MynhLoveBunCha/project_1_undergraduate/exploded_base_assembly.jpg

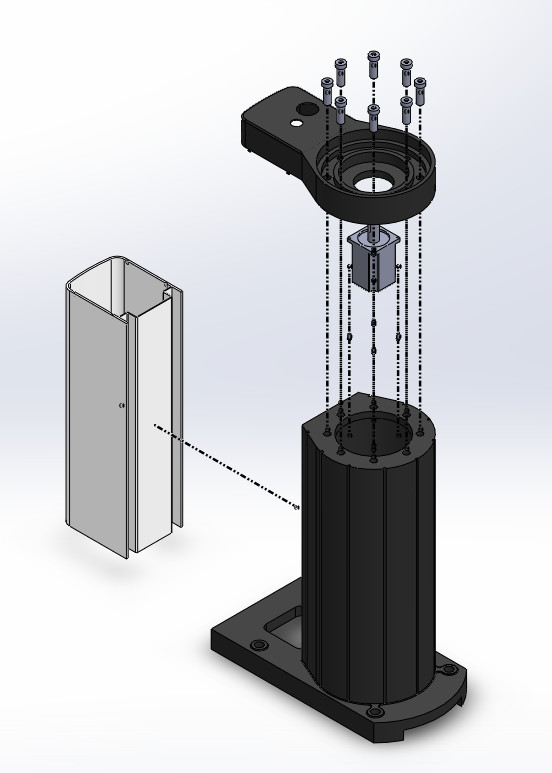
exploded_base_assembly.jpg
