MynhLoveBunCha/project_1_undergraduate/exploded_whole.jpg

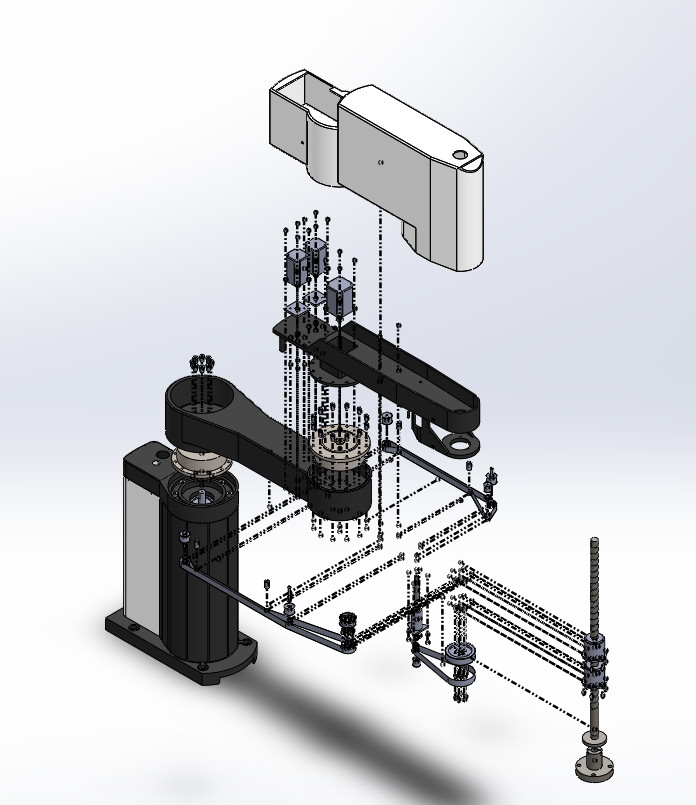
exploded_whole.jpg
