MynhLoveBunCha/project_1_undergraduate/README.md

# project_1_undergraduate
 Course project about mechanical design of a SCARA robot
