MynhLoveBunCha/project_1_undergraduate/tran_duy_minh_main_report.pdf

i

ii

LỜI CẢM ƠN

Nhóm chuyên môn: Thiết kế hệ thống cơ khí, Khoa Cơ điện tử, Trường Cơ khí, Đại học Bách khoa Hà Nội.
Dưới sự hướng dẫn nhiệt tình của TS.Nguyễn Hồng Thái em đã vận dụng những kiến thức đã được học trong chương trình đào tạo đại học, ĐH Bách Khoa Hà Nội để hoàn thành đề tài, nhờ đó em có thể hoàn thiện, tổng hợp kiến thức trước khi tốt nghiệp Đại Học.
Tuy nhiên với kiến thức chuyên môn còn hạn chế nên đề tài không thể tránh khỏi những thiếu sót và chưa thể hoàn thiện một cách hoàn hảo như ý muốn mong đợi. Mong được sự giúp đỡ và góp ý của các thầy để em có thể hoàn thiện hơn.
Để hoàn thành đồ án tốt nghiệp này em xin trân trọng cảm ơn tất cả các thầy cô giáo trong Đại Học Bách Khoa Hà Nội, nhất là các quý thầy cô trong Viện Cơ Khí, Bộ môn Cơ sở thiết kế máy và rôbốt, Trung tâm công nghệ cao BK-CNC đã hướng dẫn em trong suốt năm năm vừa qua. Em xin bày tỏ lòng biết ơn sâu sắc tới thầy giáo hướng dẫn TS. Nguyễn Hồng Thái, người đã tận tình hướng dẫn và tạo mọi điều kiện thuận lợi để em hoàn thành đồ án này.

Em xin trân trọng cảm ơn !

Hà Nội, ngày 2 tháng 8 năm 2023

Sinh viên

Trần Duy Minh

iii

### MỤC LỤC

DANH MỤC CÁC KÝ HIỆU VÀ CÁC TỪ VIẾT TẮT | 1
DANH MỤC CÁC HÌNH VẼ VÀ ĐỒ THỊ | 4
DANH MỤC CÁC BẢNG | 6
MỞ ĐẦU | 7
CHƯƠNG 1 BÀI TOÁN ĐỘNG HỌC | 8
1.1 CÁC THÔNG SỐ KĨ THUẬT CỦA ROBOT TURBO SCARA SR4/6/8 | 8
a) Giới thiệu về robot | 8
b) Cấu hình robot Turbo Scara SR8 plus | 9
c) Các thông số kĩ thuật robot Turbo Scara SR8 plus | 10
1.2 THIẾT LẬP PHƯƠNG TRÌNH ĐỘNG HỌC CỦA ROBOT | 12
a) Thiết lập hệ quy chiều và bảng thông số động học D-H | 12
b) Các ma trận biến đổi thuần nhất | 12
c)Phương trình động học | 14
d) Ví dụ áp dụng | 16
1.3 BÀI TOÁN MIỀN LÀM VIỆC | 18
a) Cơ sở lí thuyết | 18
b) Phương pháp hình học | 18
1.4 THIẾT LẬP BIỂU THỨC TÍNH VẬN TỐC TRỌNG TÂM CÁC KHÂU | 21
a) Vận tốc dài các khâu | 21
b) Vận tốc góc các khâu | 22
1.5 THIẾT LẬP BIỂU THỨC TÍNH GIA TỐC TRỌNG TÂM CÁC KHÂU | 24
a) Gia tốc dài | 24
b) Gia tốc góc | 24
1.6 KẾT LUẬN | 25
CHƯƠNG 2 PHÂN TÍCH TĨNH HỌC | 26
2.1 PHÂN TÍCH LỰC ROBOT | 26

2.2 THIẾT LẬP PHƯƠNG TRÌNH TRUY HỒI THEO PHƯƠNG PHÁP NEWTON-EULER 27

2.3 TÍNH LỰC VÀ MOMEN TẠI CÁC KHỚP | 28
2.3 KẾT QUẢ TÍNH TOÁN | 32
2.5 LỰA CHỌN KẾT CẤU SƠ BỘ | 35
2.5.1 Giới thiệu các loại hộp giảm tốc dùng trong robot | 35
a) Chọn bộ truyền động cho khớp 1 và khớp 2 | 35
b) Chọn bộ chuyền động cho khớp 3 và khớp 4 | 36
2.5.2 Bản vẽ sơ bộ các khâu của robot | 37
2.5.3 Xác định khối lượng, trọng tâm các khâu trên solidworks | 382
2.5.3 Xác định khối lượng, trọng tâm các khâu trên solidworks | 39

iv

3.1 THIẾT LẬP PHƯƠNG TRÌNH ĐỘNG LỰC HỌC BẰNG PHƯƠNG PHÁP NEWTON-

PHỤ LỤC |
A PHẦN LẬP TRÌNH MÔ PHỎNG |
B BẢN VẼ THIẾT KẾ |

DANH MỤC CÁC KÝ HIỆU VÀ CÁC TỪ VIẾT TẮT

Ký hiệu | Nội dung, ý nghĩa
s1 | : sin θ1
s2 | : sin θ 2
c1 | : cos θ1
c2 | : cos θ 2
s12 | : Sin ( θ1
+

θ 2
)

c12 : cos( θ1
+

θ 2
)

s12-4 : sin( θ1
+

θ 2 -

θ 4
)

c12-4 : cos( θ1
+

θ 2 -

θ 4
)
θ12 | : θ1 + θ 2
θ12-4 | :

θ1
+

θ 2 -

θ 4

i

i C
−1

: Ma trận biến đổi tọa độ từ hệ quy chiếu i về i-1

Ci

0

: Ma trận biến đổi tọa độ từ hệ quy chiếu i về hệ quy chiếu cố định 0

Ri

0

: Ma trận cosin chỉ hướng của khâu i đối với hệ quy chiếu cố định

i

i
r

−1

: Vecto thuần nhất vị trí trọng tâm khâu i đối với hệ quy chiếu cố định

Ci v

: Vận tốc dài tại trọng tâm của khâu thứ i

aCi

: Gia tốc tịnh tiến tại trọng tâm của khâu thứ i so với khâu gốc cố định

1

0
ε

: Gia tốc quay tại trọng tâm của khâu thứ i so với khâu gốc cố định

i

i
ω

−1

: Vận tốc góc của khâu thứ i so với khâu thứ i-1

ω i

0

: Vận tốc góc của khâu thứ i so với khâu gốc cố định

i

i
ω

−1 ~

: Ma trận đối xứng lệch của ma trận vận tốc của khâu thứ i so với khâu thứ i-1

K : Điểm cuối của khâu thao tác

DANH MỤC CÁC HÌNH VẼ VÀ ĐỒ THỊ

| Nội dung | Trang
Hình 1.1 | Một số loại Robot Scara hiện nay | 7
Hình 1.2 | Mô hình solidworks robot tubo scara SR8 | 8
Hình 1.3 | Cấu hình robot Tubo Scara SR8 | 9
Hình 1.4 | Hệ trục tọa độ Denavit-Hatenbeg | 11
Hình 1.5 | Tọa độ điểm cuối khâu thao tác | 13
Hình 1.12 Hình chiếu bằng của miền làm việc | 19
Hình 1.13 Miền làm việc 3D | 19
Hình 2.1 | Mô hình động học robot | 29
Hình 2.2 | Sơ đồ lựa chọn hộp giảm tốc bánh răng sóng | 38
Hình 2.3 | cấu tạo hộp giảm tốc bánh răng sóng loại 2UH | 39
Hình 2.4 | cấu tạo bộ truyền động tại khớp 3 và khớp 4 | 39
Hình 2.5 | Kết cấu sơ bộ khâu đế | 40
Hình 2.6 | Kết cấu sơ bộ khâu 1 | 40
Hình 2.7 | Kết cấu sơ bộ khâu 2 | 41
Hình 2.8 | Kết cấu sơ bộ khâu 3-4 | 41
Hình 2.9 | Kết cấu sơ bộ của Robot | 42
Hình 2.10 Khối lượng, trọng tâm khâu đế | 42
Hình 2.11 Khối lượng, trọng tâm khâu 1 | 43
Hình 2.12 Khối lượng, trọng tâm khâu 2 | 43
Hình 2.13 Khối lượng, trọng tâm khâu 3-4 | 44
Hình 2.14 Khối lượng tổng robot | 44
Hình 3.1 | Mô hình động lực học robot | 45

Hình 3.2 | Sơ đồ tính động lực hoc Newton-Euler
Hình 3.3 | Quỹ đạo đặt cho robot

Hình 3.10 Thông số kích thước hộp giảm tốc con lăn

Hình 4.1 Bản vẽ lắp tổng lắp

46

53

59

61

### DANH MỤC CÁC BẢNG

STT | Nội dung | Trang
Bảng 1.1 | Bảng các thông số kích thước Tubo Scara SR8 | 9
| | 11
Bảng 1.2 | Bảng D-H robot scara
Bảng 3.1 | Bảng thông số động lực rôbốt Scara 4 bậc tự do | 47
Bảng 3.2 | Các thông số kích thước hộp giảm tốc khớp 3 | 60
Bảng 3.3 | Các thông số kĩ thuật hộp giảm tốc khớp 3 | 60
Bảng 3.4 | Các thông số kích thước hộp giảm tốc khớp 4 | 60
Bảng 3.5 | Các thông số kĩ thuật giảm tốc khớp 4 | 60

### MỞ ĐẦU

I. Đặt vấn đề

Robot Scara ra đời vào năm 1979, đây là một kiểu tay máy có cấu tạo đặc biệt được sử dụng nhiều trong các công việc lắp ráp. Nó thực hiện những công việc đòi hỏi độ chính xác cao. Robot Scara đã và đang được ứng dụng và phát triển rộng rãi trên toàn thế giới, chúng được chế tạo và phát triển với quy mô lớn. Tuy nhiên, ở Việt Nam việc nghiên cứu và phát triển vẫn còn hạn chế cả ở các viện nghiên cứu và các trường đại học. Do nhu cầu thực tế và niềm say mê nghiên cứu dưới sự hướng tận tình của T.S Nguyễn Hồng Thái, Khoa Cơ điện tử - Trường Cơ khí - Đại học Bách khoa Hà Nội, chúng em lựa chọn đề tài “ Tính toán thiết kế robot Scara 4 bậc tự do”.

II. Mục đích nghiên cứu của đề tài

Mục đích của đề tài trước hết là tìm hiểu làm quen với việc nghiên cứu khoa học và áp dụng các kiến thức đã học vào thực tế. Trong quá trình nghiên cứu thực tế đề tài đã giúp chúng em nâng cao kiến, tiếp cận những vấn đề mới của thực tế cũng như làm nền tảng vững chắc cho kỹ sư cơ điện tử sau khi tốt nghiệp.

III. Phạm vi nghiên cứu của đề tài

- Tính toán động học, tĩnh học và động lực học, đưa mô hình robot vào phần mềm lập trình mô phỏng để kiểm chứng kết quả tính toán
- Thiết kế kết cấu robot dựa trên kết cấu của Robot Scara SR8

IV. Nội dung của đồ án

Nội dung của đồ án được chia làm 4 chương như sau:

Chương 1 : Bài toán động học.
Chương này trình bày bài toán động học thuận động học ngược, trình bày bài toán miền làm việc, tính toán vận tốc và gia tốc các khâu, mô phỏng động học của robot bằng matlab với dao diện Guide.

Chương 2 : Bài toán tĩnh học.
Chương này tình bày về bài toán tĩnh học, tính toán tĩnh học robot băng phương pháp Newton-Euler, chọn được hộp giảm tốc tại các khớp, đưa ra bản vẽ sơ bộ các khâu của robot, và xác định trong tâm các khâu bằng Solidworks.

Chương 3 : Bài toán động lực học.
Chương này trình bày bài toán động lực học, thiết lập phương trình truy hồi Newton-Euler cho robot, tính lực và momen tại các khớp, tính chọn hộp giảm tốc tại các khớp, tính toán kết cấu các trục.
Chương 4 : Tính toán thiết kế cơ khí.

Chương này trình bày các bản vẽ thiết kế của robot.

## Chương 1

## BÀI TOÁN ĐỘNG HỌC

### 1.1 CÁC THÔNG SỐ KĨ THUẬT CỦA ROBOT TURBO SCARA SR4/6/8

a) Giới thiệu về robot

Robot Scara là một trong những robot công nghiệp được sử dụng phổ biến nhất hiện nay. Chuyển động của robot này rất đơn giản nhưng lại phù hợp với các dây chuyền và ứng dụng hữu hiệu trong nhiệm vụ nhặt và đặt sản phẩm. Robot Scara (Selectively Compliant Articulated Robot Arm) có nghĩa là tay máy lắp ráp chọn lọc.
Cấu trúc động học loại tay máy này thuộc hệ phỏng sinh, có các trục quay, các khớp đều là thẳng đứng. Nó có cấu tạo hai khớp ở cánh tay, một khớp ở cổ tay và một khớp tịnh tiến. Các khớp quay hoạt động nhờ động cơ điện có phản hồi vị trí. Khớp tịnh tiến hoạt động nhờ xi-lanh khí nén, trục vít hoặc thanh răng.

Một số loại robot scara của các hãng sản xuất

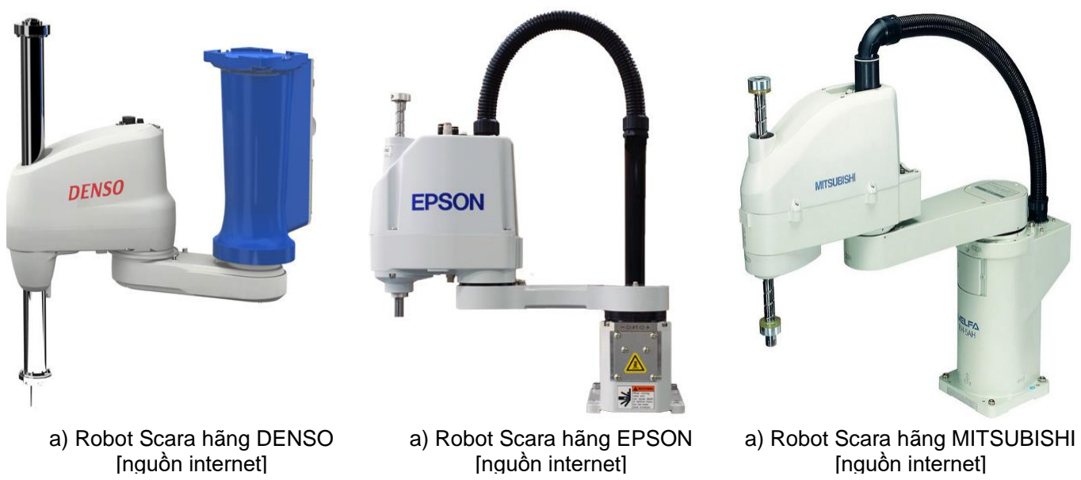
[picture p3: figure]
a) Robot Scara hãng DENSO [nguồn internet]; a) Robot Scara hãng EPSON [nguồn internet]; a) Robot Scara hãng MITSUBISHI [nguồn internet]

Trong phạm vi đồ án này tác giả đã sử dụng đối tượng Robot Turbo Scara SR8 Plus để nghiên cứu tính toán và thiết kế mô hình robot scara 4 bậc tự do với 3 bậc tự do quay với 1 bậc tự do tịnh tiến.

Robot Turbo Scara SR8 Plus là một loại Robot công nghiệp của hãng Rexroth thuộc tập đoàn Bosch Group, được trang bị những tính năng ưu việt trong đó phải kể đến như tính linh hoạt cao khi vận hành, phạm vi hoạt động rộng, khả năng ứng dụng rộng rãi vào quá trình dạy học và dây chuyền sản xuất, không gian làm việc lớn, độ chính xác cao, kết nối được các thiết bị ngoại vi như máy tính, PLC …, các cơ cấu được thiết kế khoa học tuân theo các tiêu chuẩn quốc tế và có tính thẩm mĩ cao.

Hình 1.1 Một số loại Robot Scara hiện nay b) Cấu hình robot Turbo Scara SR8 plus

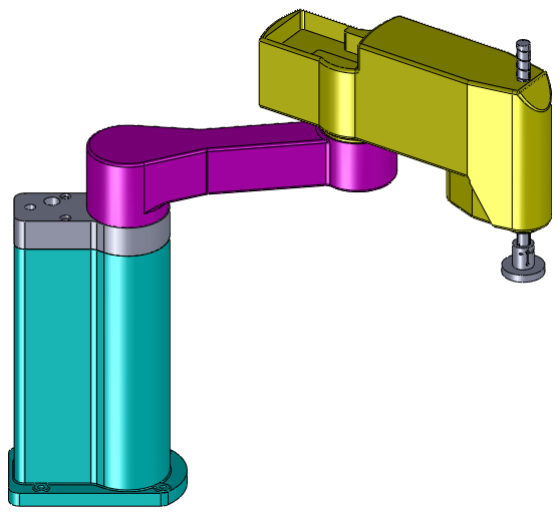
[picture p4: figure]

Robot Turbo Scara SR8 gồm 3 chuyển động quay và 1 khớp chuyển động tịnh tiến gắn cho mỗi khâu 1 hệ trục tọa độ như hình vẽ ta có.

- Khớp 1 quay xung quanh trục Z
0

một góc

θ 1

- Khớp 2 quay xung quanh trục Z
1

một góc

θ 2

- Khớp 3 chuyển động tịnh tiến dọc theo trục Z
2

một đoạn d
3
- Khớp 4 quay xung quanh trục Z
3

một góc

θ 4

Hình 1.2 Mô hình solidworks robot tubo scara SR8 c) Các thông số kĩ thuật robot Turbo Scara SR8 plus

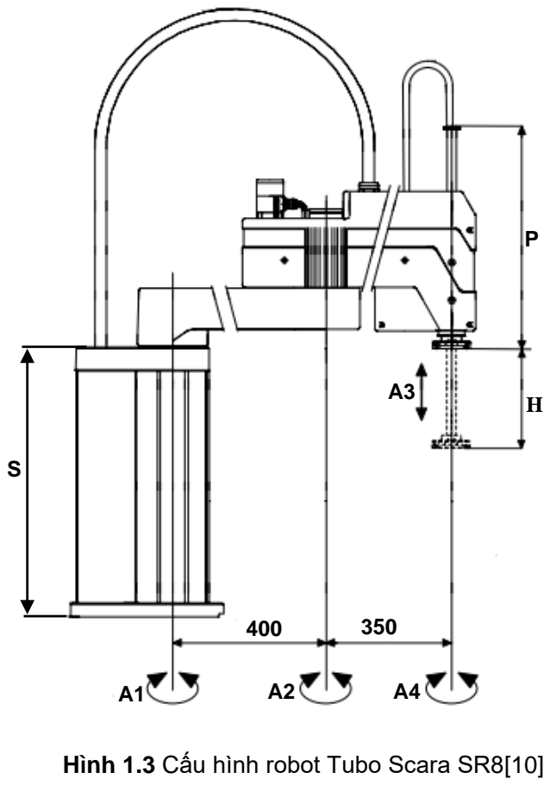
[picture p5: figure]

Tùy chọn | Thông số | Kí hiệu | Kích thước
Tiêu chuẩn | Chiều cao khâu đế | S | Tiêu chuẩn 500 tùy chọn 250-700
Hành trình trục 3 | H | 280 | 280 | 280
Chiều dài trục vít | P | 450 | 450 | 450
Chiều dày bích | F | 60 | 60 | 60
Chiều dài khâu 2 | a 1 | 400 | 400 | 400
Chiều dài khâu 3 | a 2 | 350 | 350 | 350

Bảng 1.1 Các thông số kích thước Tubo Scara SR8

Hình 1.3 Cấu hình robot Tubo Scara SR8[10]

Số bậc tự do | 4
Số khớp quay độc lập | 4
Tải trọng chuẩn | 2 | kg
Tải trọng tối đa | 6 | kg
Momen quán tính lớn nhất trục 4. | 1000 | Kg.cm 2
Momen xoắn (cho phép/lớn nhất) trục 4. | 8/10 | M.m
Lực dọc trục (liên tục/ tối đa) trục 4. | 300/350 | N
Lực ngang (liên tục/ tối đa) trục 4. | 60/120 | N
Góc quay giới hạn khâu 1 | +/- 150 |
Góc quay giới hạn khâu 2 | +/- 160 |
Giới hạn hành trình khâu 3 | 280 | mm
Góc quay giới hạn khâu 4 | +/- 180 |

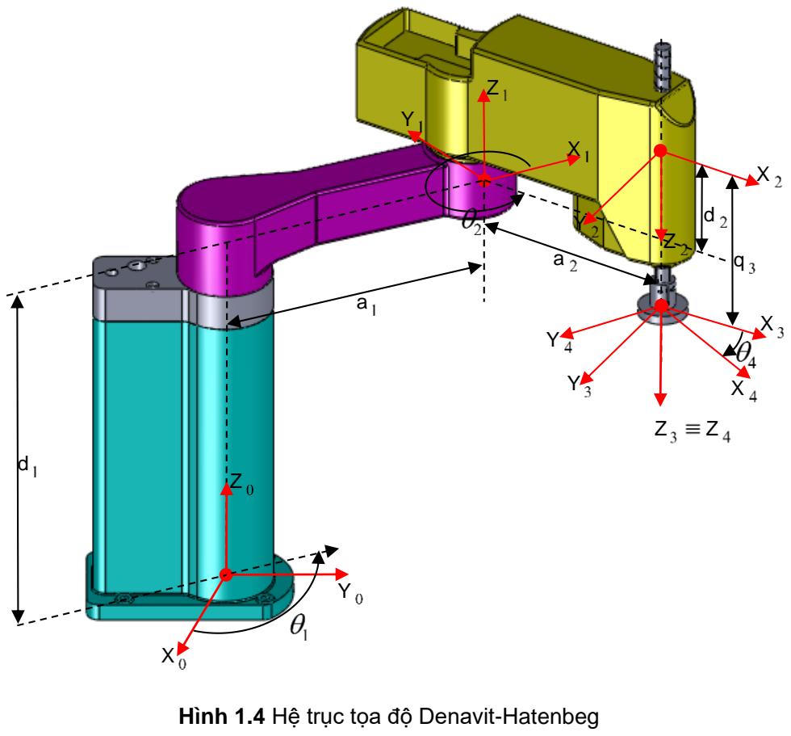
[picture p6: figure]

Bảng 1.2 Bảng D-H robot scara

### 1.2 THIẾT LẬP PHƯƠNG TRÌNH ĐỘNG HỌC CỦA ROBOT

a) Thiết lập hệ quy chiều và bảng thông số động học D-H

Xây dựng hên trục tọa độ Denavit-Hartenberg.

`

Với cách đặt hệ trục như hình 1.2 và quy tắc xác định các thông số động học theo D-H ta lập được bảng D-H.

Trục | di | θ i | ai | αi
1 | d1 | θ1 | a1 | 0
2 | d 2 | θ2 | a 2 | π
3 | q 3 | 0 | 0 | 0
4 | 0 | θ4 | 0 | 0
Trong đó: q3, θ1, θ2, θ4 là các biến khớp
b) Các ma trận biến đổi thuần nhất

Ma trận dạng tổng quát D-H của phép chuyển hệ tọa độ
Ri−1
sang

Ri
, là

i 1 Ai
−
có dạng
như sau:

Hình 1.4 Hệ trục tọa độ Denavit-Hatenbeg

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
0 | 0 | 0 | 1
0 | sin | cos
sin | cos cos | cos sin | sin
cos | sin | cos | sin | sin | cos 1

1

i | i | i
i | i | i | i | i | i | i
i | i | i | i | i | i

i

i
d

a

a

C
α | α
θ | θ | α | θ | α | θ
θ | θ | α | θ | α | θ

Thay thông số của từng khâu trên bảng D-H ta tìm được các ma trận chuyển tọa độ như sau.

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
0 | 0 | 0 | 1
0 | 0 | 1
sin | cos | 0 | sin
cos | sin | 0 | cos

1

1 | 1 | 1 | 1
1 | 1 | 1 | 1

1

0
d

a

a

C

θ | θ | θ
θ | θ | θ

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
0 | 0 | 0 | 1
0 | 0 | 1
sin | cos | 0 | sin
cos | sin | 0 | cos

2

2 | 2 | 2 | 2
2 | 2 | 2 | 2

2

1
d

a

a

C

θ | θ | θ
θ | θ | θ

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
0 0 0 1

0 0 1

0 1 0 | 0
1 0 0 | 0

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
0 | 0 | 0 1
0 | 0 | 1 0
sin | cos | 0 0
cos | sin | 0 0
4 | 4
4 | 4

4

3 | θ | θ
| θ | θ

C

Các phép biến đổi thuần nhất

0 C 2 =

0 C 1
1 C 2

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
− | +
+ | − | + | + | +
+ | | + | + | +
0 | 0 | 0 | 1
0 | 0 | 1
sin( | ) | cos( | ) | 0 | sin( ) | sin( | )
cos( | ) | sin( | ) | 0 | cos( ) | cos( | )
1 | 2
1 | 2 | 1 | 2 | 1 | 1 | 2 | 1 | 2
1 | 2 | 1 | 2 | 1 | 1 | 2 | 1 | 2
d | d
a | a
a | a
θ θ | θ θ | θ | θ θ
θ θ | θ θ | θ | θ θ

0 C 3 =

0 C 2
2 C 3

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
− | + | −
+ | − | + | + | +
+ | | + | + | +
0 | 0 | 0 | 1
0 | 0 | 1
sin( | ) | cos( | ) | 0 | sin( ) | sin( | )
cos( | ) | sin( | ) | 0 | cos( ) | cos( | )
1 | 2 | 3
1 | 2 | 1 | 2 | 1 | 1 | 2 | 1 | 2
1 | 2 | 1 | 2 | 1 | 1 | 2 | 1 | 2
d | d | d
a | a
a | a
θ θ | θ θ | θ | θ θ
θ θ | θ θ | θ | θ θ

0 C 4 =

0 C 3

3 C 4

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
− | + | −
+ | − | − | + | − | + | +
+ | − | | + | − | + | +
0 | 0 | 0 | 1
0 | 0 | 1
sin( | ) | cos( | ) | 0 | sin( | ) | sin
cos( | ) | sin( | ) | 0 | cos( | ) | cos
1 | 2 | 3
1 | 2 | 4 | 1 | 2 | 4 | 2 | 1 | 2 | 1 | 1
1 | 2 | 4 | 1 | 2 | 4 | 2 | 1 | 2 | 1 | 1
d | d | d
a | a
a | a
θ θ θ | θ θ θ | θ θ | θ
θ θ θ | θ θ θ | θ θ | θ

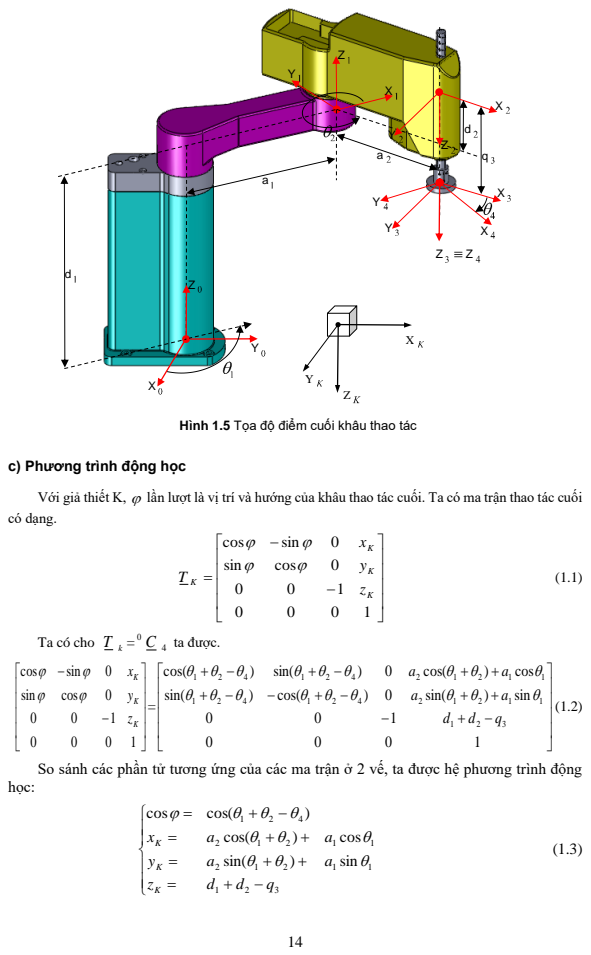
[picture p7: page 18]
sin; cos; ta được.; sin(; cos(

Hình 1.5 Tọa độ điểm cuối khâu thao tác

c) Phương trình động học

Với giả thiết K,
có dạng.

lần lượt là vị trí và hướng của khâu thao tác cuối. Ta có ma trận thao tác cuối

Ta có cho
So sánh các phần tử tương ứng của các ma trận ở 2 vế, ta được hệ phương trình động
học:

Nếu cho trước các giá trị biến khớp thay đổi theo thời gian, thì vị trí và hướng của khâu công tác (bàn kẹp) của robot SCARA trong mọi thời điểm sẽ hoàn toàn được xác định từ hệ phương trình (1.3).
- Đối với bài toán thuận ta cần tìm xK,yK,zK và
φ

Từ hệ phương trình động học ta có :

ï

ï
î

ï

ï
í

ì

= | + | −
= | + | −
= | + | +
= | + | +
1 | 2 | 4
K | 1 | 2 | 3
K | 2 | 1 | 2 | 1 | 1
K | 2 | 1 | 2 | 1 | 1
θ | θ | θ
z | d | q
y | a sin(θ | θ ) a sinθ
x | a cos(θ | θ ) a cosθ

φ

d

(1.4)

- Đối với bài toán ngược ta cần tìm
1 | 2 | 4 θ ,θ ,θ
, d3 với xK, yK, zK,
φ

đã biết

Từ (1.4) ta có :

î

í

ì

= | + | +
= | + | +
2 | 1 | 2 | 1 | 1
2 | 1 | 2 | 1 | 1
sin( | ) | sin
cos( | ) | cos
θ θ | | θ
θ θ | θ
y | a | a
x | a | a

K

K
(1.5)
Þ | [ | ] 1 2 | 1 | 2 | 1 | 1 | 2 | 1
2
2

2
1
2 | 2
xK | + yK

= a + a + 2a a (cos(θ +θ ) cosθ + sin(θ +θ )sinθ

1 2 | 2

2
2

2
1
2 | 2
xK | + yK

= a + a + 2a a cosθ

Þ

1 2

2
2

2
1
2 | 2

2
2

cos
a a
x | y | a | a K | + K | − | −
θ =

2

2
2

sinθ = ± 1− cos θ

Vậy

2 | tan2(sin ;cos ) θ | θ2 | θ2 = a

Khi biết
θ 2

ta viết lại (4) :

2 | 1 2 | 1 2 | 1 1
2 | 1 2 | 2 1 | 1 1
( | )
( | )

K

K

x | a c c | s s | a c
y | a s c | s c | a s
ì = | − | + í
î = | + | +

(1.6)

với
î

í

ì

= | =
= | =
1 | 1 | | 2
1 | 1 | 2 | 2
cos , 2 cos
sin , | sin
| θ | | θ
| θ | | θ
c | c
s | s
;
î

í

ì

+ | + | =
+ | − | =

K

K
a s c | a c | a s | y
a c | a c | a s s | x
2 2 1 | 2 2 | 1 | 1
2 2 | 1 | 1 | 2 2 1
( | )
( | )

Từ hệ phương trình (1.6) giải ra ta được :

2
2 2

2
2 2 | 1
2 2 | 2 2 | 1
2 2 | 1 | 2 2
(a c | a ) | (a s )
a s | a c | a
a c | a | a s
= | + | +
+

+ −
Δ =
2 2 | 1 | 2 2
2 2 | 1

2 2
1
x (a c | a ) y a s
y | a c | a
x | a s
K | K
K

K
= | + | +
+

−
Δ =
Þ | 2

2

2
2

2
2 2 | 1
2 2 | 1 | 2 2
1
( | )
( | )
a c | a | a s
x a c | a | y a s
c
K | | K
+ | +
+ | +
=
K | K
K

K
a c | a y | a s x
a s | y
a c | a | x
2 2 | 1 | 2 2
2 2
2 2 | 1
2 | = ( | + ) | −

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
2 2 | 1
2 2 | 1 | 2 2
1
( | )
( | )
a c | a | a s
a c | a y | a s x
s
K | K
+ | +
+ | −
=

Suy ra:

tan2( ; )

1 | 1 | 1 θ = a | s c

Từ đó có

θ 4 =θ1 +θ 2 −φ

K q = d + d − z 3 | 1 | 2

Vậy nghiệm của bài toán ngược là:

ï

ï
î

ï

ï
í

ì

= | + | −
= | + | −

=

=

K q | d | d | z

a

a

3 | 1 | 2
4 | 1 | 2
2 | 2 | 2
1 | 1 | 1
tan2(sin ;cos )

tan2(sin ;cos )

θ | θ θ φ
θ | θ | θ
θ | θ | θ

(1.7)

với

1 2

2
2

2
1
2 | 2

2
2

cos
a a
xK | + yK | − a − a
θ = | ,
2

2
2

sinθ = ± 1− cos θ

d) Ví dụ áp dụng.

Với các thông số kích thước của robot scara SR8

### a1 = 0.400; a2 = 0.350; d1 = 0.450; d2 = 0.100

- Bài toán thuận:
Giả sử ta cho giá trị của các biến khớp lần lượt như sau

3

2
; | 0.100;
2

;
3
1 | 2 | 3 | 3 | 4

π
θ

π
θ

π
θ = | = | q = d = | =

Từ phương trình động học thuận

ï

ï
î

ï

ï
í

ì

= | + | −
= | + | −
= | + | +
= | + | +
1 | 2 | 4
K | 1 | 2 | 3
K | 2 | 1 | 2 | 1 | 1
E | 2 | 1 | 2 | 1 | 1
θ | θ | θ
z | d | q
y | a sin(θ | θ ) a sinθ
x | a cos(θ | θ ) a cosθ

φ

d

(1.8)

Ta tính được vị trí và hướng của điểm tác động cuối của robot

{

xE = -0.175√3+0.200 = −0.103
yK = | 0.175+0.200√3 = 0.5214
zK = | 0.45
φ = | π
| 6

(1.9)

- Bài toán ngược:
Giả sử quỹ đạo chuyển động của điểm tác động cuối robot là một đường tròn có phương trình

ï
î

ï
í

ì

=

= | +
= | +
z | t
y | t
x | t

K

K

K

0,1.

0,2 0,1.sin(3 )

0,2 0,1.cos(3 )
(1.10)

Và góc của khâu thao tác cuối có giá trị cố định là

6

π
φ K

=

Từ hệ phương trình động học ngược của robot ta có giá trị của các biến khớp là hàm theo thời gian như sau.

ï

ï
î

ï

ï
í

ì

= | + | −
= | + | −

=

=

K q | d | d | z

a

a

3 | 1 | 2
4 | 1 | 2
2 | 2 | 2
1 | 1 | 1
tan2(sin ;cos )

tan2(sin ;cos )

θ | θ θ φ
θ | θ | θ
θ | θ | θ

(1.21)

Với

1 2

2
2

2
1
2 | 2

2
2

cos
a a
xK | + yK | − a − a
θ =
2

2
2

sinθ = ± 1− cos θ

2
2

2
2

2
2 2 | 1
2 2 | 1 | 2 2
1
( | )
( | )
a c | a | a s
x a c | a | y a s
c
K | | K
+ | +
+ | +
=
2
2

2
2

2
2 2 | 1
2 2 | 1 | 2 2
1
( | )
( | )
a c | a | a s
a c | a y | a s x
s
K | K
+ | +
+ | −
=

### 1.3 BÀI TOÁN MIỀN LÀM VIỆC

a) Cơ sở lí thuyết

Miền làm việc của robot là vùng không gian hoạt động của robot mà tại mỗi vị trí trong không gian đó robot vẫn hoạt động bình thường với đầy đủ tất cả các bậc tự do. Có rất nhiều phương pháp tính miền làm việc khác nhau như phương pháp hình học, phương pháp giải tích, phương pháp số. Tuy nhiên trong đồ án em chỉ sử dụng phương pháp hình học.

b) Phương pháp hình học

Từ phương trình tọa độ khâu thao tác cuối.
{
xK = a2 cos( θ1 + θ2) + a1 cos θ1 yK = a2 sin( θ1 + θ2) + a1 sin θ1
zK = | d1 + d2 − q3

(1.8)

Tùy vào giá trị của các biến khớp mà ta có được không gian làm việc của Robot. Do đó giải bài toán tìm không gian làm việc của Robot ta cần phải có giới hạn giá trị của các biến khớp. Theo phương trình (1.7) thì miền chỉ cần xét trong không gian mặt phẳng (Oxy) sau đó kéo lên theo phương trục z tùy theo giá trị ZK được quy định bởi giá trị biến khớp d3 sẽ được miền làm việc của Robot.

Xét trong mặt phẳng Oxy, ta tìm miền mà tọa độ
K K

x , y
nằm trong đó với điều kiện.

î

í

ì

= | + | +
= | + | +
2 | 1 | 2 | 1 | 1
2 | 1 | 2 | 1 | 1
sin( | ) | sin
cos( | ) | cos
θ θ | θ
θ θ | θ
y | a | a
x | a | a

K

K

Với các góc quay giới hạn của các khớp θ1 = ±150

∘
; θ2 = ±160

∘
. Ta xây dựng được miền tọa độ x, y sau đó kéo dài miền tọa độ x, y theo chiều trục z ta được miền làm việc của robot. Có nhiều phương pháp để mô phỏng miền làm việc, trong đồ án này tác giả mô phỏng miền làm việc sử dụng phần mềm Matlab.
Bước 1 : Khai báo nhưng thông số kích thước cố định, d1 = 450mm; d2 = 100mm; a1 = 400mm; a2 = 350mm
Bước 2 : Tạo các vector chứa phân bố của các điểm nằm trong miền làm việc dựa vào các giới hạn đã nêu ở phần các thông số kĩ thuật, θ1 = ±150o

; θ2 = ±160o

; θ1 = ±180o
; q3 = 280mm
Bước 3 : Dùng các phép toán trên ma trận để biểu diễn hệ phương trình tọa độ khâu thao tác cuối
(1.8) trong Matlab
Bước 4 : Dùng hàm plot3 để vẽ miền làm việc.
Hình dưới đây là đoạn chương trình trong Matlab và miền làm việc đã được mô phỏng.

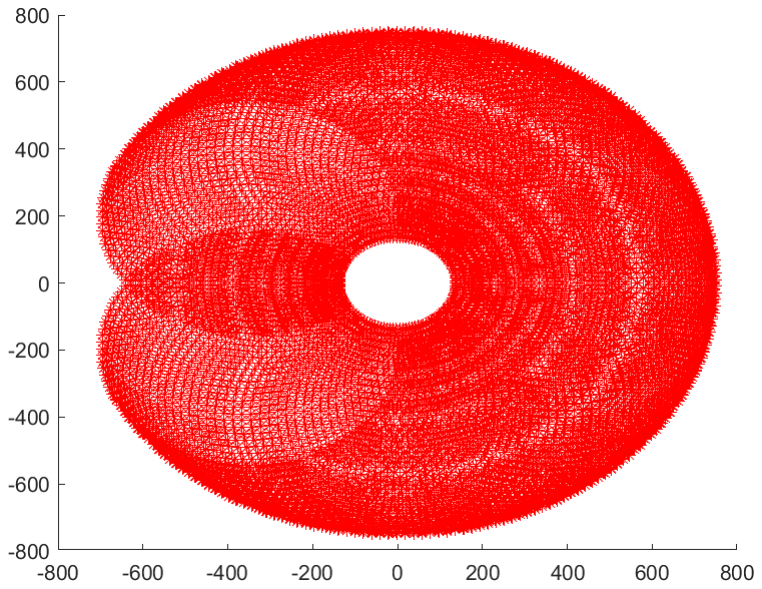
[picture p8: figure]

Hình 1.11 Hình chiếu bằng của miền làm việc

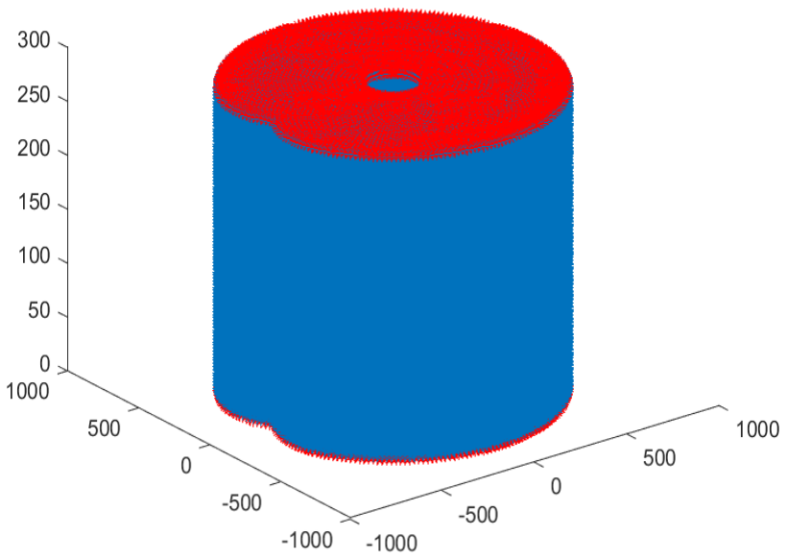
[picture p9: figure]

Hình 1.11 Hình chiếu trục đo của miền làm việc

### 1.4 THIẾT LẬP BIỂU THỨC TÍNH VẬN TỐC TRỌNG TÂM CÁC KHÂU

a) Vận tốc dài các khâu

Ta có tọa độ trọng tâm của các khâu dược tính theo công thức sau.

0
r Ci
=

0 C i

i
r Ci
(1.9)

0
r Ci

là vectơ thuần nhất tọa độ trọng tâm của các khâu.

i
r Ci

là vectơ thuần nhất tọa độ trọng tâm của khâu i trên hệ tọa độ gắn liền với khau i.

i
r Ci
=[ | 1] Ci
i
Ci

i
Ci
iX | Y | Z

T

- Vận tốc trọng tâm khâu 1.

Ta có

0
r C1 =

0 C 1

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
é | −
0 | 0 | 0 | 1
0 | 0 | 1
sin | cos | 0 | sin
cos | sin | 0 | cos

1

1 | 1 | 1 | 1
1 | 1 | 1 | 1

d

a

a
θ | θ | θ
θ | θ | θ

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
é− −

1

0

0

( | ) 1 | 1 a | l

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
1 | 1
1 | 1

d

l

l
θ

θ

Đạo hàm theo thời gian biểu thức trên trong hệ quy chiếu cố định ta được.

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
1 | 1
1 | 1
θ | θ
θ | θ

l

l

Lấy 3 hàng trong một cột trên ta được vận tốc trọng tâm khâu thứ nhất.

0
v C1 =
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
1 | 1
1 | 1
θ | θ
θ | θ

l

l

- Vận tốc trọng tâm khâu 2.

Ta có

0
r C 2 =

0 C 2

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
− | +
+ | | + | + | +
+ | − | + | + | +
0 | 0 | 0 | 1
0 | 0 | 1
sin( | ) | cos( | ) | 0 | sin( ) | sin( | )
cos( | ) | sin( | ) | 0 | cos( ) | cos( | )
1 | 2
1 | 2 | 1 | 2 | 1 | 1 | 2 | 1 | 2
1 | 2 | 1 | 2 | 1 | 1 | 2 | 1 | 2
d | d
a | a
a | a
θ θ | θ θ | θ | θ θ
θ θ | θ θ | θ | θ θ

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
é− −

1

0

0

( | ) 2 | 2 a | l

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
+ | +
+ | +

1

sin | sin( | )
cos | cos( | )
1 | 2
1 | 1 | 2 | 1 | 2
1 | 1 | 2 | 1 | 2
d | d
a | l
a | l
θ | θ θ
θ | θ θ

Đạo hàm theo thời gian biểu thức trên trong hệ quy chiếu cố định ta được.

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
+ | + | +
− | − | + | +

0

0

cos | ( | ) cos( | )
sin | ( | )sin( | )
1 1 | 1 | 2 | 1 | 2 | 1 | 2
1 1 | 1 | 2 | 1 | 2 | 1 | 2
θ | θ | θ θ | θ θ
θ | θ | θ θ | θ θ
a | l
a | | l

Lấy 3 hàng trong một cột trên ta được vận tốc trọng tâm khâu thứ hai.

0
v C 2 =
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
+ | + | +
− | − | + | +

0

cos | ( | )cos( | )
sin | ( | )sin( | )
1 1 | 1 | 2 | 1 | 2 | 1 | 2
1 1 | 1 | 2 | 1 | 2 | 1 | 2
θ | θ | θ θ | θ θ
θ | θ | θ θ | θ θ
a | l
a | | l
- Vận tốc trọng tâm khâu 3 và khâu 4.

Do trọng tâm khâu 3
≡

khâu 4 nên ta chỉ xét vận tốc trọng tâm khâu 3.

Ta có

0
r C3 =

0 C 3

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
− | + | −
+ | | + | + | +
+ | − | + | + | +
0 | 0 | 0 | 1
0 | 0 | 1
sin( | ) | cos( | ) | 0 | sin( ) | sin( | )
cos( | ) | sin( | ) | 0 | cos( ) | cos( | )
1 | 2 | 3
1 | 2 | 1 | 2 | 1 | 1 | 2 | 1 | 2
1 | 2 | 1 | 2 | 1 | 1 | 2 | 1 | 2
d | d | q
a | a
a | a
θ θ | θ θ | θ | θ θ
θ θ | θ θ | θ | θ θ

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
+ | + | −
+ | +
+ | +

1

sin | sin( | )
cos | cos( | )
1 | 2 | 4 | 3
1 | 1 | 2 | 1 | 2
1 | 1 | 2 | 1 | 2
d | d | l | q
a | a
a | a
θ | θ θ
θ | θ θ

Đạo hàm theo thời gian biểu thức trên trong hệ quy chiếu cố định ta được.

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
+ | + | +
− | − | + | +

0

cos | ( | )cos( | )
sin | ( | )sin( | )

3

1 1 | 1 | 2 | 1 | 2 | 1 | 2
1 1 | 1 | 2 | 1 | 2 | 1 | 2

q

a | a
a | a

θ | θ | θ θ | θ θ
θ | θ | θ θ | θ θ

Lấy 3 hàng trong một cột trên ta được vận tốc trọng tâm khâu thứ ba vả khâu thứ tư.

0
v C3 =
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
+ | + | +
− | − | + | +

3

1 1 | 1 | 2 | 1 | 2 | 1 | 2
1 1 | 1 | 2 | 1 | 2 | 1 | 2
cos | | ( | | ) cos( | | )
sin | ( | )sin( | )

q

a | a
a | a

θ | θ | θ θ | θ θ
θ | θ | θ θ | θ θ
b) Vận tốc góc các khâu
- Cơ sở lý thuyết.
Từ ma trận Denavit-Hatenberg ta suy ra ma trận cosin chỉ hướng của các khâu bằng cách lấy ma trận vuông cấp 3 từ trên bên trái của ma trận
C i
ta được ma trận cosin chỉ hướng của các khâu .

Ta có công thức
i

T
ω i

= Ri R

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
b | a
c | a
c | b
ω i | Þ ω = [a b c]
T
- Xét khâu thứ nhất.

Ta có

R 1 =
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
é | −
0 | 0 | 1
sin | cos | 0
cos | sin | 0
1 | 1
1 | 1
θ | θ
θ | θ
Þ 1 | 1 | 1
~ | R R T
ω = | =
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
0 | 0 | 1
sin | cos | 0
cos | sin | 0
1 | 1
1 | 1
θ | θ
θ | θ

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
− | −
0 | 0 | 0
cos | sin | 0
sin | cos | 0
1 | 1 | 1 | 1
1 | 1 | 1 | 1
θ | θ | θ | θ
θ | θ | θ | θ

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
é | −
0 | 0 | 0
| 0 | 0
0 | 0

1

1
θ

θ

Vậy ta có vận tốc góc của khâu thứ nhất là.

ω1
= [0 0

θ1

]

T

- Xét khâu thứ hai và khâu thứ ba
Do khâu ba là khâu tịnh tiến nên vận tốc góc của khâu 3= vận tốc góc khâu 2.

R 2 = R 3 =
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
+ | | +
+ | − | +
0 | 0 | 1
sin( | ) | cos( | ) | 0
cos( | ) | sin( | ) | 0
1 | 2 | 1 | 2
1 | 2 | 1 | 2
θ θ | θ θ
θ θ | θ θ
2 | 2 | 2
~ | R R T
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
− | + | +
+ | +
0 | 0 | 1
sin( | ) cos( | ) | 0
cos( | ) | sin( | ) | 0
1 | 2 | 1 | 2
1 | 2 | 1 | 2
θ θ | θ θ
θ θ | θ θ

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
+ | + | − | + | +
− | + | + | − | + | +
0 | 0 | 0
( | )cos( | ) | ( | )sin( | ) 0
( | )sin( | ) | ( | )cos( | ) 0
1 | 2 | 1 | 2 | 1 | 2 | 1 | 2
1 | 2 | 1 | 2 | 1 | 2 | 1 | 2
θ θ | θ θ | θ θ | θ θ
θ θ | θ θ | θ θ | θ θ

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
− | +
0 | 0 | 0
| 0 | 0
0 | ( | ) 0
1 | 2
1 | 2
θ θ

θ θ

Vậy ta có vận tốc góc của khâu thứ hai và khâu thứ ba là.

ω 2 =ω 3 = [0 0
θ1
+

θ 2

]

T

- Xét khâu thứ tư

R 4 =
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
+ | − | − | + | −
+ | − | | + | −
0 | 0 | 1
sin( | ) | cos( | ) | 0
cos( | ) | sin( | ) | 0
1 | 2 | 4 | 1 | 2 | 4
1 | 2 | 4 | 1 | 2 | 4
θ θ θ | θ θ θ
θ θ θ | θ θ θ
4 | 4 | 4
~ | R R T
ω = | =
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
− | − | − | −
− | −
0 | 0 | 1
sin( | ) | cos( | ) | 0
cos( | ) | sin( | ) | 0
12 4 | 12 4
12 4 | 12 4
θ | θ
θ | θ

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
− | −
− | − | − | −
− | − | − | −
0 | 0 | 1
cos( | ) | sin( | ) | 0
sin( | ) | cos( | ) | 0
12 4 | 12 4 | 12 4 | 12 4
12 4 | 12 4 | 12 4 | 12 4
θ | θ | θ | θ
θ | θ | θ | θ

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
+ | −
− | + | −
0 | 0 | 0
| 0 | 0
0 | ( | ) 0
1 | 2 | 4
1 | 2 | 4
θ θ θ

θ θ θ

Vậy ta có vận tốc góc của khâu thứ tư là.

ω 4 = [0 0

θ1

+

θ 2

θ4
- − ]
T

### 1.5 THIẾT LẬP BIỂU THỨC TÍNH GIA TỐC TRỌNG TÂM CÁC KHÂU

a) Gia tốc tịnh tiến.

Đạo hàm vận tốc dài trọng tâm các khâu theo thời gian ta được gia tốc trọng tâm các khâu lần lượt là.
- Khâu 1

0
v C1 =
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
1 | 1
1 | 1
θ | θ
θ | θ

l

l
Þ C1 a =
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
− | −
| 0
| 2
1 1 1 | 1 1 1

2
1 1 1 | 1 1 1
θ | θ
θ | θ
l c | l s
l s | l c
- Khâu 2

0
v C 2 =
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
+ | + | +
− | − | + | +

0

cos | ( | ) cos( | )
sin | ( | )sin( | )
1 1 | 1 | 2 | 1 | 2 | 1 | 2
1 1 | 1 | 2 | 1 | 2 | 1 | 2
θ | θ | θ θ | θ θ
θ | θ | θ θ | θ θ
a | l
a | | l
Þ | 2

0
| C a =
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
+ | − | −
− | − | − | −
| | 0

2
1 1 1

2
2 12 12 | 1 1 1 | 2 12 12

2
1 1 1

2
2 12 12 | 1 1 1 | 2 12 12
θ | θ | θ | θ
θ | θ | θ | θ
l c | a c | l s | a s
l s | a s | l c | a c
- Khâu 3 và khâu 4

0
v C3 =
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
+ | + | +
− | − | + | +

3

1 1 | 1 | 2 | 1 | 2 | 1 | 2
1 1 | 1 | 2 | 1 | 2 | 1 | 2
cos | | ( | | )cos( | | )
sin | ( | )sin( | )

q

a | a
a | a

θ | θ | θ θ | θ θ
θ | θ | θ θ | θ θ

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
+ | − | −
− | − | − | −
=

3

2
1 1 1

2
2 12 12 | 1 1 1 | 2 12 12

2
1 1 1

2
2 12 12 | 1 1 1 | 2 12 12

3

0

q

a c | a c | a s | a s
a s | a s | a c | a c
aC
θ | θ | θ | θ
θ | θ | θ | θ
b) Gia tốc góc

Đạo hàm vận tốc góc các khâu theo thời gian ta được gia tốc góc các khâu lần lượt là.

- Khâu 1

ω1

=[0 0

θ1

]

T →ε 1 = ω1
=[0 0

θ1

]

T

- Khâu 2 và khâu 3

ω 2

=ω 3
=[0 0

θ1

+

θ 2

]

## T → ε 2 = ε 3 = ω 2

- =ω
3

=
[0 0

θ1

θ 2

+
]

T

- Khâu 4

ω 4

=[0 0

θ1

+

θ 2

4

θ

- − ]
T → ε 4 = ω 4
=[0 0

θ1

θ2

θ4

+ − ]
T

### 1.6 KẾT LUẬN

Như vậy trong chương 1 em đã trình bày được cách tìm tọa độ điểm cuối và góc quay của điểm cuối bẳng bài toán động học thuận, động học ngược.

Trình bày và minh họa được miền làm việc của robot.

Tính toán vận tốc và gia tốc các khâu của robot.

## Chương 2

## PHÂN TÍCH TĨNH HỌC

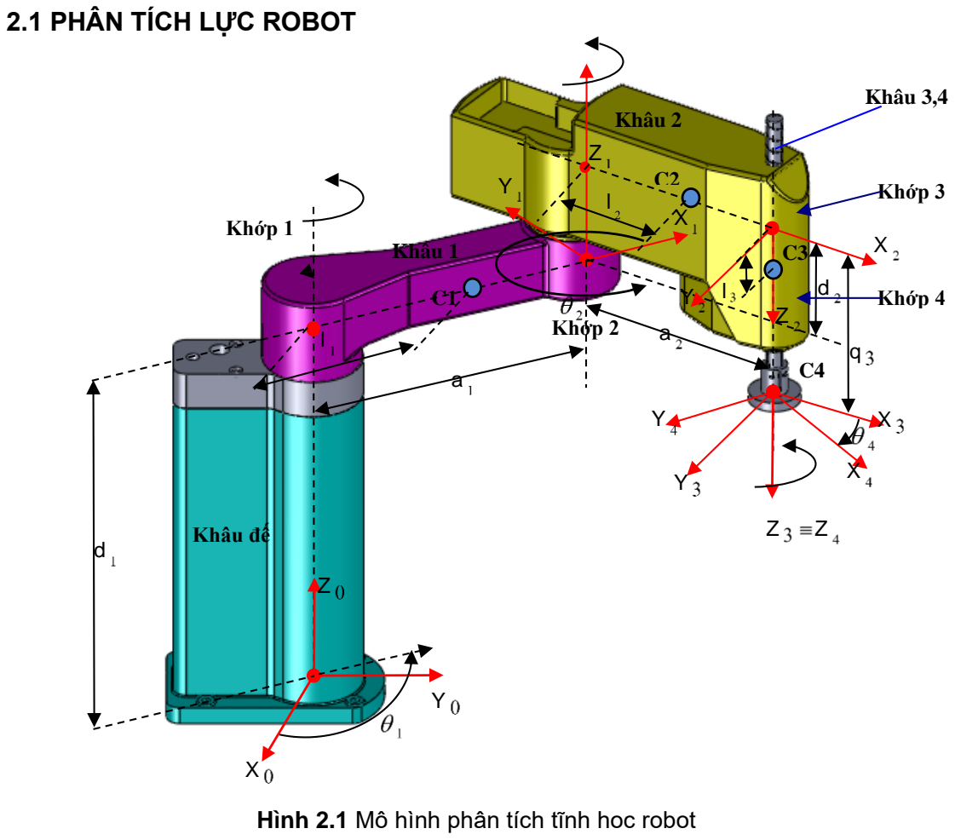
[picture p10: figure]
2.1 PHÂN TÍCH LỰC ROBOT; Khớp 1; Khớp 2; Khâu đế; Khâu 1; Khâu 2; Khâu 3,4; Khớp 3; Khớp 4

Khi robot cấu trúc hở thực hiện một nhiệm vụ khâu thao tác cuối cần pải có lực và mômen để thực hiện nhiệm vụ. Lực và mômen này được hình thành từ các lực liên kết tại các khớp. Trong robot chuỗi động học hở lực được truyền các khâu đến cơ cấu chấp hành. Như vậy bài toán tĩnh học là rất quan trọng cho biết khả năng tải của robot.
Bài toán này cho phép xác định phản lực tại các khớp nhằm xác định kích thước của khớp và khâu đồng thời chọn bộ truyền động thích hợp khi thiết kế.
Trong robot chuỗi động học hở mỗi khâu được nối với hai khâu khác bởi khớp quay hoặc khớp tịnh tiến trừ khâu thao tác cuối hoặc khâu cố định. Lực và momen tác dụng từ khâu i nên khâu i-1 và khâu i+1 thông qua khớp i và khớp i+1 đồng thời các khâu này cũng tác động nên khâu i một phản lực tương ứng.

Nếu gọi
Fi,i+1
là hợp lực tác động của khâu i nên khâu i+1 xét tại
i

o
khi đó ta có

F i,i+1 = −F i+1,i
(lực tác động của khâu i+1 nên khâu i)

M i,i+1
là momen tổng tác động từ khâu i nên khâu i+1 xét tại
i

o
khi đó ta có

M i,i+1 = −M i+1,i
(momen tác động của khâu i+1 nên khâu i)

Với cách đặt như trên ta có

Hình 2.1 Mô hình phân tích tĩnh hoc robot

27 F1,0
và

F1,0
lần lượt là lực và momen từ khâu đầu tiên tác dụng nên khâu đế cố định

Và

Fn,n−1
và

Fn,n−1
lần lượt là lực và momen từ khâu tác động cuối khâu kế tiếp phía trước

Như vậy ta có phương trình cân bằng lực của khâu i có dạng

F −1, − F +1,

+ m g = 0 i | i | i | i | i
(2.1)

Và phương trình cân bằng momen xét tại
i

o
có dạng

0

~ | ~ M i−1,i − M i+1,i − r i F i−1,i + r Pimi
g = | (2.2)

Với
g
là gia tốc trọng trường

mi
là khối lượng khâu i

i

r

~
là ma trận sóng của véc tơ định vị vị trí gốc
i

o
trong hệ quy chiếu (
i−1

## oxyz

)

Pi r

~
là ma trận sóng của véc tơ định vị vị trí trọng tâm khâu i trong hệ quy chiếu (
i

## oxyz

)

Với robot chuỗi động học hở từ (1) và (2) ta sẽ viết được 2n phương trình nhưng lai có 2(n+1) phản lực và momen.
Mặt khác khi khâu thao tác thực hiện một nhiệm vụ nó sẽ phải sinh ra một lực hoặc momen để

tác động đến đối tượng do đó hoàn toàn xác định được

Fn+1,n
và

M n+1,n
từ đó viết phương trình
(1) và (2) cho khâu cuối từ đó giải ngược về khâu cố định đây được gọi là phương pháp đệ quy.

Ta gọi
F i,i−1

là tổ hợp lực và momen tại gốc
i−1

o

F i,i−1= | ú
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
(2.3)

### 2.2 THIẾT LẬP PHƯƠNG TRÌNH TRUY HỒI THEO PHƯƠNG PHÁP NEWTON-EULER

Như đã nói ở trên phương pháp này xác định phản lực và momen tại các khớp một cách tuần tự từ khâu tác động cuối về đến khâu cố định do đó phương trình (1) và (2) được viết lai dưới dạng đệ quy.

ïî

ï
í

ì

= | + | −
= | −
− | + | −
− | +

,

0 | 0
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
i i | i | i | i | i i | Pi
i i | i | i | i
M | M | r | F | r | mg
F | F | m g
(2.4)

Hệ phương trình (2.4),(2.5) được viết trong hệ quy chiếu cố định còn phương trình (2.1) và (2)

được viết trong hệ quy chiếu động gắn trực tiếp với khâu i. Với
| | | | | i

r
là vecto có gốc
i−1

o
nối với
i

o

được xác định theo phương pháp D-H.

i

r =[ | ]
T
i | i | i | i | i
a | d sinα d cosα | (2.5)

Và với
Pi r

là véctơ tọa độ trọng tâm của khâu i trên hệ quy chiếu gốc
i

o

Với
i

r

0
và

Pi r

0
là véc tơ định vị của khớp i và véc tơ định vị trọng tâm khâu i tính theo hệ

quy chiếu cố định. Và
i

r

0
, Pi r

0
được tính theo công thức

i

r

0
= | i | i R .r

0
(2.6)

Pi r

0
= | i | Pi R .r

0
(2.7)

Với
R

là ma trận quay biến đổi từ hệ tọa độ 0 đến hệ tọa độ thứ i được lấy từ ma trân C

của
bài toán động học.
Như vậy hệ (2.4) được viết lần lượt cho từng khâu, từng khớp bắt đầu từ khâu thao tác tới khâu cố định ta sẽ xác định được các phản lực là các lực và momen tại các khớp của robot.
Ngoài ra cũng có thể tình phản lực liên kết ngay trong hệ quy chiếu gắn với khâu. Khi đó
(2.4) được viết lại dưới dạng.

ïî

ï
í

ì

= | + | −
= | −
− | + | −
− | +

,

, 1 | 1, | , 1
, 1 | 1,

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
i i | i | i
i | i | i

i
i i

i

M | M | r | F | r | mg
F | F | m g

### 2.3 TÍNH LỰC VÀ MOMEN TẠI CÁC KHỚP

- Tính lực và momen tại khớp 4
Ta có:

F

K,4 =[ | ]
T
Fx | Fy | F
z

;
F
K,4 = [ | ]
T M x | M y | M
z

3

r

4 =[ ]
T
0 0 0 | ; | 4

r

c4 =[ | ]
T
l
4

0 0 −

0 C 4
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
− | + | −
+ | − | − | + | − | + | +
+ | − | | + | − | + | +
0 | 0 | 0 | 1
0 | 0 | 1
sin( | ) | cos( | ) | 0 | sin( | ) | sin
cos( | ) | sin( | ) | 0 | cos( | ) | cos
1 | 2 | 3
1 | 2 | 4 | 1 | 2 | 4 | 2 | 1 | 2 | 1 | 1
1 | 2 | 4 | 1 | 2 | 4 | 2 | 1 | 2 | 1 | 1
d | d | q
a | a
a | a
θ θ θ | θ θ θ | θ θ | θ
θ θ θ | θ θ θ | θ θ | θ
Þ | 4

0
| R =
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
+ | − | − | + | −
+ | − | | + | −
0 | 0 | 1
sin( | ) | cos( | ) | 0
cos( | ) | sin( | ) | 0
1 | 2 | 4 | 1 | 2 | 4
1 | 2 | 4 | 1 | 2 | 4
θ θ θ | θ θ θ
θ θ θ | θ θ θ

4

0
r = 4

3
4

0
R . r =
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
+ | − | − | + | −
+ | − | | + | −
0 | 0 | 1
sin( | ) | cos( | ) | 0
cos( | ) | sin( | ) | 0
1 | 2 | 4 | 1 | 2 | 4
1 | 2 | 4 | 1 | 2 | 4
θ θ θ | θ θ θ
θ θ θ | θ θ θ

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
0 0 0

0 0 0

0 0 0
~
4

0
r

4

0
P
r = | 4

3
4

0
. P | P R | r =
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
+ | − | − | + | −
+ | − | | + | −
0 | 0 | 1
sin( | ) | cos( | ) | 0
cos( | ) | sin( | ) | 0
1 | 2 | 4 | 1 | 2 | 4
1 | 2 | 4 | 1 | 2 | 4
θ θ θ | θ θ θ
θ θ θ | θ θ θ

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
29 Þ
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
0 | 0 | 0
| 0 | 0
0 | 0
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
Hệ phương trình cận bằng tại khớp 4:

ïî

ï
í

ì

= | + | −
= | −

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
,4 | 4

0
4,3

0

~ .

~ M | M | r | F | r | m g
F | F | m g
K | P

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
F m g

F

F

F m g

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
4 | 4

4,3

0
0

0

0

M
4,3 =
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
0 0 0

0 0 0

0 0 0

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
F + m g

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
0 | 0 | 0
| 0 | 0
0 | 0

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
- Tính lực và momen tại khớp 3 Ta có :

0

F
4,3 =
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
F − m g

F

F

z

y

x

4

; | 0

M
4,3 =
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
3 = [ ] T
d3
0 0
;
3

2
P

r =[ ] T
l
4

0 0 −

0 C 3 =
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
− | + | −
+ | − | + | + | +
+ | | + | + | +
0 | 0 | 0 | 1
0 | 0 | 1
sin( | ) | cos( | ) | 0 | sin( ) | sin( | )
cos( | ) | sin( | ) | 0 | cos( ) | cos( | )
1 | 2 | 3
1 | 2 | 1 | 2 | 1 | 1 | 2 | 1 | 2
1 | 2 | 1 | 2 | 1 | 1 | 2 | 1 | 2
d | d | d
a | a
a | a
θ θ | θ θ | θ | θ θ
θ θ | θ θ | θ | θ θ
Þ | 3

0
| R =
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
+ | − | +
+ | +
0 | 0 | 1
sin( | ) | cos( | ) | 0
cos( | ) | sin( | ) | 0
1 | 2 | 1 | 2
1 | 2 | 1 | 2
θ θ | θ θ
θ θ | θ θ

3

0
r = 3

2
3

0
R . r =
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
+ | − | +
+ | +
0 | 0 | 1
sin( | ) | cos( | ) | 0
cos( | ) | sin( | ) | 0
1 | 2 | 1 | 2
1 | 2 | 1 | 2
θ θ | θ θ
θ θ | θ θ

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
0 | 0 | 0
| 0 | 0
0 | 0
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
r = | 3

2
3

0
. P | P C | r =
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
+ | − | +
+ | +
0 | 0 | 1
sin( | ) | cos( | ) | 0
cos( | ) | sin( | ) | 0
1 | 2 | 1 | 2
1 | 2 | 1 | 2
θ θ | θ θ
θ θ | θ θ

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
30 Þ
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
0 | 0 | 0
| 0 | 0
0 | 0
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
Hệ phương trình cân bằng lực tại khớp 3 :

ïî

ï
í

ì

= | + | −
= | −

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
4,3 | 3

0
3,2

0

~ .

~ M | M | r | F | r | m g
F | F | m g

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
F | m | m g

F

F

F | m g | m g

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
( | )

0

0

4 | 3 | 4 | 3

3,2

0

0

M
3,2 = 0

M
4,3 =
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
0 | 0 | 0
| 0 | 0
0 | 0

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
F − m + m g

F

F

z

y

x

( | )
4 | 3

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
0 | 0 | 0
| 0 | 0
0 | 0

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
3,2 =
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
y | x
x | y

M

M | d F
M | d F

3

3

- Tính lực và momen tại khớp 2 Ta có :

0

F
3,2 =
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
F − m + m g

F

F

z

y

x

( | ) 4 | 3

0

M
3,2 =
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
y | x
x | y

M

M | d F
M | d F

3

3

1

r

2 =[ | ]
T
a | d | d 2 | 2 | 2 | 2 | 2
sinα | cosα | ;
2

r

c2 = [−l200]
T

0 C 2
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
− | +
+ | − | + | + | +
+ | | + | + | +
0 | 0 | 0 | 1
0 | 0 | 1
sin( | ) | cos( | ) | 0 | sin( ) | sin( | )
cos( | ) | sin( | ) | 0 | cos( ) | cos( | )
1 | 2
1 | 2 | 1 | 2 | 1 | 1 | 2 | 1 | 2
1 | 2 | 1 | 2 | 1 | 1 | 2 | 1 | 2
d | d
a | a
a | a
θ θ | θ θ | θ | θ θ
θ θ | θ θ | θ | θ θ
Þ | 2

0
| R =
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
+ | − | +
+ | +
0 | 0 | 1
sin( | ) | cos( | ) | 0
cos( | ) | sin( | ) | 0
1 | 2 | 1 | 2
1 | 2 | 1 | 2
θ θ | θ θ
θ θ | θ θ

2

0
r = 2

1
2

0
R . r =
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
+ | − | +
+ | +
0 | 0 | 1
sin( | ) | cos( | ) | 0
cos( | ) | sin( | ) | 0
1 | 2 | 1 | 2
1 | 2 | 1 | 2
θ θ | θ θ
θ θ | θ θ

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
cos(180)

sin(180)

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
2 12

2 12

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
2 12 | 2 12
2 | 2 12
2 | 2 12

2

0

a s | a c
d | a c
d | a s
r

2

0 ~

P

r | = | 2

2
2
0 | ~
. P | P R | r =
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
+ | − | +
+ | +
0 | 0 | 1
sin( | ) | cos( | ) | 0
cos( | ) | sin( | ) | 0
1 | 2 | 1 | 2
1 | 2 | 1 | 2
θ θ | θ θ
θ θ | θ θ

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
2 12

2 12
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
0 | 0
0 | 0
~
2 12 | 2 12

2 12

2 12

2

0

l s l c

l c

l s
r P

Hệ phương trình cân bằng lực tại khớp 2 :

ïî

ï
í

ì

= | + | −
= | −
M | M | r | F | r | m g
F | F | m g
P | 2

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
3,2 | 2

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
− | + | +

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
F | m | m | m g

F

F

F | m | m g | m g

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
( | )

0

0

( | )
4 | 3 | 2 | 4 | 3 | 2

2,1

0

0

M
2,1=
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
y | x
x | y

M

M | d F
M | d F

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
2 12 | 2 12
2 | 2 12
2 | 2 12
a s | a c
d | a c
d | a s

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
F − m + m + m g

F

F

z

y

x

( | ) 4 | 3 | 2

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
0 | 0
0 | 0
2 12 | 2 12

2 12

2 12

l s l c

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
− | +
+ | − | + | + | − | + | + | −
+ − | + | − | − | − | + | + | +
z | x | y
y | x | z
x | y | z
M | a s F | a c F
M | d | d | d F | a c m g F | m g m g | m l gc
M | d | d | d F | a s m g F | m g m g | s l m g
2 12 | 2 12
4 | 3 | 2 | 2 12 | 4 | 3 | 2 | 2 2 | 12
4 | 3 | 2 | 2 12 | 4 | 3 | 2 | 12 2 | 2
( | ) | ( | )
( | ) | ( | )
- Tính lực và momen tại khớp 1
Ta có :

0

F
2,1 =
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
F − m + m + m g

F

F

z

y

x

( | )
4 | 3 | 2

0

M
2,1 =
( | )
( | )
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
− | + | + | −
+ | − | + − | + | − | + | + | +
− | + | + | + | − | + | + | −
z | x | y
y | x | x | z
x | y | y | z
M | a s | d s c F | a c | d s s | F
M | d F | d c F | a c | d s s | F | m | m | m g | m l gs
M | d F | d c F | a s | d s c | F | m | m | m g | m l gs
( | . ) | ( | . )
. | ( | | . ) | ( | )
. | ( | . | ) | ( | )
2 12 | 2 2 | 12 | 2 12 | 2 2 | 12
3 | 2 2 | 2 12 | 2 2 | 12 | 4 | 3 | 2 | 2 2 | 12
3 | 2 2 | 2 12 | 2 2 | 12 | 4 | 3 | 2 | 2 2 | 12 0 r

1

=[ | ]
T
a | d | d 1 | 1 | 1 | 1 | 1
sinα | cosα | ;

0 r

p1 =[ | ]
T
l 0 0 − 1

0 C 1 =
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
é | −
0 | 0 | 0 | 1
0 | 0 | 1
sin | cos | 0 | sin
cos | sin | 0 | cos

1

1 | 1 | 1 | 1
1 | 1 | 1 | 1

d

a

a
θ | θ | θ
θ | θ | θ
Þ | 2

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
é | −
0 | 0 | 1
sin | cos | 0
cos | sin | 0
1 | 1
1 | 1
θ | θ
θ | θ

1

0
r = 1

0
1

0
R . r =
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
é | −
0 | 0 | 1
sin | cos | 0
cos | sin | 0
1 | 1
1 | 1
θ | θ
θ | θ

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
cos0

sin 0

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
1 1 | 1 1
1 | 1 1
1 | 1 1

1

0

a s | a c
d | a c
d | a s
r

1

0 ~

P

r = | 1

1
1

0
. P | P R | r =
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
é | −
0 | 0 | 1
sin | cos | 0
cos | sin | 0
1 | 1
1 | 1
θ | θ
θ | θ

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
0 | 0
0 | 0
~
1 1 | 1 1

1 1

1 1

1

0

l s l c

l c

l s
r P

Hệ phương trình cân bằng tại khớp 1 là

ïî

ï
í

ì

= | + | −
= | −
M | M | r | F | r | m g
F | F | m g
P | 1

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
2,1 | 1

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
− | + | + | +

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
− | + | +

=
F | m | m | m | m g

F

F

F | m | m | m g | m g

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
( | )

0

0

( | )
4 | 3 | 2 | 1 | 4 | 3 | 2 | 1

1,0

0

0

M
1,0=
( | )
( | )
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
− | + | + | −
+ | − | + − | + | − | + | + | +
− | + | + | + | − | + | + | −
z | x | y
y | x | x | z
x | y | y | z
M | a s | d s c F | a c | d s s | F
M | d F | d c F | a c | d s s | F | m | m | m g | m l gs
M | d F | d c F | a s | d s c | F | m | m | m g | m l gs
( | . ) | ( | . )
. | ( | | . ) | ( | )
. | ( | . | ) | ( | )
2 12 | 2 2 | 12 | 2 12 | 2 2 | 12
3 | 2 2 | 2 12 | 2 2 | 12 | 4 | 3 | 2 | 2 2 | 12
3 | 2 2 | 2 12 | 2 2 | 12 | 4 | 3 | 2 | 2 2 | 12

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
1 1 | 1 1
1 | 1 1
1 | 1 1
a s | a c
d | a c
d | a s

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
F − m + m + m + m g

F

F

z

y

x

( | )
4 | 3 | 2 | 1

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
0 | 0
0 | 0
1 1 | 1 1

1 1

1 1

l s l c

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
( | )

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
− | + | − | +
+ | + | + | + | − | −
− | + | − | + | + | + | − | + | +
− | − | + | + | + | +
+ | + | − | − | − | + | + | + | −

=

z | x | y | x | y

z

y | x | z | x

z

x | y | z | y
M | a s F | | a c F | a s F | | a c F
a c | m | m | m | m g | F | m l gc
M | d | d | d C F | a c | m | m | m g | F | m l gc | d F
a s m g | F | m | m | m g | m l gs
M | d | d | d F | a s | m g | F | m g | m g | m l gs | d F
2 12 | 2 12 | 1 1 | 1 1
1 1 | 4 | 3 | 2 | 1 | 1 1 | 1
4 | 3 | 2 | 2 | 2 12 | 4 | 3 | 2 | 2 2 | 12 | 1
1 1 | 4 | 3 | 2 | 1 | 1 1 | 1
4 | 3 | 2 | 2 12 | 4 | 3 | 2 | 2 2 | 12 | 1
(( | ) | ) | ;
( | ) | ( | )
( | ( | ) ) | ;
( | ) | ( | )

### 2.3 KẾT QUẢ TÍNH TOÁN

Theo các thông số đầu vào của yêu cầu thiết kế cùng tải trọng yêu cầu của Robot kết hợp với việc tham khảo tài liệu của hãng ta xác định sơ bộ toàn khối lượng của toàn cánh tay robot như sau: M=45kg
Để phục vụ cho việc tính toán động lực học và chọn động cơ, hộp giảm tốc cho robot theo kinh nghiệm thiết kế ta định sơ bộ khối lượng của mỗi khâu gần đúng như sau:

Khâu đế

## m kg đ = 25

m1 = 9.5kg;m2 = 9kg;m3 + m4 = 1.5kg
Tải trọng của sản phẩm yêu cầu mKmax = 6kg
Coi các khâu như thanh thẳng tọa độ trọng tâm các khâu là trung điểm các thanh ta có.

r

1

c1 = [

−0.200
0
0

]; r
2

c2 = [

−0.175
0
0

]; r
3

c3 = [

0
0
−0.225

]; r
4

c4 = [

0
0
−0.225

]

Với các thông số đầu bài và các thông số kĩ thuật của robot Scara SR8 ta xác định được các giá trị hằng số được liệt kê dưới đây.
m1 = 9.5; m2 = 9; m3 = 1.5; m4 = 0; mKmax = 6; d1 = 0.45; d2 = 0.1; a1 = 0.4; a2 = 0.35; l1 = 0.200;l2 = 0.175;l3 = 0.225;l4 = 0.225;Fx = 0; Fy = 0; Fz = 0; Mx = 0; My = 0; Mz = 0; Thay các giá trị hằng số vào phương trình lực và momen của từng khớp đã được tính toán ở trên, sử dụng phần mềm tính toán maple ta tính được giá trị lực và momen tại các khớp làn lượt như sau.
- Khớp 4
F4 = [
Fy
Fx

## −(mk + m4)g

] = [
0
0
−58.86

]

|F4

| = √F4x
2 + F4y

2 + F4z

2 = 58.86 | (N)

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
2 M4 | = M4x | + M y | + M z
= | (N.m)
- Khớp 3
F3 = [
Fy
Fx

### −(mk + m3 + m4)g

] = [
0
0
−73.575

]

|F3

| = √F3x
2 + F3y

2 + F3z

2 = 73.58 | (N)

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
y | x
x | y

M

M | d F
M | d F
M

0

2
1

2
1
2 M3 | = M1x | + M y | + M z
= | (N.m)
- Khớp 2

F2 = [
Fy
Fx

### −(mk + m2 + m3 + m4)g

] = [
0
0
−161.87

]

|F2

| = √F2x
2 + F2y

2 + F2z

2 = 161.87 | (N)

M2 =
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
− | +
+ | − | + | + | − | + | + | −
+ − | + | − | − | − | + | + | +
z | x | y
y | x | z
x | y | z
M | a s F | a c F
M | d | d | d F | a c m g F | m g m g | m l gc
M | d | d | d F | a s m g F | m g m g | s l m g
2 12 | 2 12
4 | 3 | 2 | 2 12 | 4 | 3 | 2 | 2 2 | 12
4 | 3 | 2 | 2 12 | 4 | 3 | 2 | 12 2 | 2
( | ) | ( | )
( | ) | ( | )

= [

### -41.202×sin(θ1 + θ2) 41.202×cos(θ1 + θ2)

0

]

|M2

| = √M1x
2 + M1y

2 + M1z

2 = 41.202 | (N.m)
- Khớp 1
F1 = [
Fy
Fx

### −(mk + m1 + m2 + m3 + m4)g

] = [
0
0
−255.06

]

|F1

| = √F1x
2 + F1y

2 + F1z

2 = 255.06 | (N)

M1 =

[

### Mx + (d4 + d3 − d2)Fy − a2S12(−Fz + (mk + m4 + m3 + m2 + m1)g) + m2l2gS12 − d1Fy

−a1S1(−Fz + (mk + m4 + m3 + m2 + m1)g) + m1l1gS1;

### My − (d4 + d3 − d2C2)Fx + a2C12(−Fz + (mk + m4 + m3 + m2 + m1)g) + m2l2gC12 + d1Fx

+a1C1(−Fz + (mk + m4 + m3 + m2 + m1)g) − m1l1gC1;
Mz − a2S12Fx + a2C12Fy − a1S1Fx + a1C1Fy; | ]

= [

-41.202×sin(θ1 + θ2)-83.385×sin(θ1)
41.202×cos(θ1 + θ2) + 83.385×cos(θ1) 0

]

|M1

| = √M1x
2 + M1y

2 + M1z

2 = √41.202² + 83.385² + 2 × 41.202 × 83.385 cos( θ2)

Nhận thấy giá trị của momen tại khớp 1 là một hàm số theo biến khớp θ2. Dễ dàng thấy được giá trị lớn nhất của hàm số trên đạt được khi θ2 = 0. Hay nói cách khác, cấu hình của robot lúc đó góc giữa khâu 1 và khâu 2 đang bằng 180o

, cánh tay đang vươn ra xa nhất. Giá trị momen lúc đó sẽ là:
|M1
|max = 124.587 | (N.m)

### 2.5 LỰA CHỌN KẾT CẤU SƠ BỘ

### 2.5.1 Giới thiệu các loại hộp giảm tốc dùng trong robot

Các loại hộp giảm tốc sử dụng trong robot công nghiệp ngày nay ngoài các yêu cầu chung về đảm bảo tỷ số truyền, độ ổn định khi làm việc còn phải đảm bảo các tiêu chí về kích thước, khối lượng nhỏ gọn để dễ dàng gắn lên các khâu, các khớp trong robot.
Các loại hộp giảm tốc cycloid và hộp giảm tốc bánh răng sóng hiện nay là những loại hộp giảm tốc được sử dụng tương đối nhiều trong lĩnh vực robot do chúng đáp ứng được các yêu cầu đặt ra trong tính toán, thiết kế và chế tạo robot. Do đó trong các sản phẩm Robot trên thế giới thường xuyên sử dụng hai loại hộp giảm tốc này.
Trong phạm vi đồ án này tác giả lựa chon hộp giảm tốc bánh răng sóng cho khớp một và khớp hai của robot, và bộ chuyền đai kết hợp với bộ chuyền con lăn cho hai khớp của hai khau cuối của robot.
a) Bộ truyền động cho khớp 1 và khớp 2

Việc lựa chọn hộp giảm tốc cho các khớp chủ yếu dựa vào momen xoắn và tốc độ đầu ra ngoài ra các yếu tố bất thường của momen cũng được xem xét đến. Trong chương này tác giả chỉ lựa chọn kết cấu sơ bộ của hộp giảm tốc sao cho phù hợp với kích thước và kết cấu của các khâu. Việc lựa chon chính xác và đảm bảo các yêu cầu kĩ thuật sẽ được tác giả trình bày ở chương 3.
Qua kham khảo các tài liệu và catalog bánh răng sóng lựa chọn hộp giảm tốc cho các khớp như

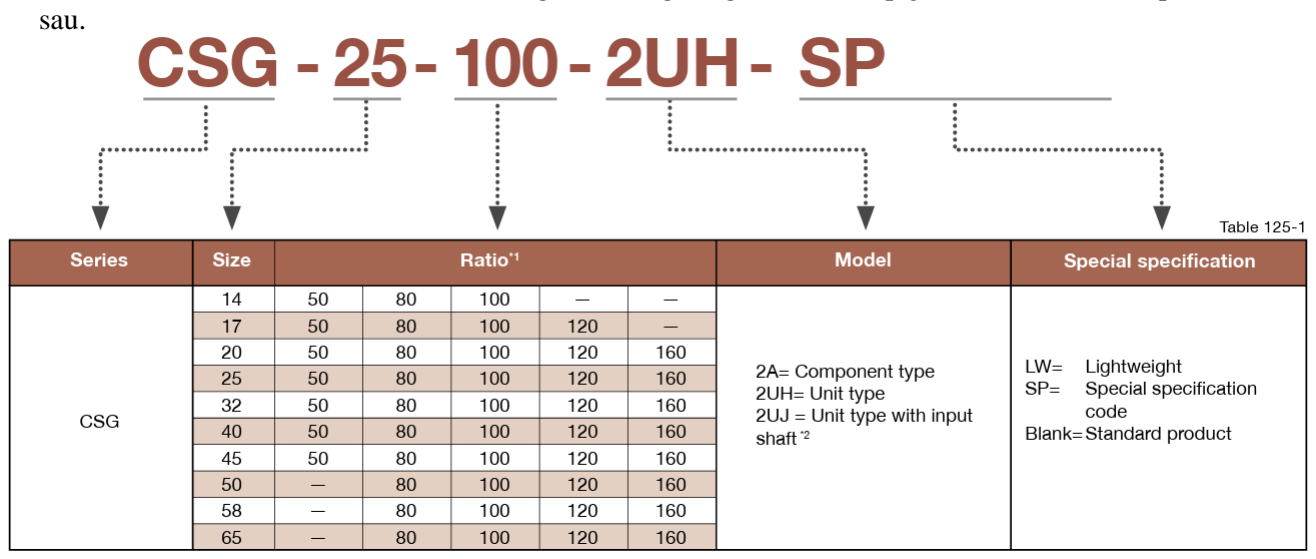
[picture p11: figure]
sau.

- Khớp 1
Do momen xoắn theo trục Z ở trạng thái tĩnh của khớp 1
M1z
= 0

và các momen thành phần
0 M1x ≠ | 0 M1y ≠
ta chọn sơ bộ loại hộp giảm tốc là loại CSG, size 25 loại 2UH cho bộ chuyền

động bánh răng sóng tại khớp 1

- Khớp 2
Do momen xoắn theo trục Z ở trạng thái tĩnh của khớp 2
M2z
= 0

và các momen thành phần
0 2 ≠ M x
0 M 2 y ≠
ta chọn sơ bộ loại hộp giảm tốc là loại CSF, size 25 loại 2UH cho bộ chuyền

động bánh răng sóng tại khớp 2

Hình 2.2 Sơ đồ lựa chọn hộp giảm tốc bánh răng sóng [8]

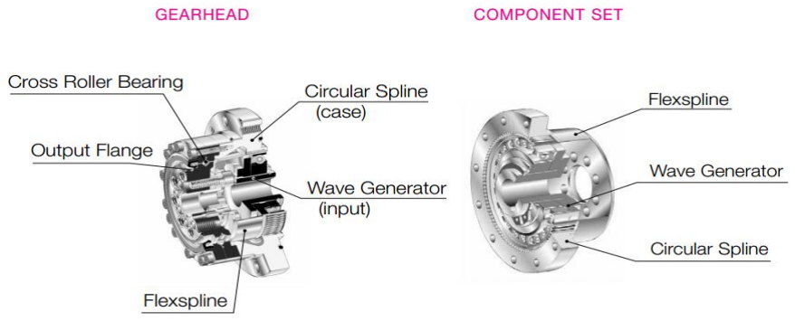
[picture p12: figure]

b) Chọn bộ chuyền động cho khớp 3 và khớp 4
Do khớp 3 là khớp tịnh tiến và khớp 4 là khớp quay, để đảm bảo các chuyển động đảm bảo kết cấu đơn giản và kích thước gọn nhẹ tác giả chọn bộ truyền động cho khớp 3 và khớp 4 như sau. Khớp 3 chọn ổ vitbi dạng xoắn ốc kết hợp với ổ trục 4 có dạng các dãy bi song song giúp định hướng cho chuyển động tịnh tiến đồng thời truyền động quay cho trục vitbi.

`

Hình 2.3 Cấu tạo hộp giảm tốc bánh răng sóng loại 2UH [8]

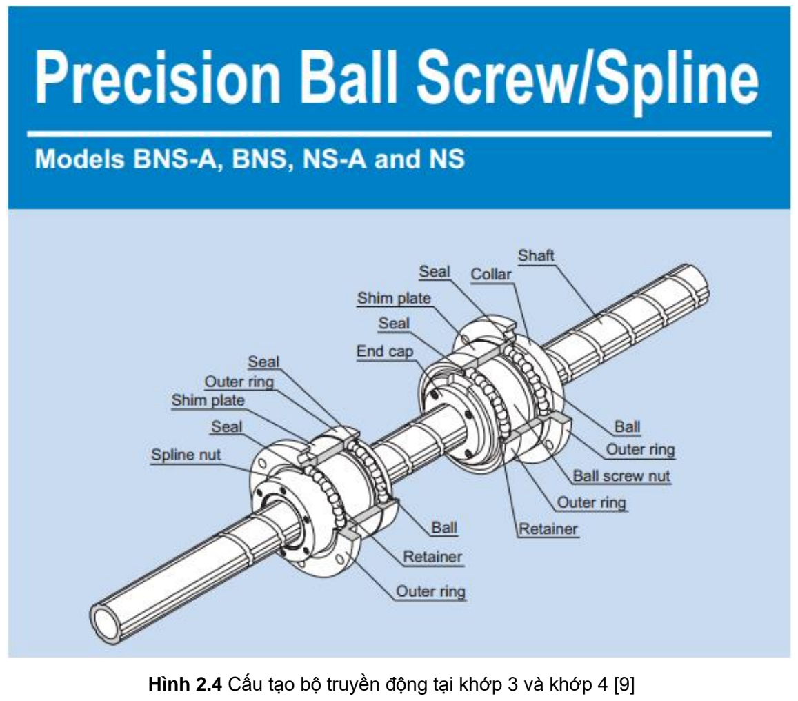
[picture p13: figure]

Hình 2.4 Cấu tạo bộ truyền động tại khớp 3 và khớp 4 [9]

### 2.5.2 Bản vẽ sơ bộ các khâu của robot

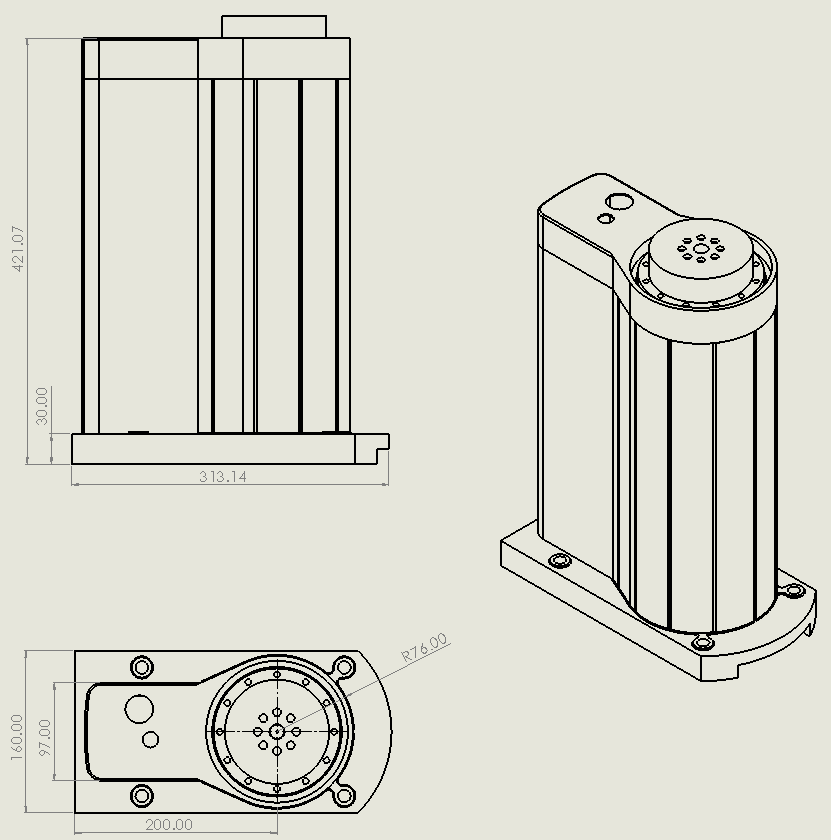
[picture p14: figure]

Hình 2.5 Kết cấu sơ bộ khâu đế

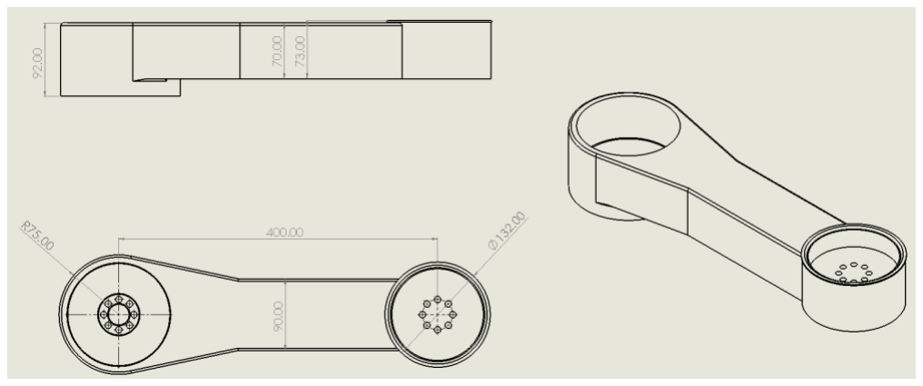
[picture p15: figure]

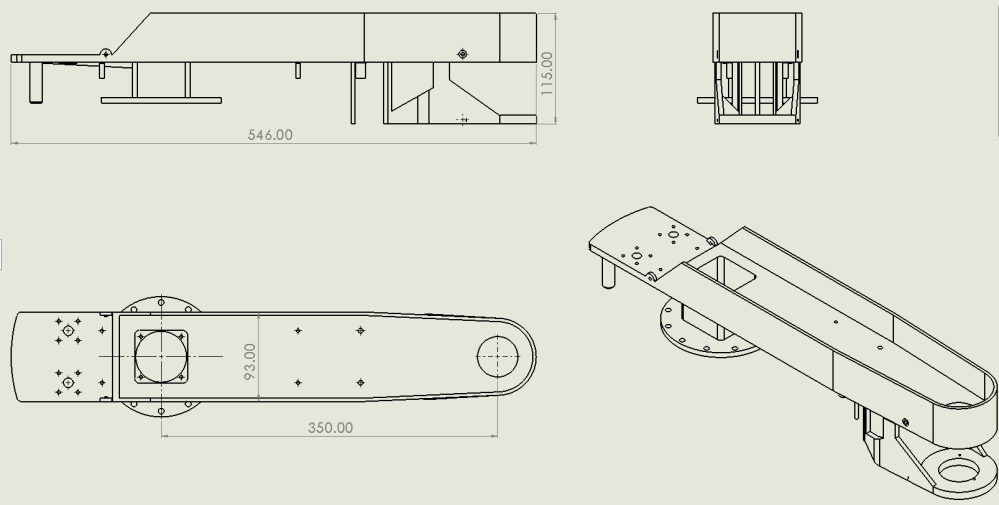
[picture p16: figure]

Hình 2.7 Kết cấu sơ bộ khâu 2

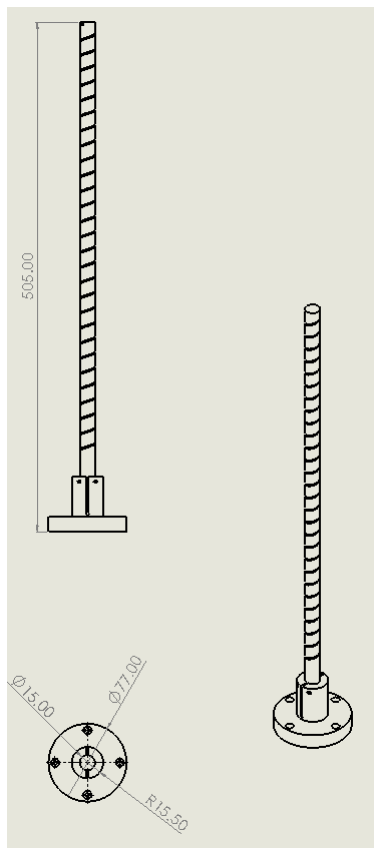
[picture p17: figure]

Hình 2.8 Kết cấu sơ bộ khâu 3-4

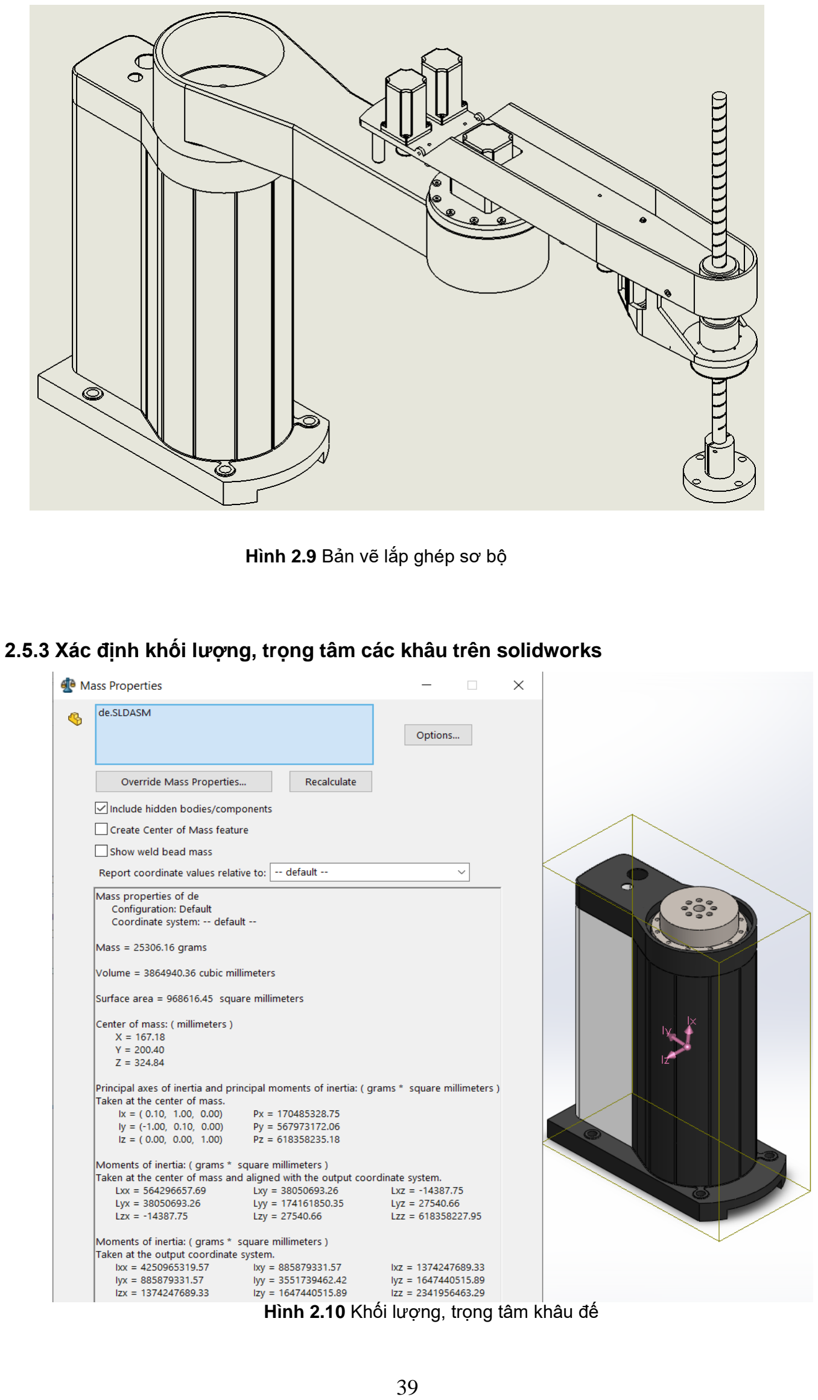
[picture p18: page 43]

### 2.5.3 Xác định khối lượng, trọng tâm các khâu trên solidworks

Hình 2.10 Khối lượng, trọng tâm khâu đế

Hình 2.9 Bản vẽ lắp ghép sơ bộ

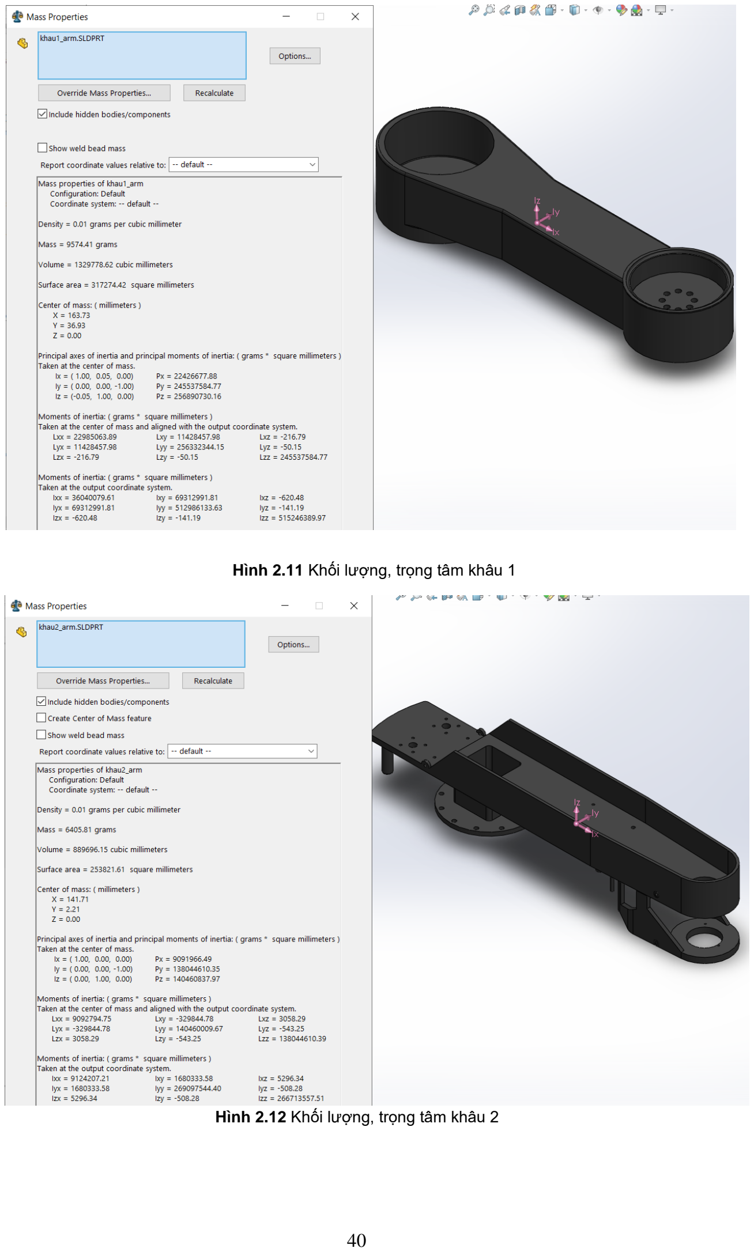
[picture p19: page 44]

Hình 2.11 Khối lượng, trọng tâm khâu 1

Hình 2.12 Khối lượng, trọng tâm khâu 2

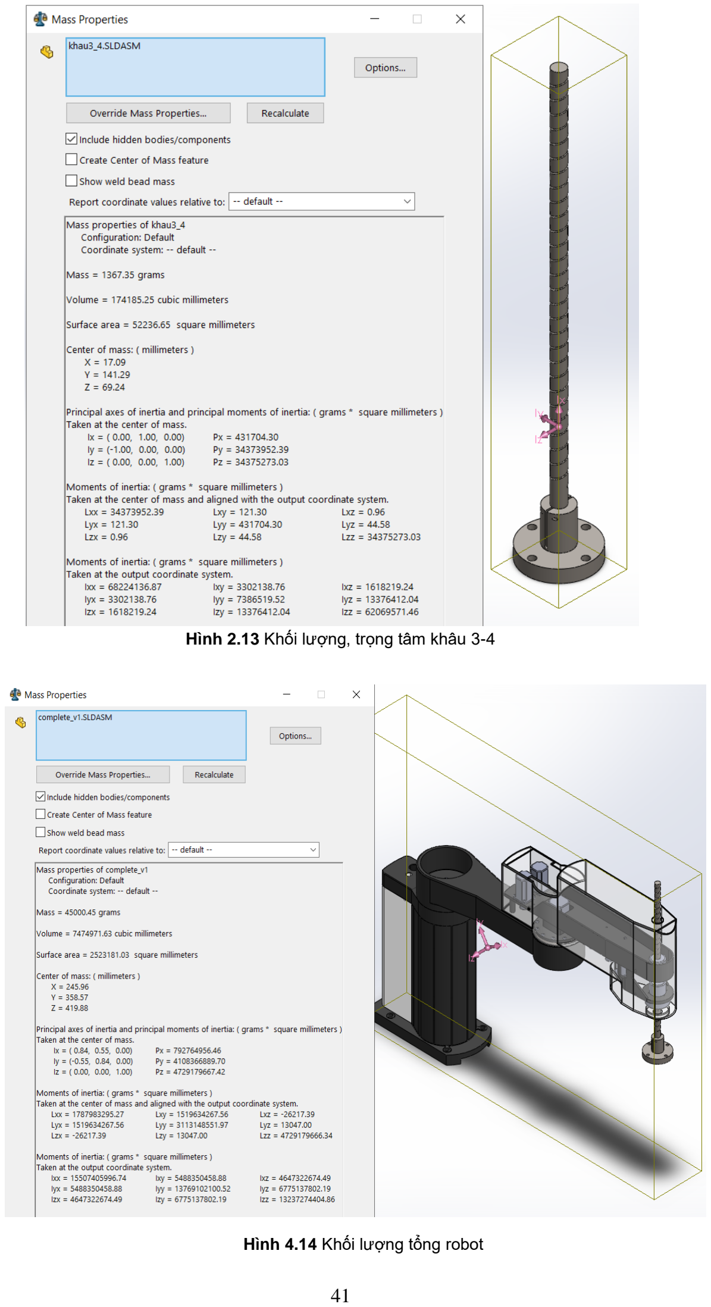
[picture p20: page 45]

Hình 2.13 Khối lượng, trọng tâm khâu 3-4

Hình 4.14 Khối lượng tổng robot

## Chương 3

## BÀI TOÁN ĐỘNG LỰC HỌC

### 3.1 THIẾT LẬP PHƯƠNG TRÌNH ĐỘNG LỰC HỌC BẰNG PHƯƠNG PHÁP NEWTON-

EULER

### 3.1.1 Cơ sở lý thuyết

Để giải bài toán động lực học cho robot đầu tiên ta phải thiết lập phương trình vi phân chuyển động và tiến hành giải phương trình vi phân đó để tìm ra các thông số cần thiết.Có nhiều phương pháp thiết lập phương trình vi phân chuyển động của robot như phương pháp Newton-Euler, phương pháp của Lagrange. . .
Dưới đây em xin trình bày theo phương pháp Newton-Euler.

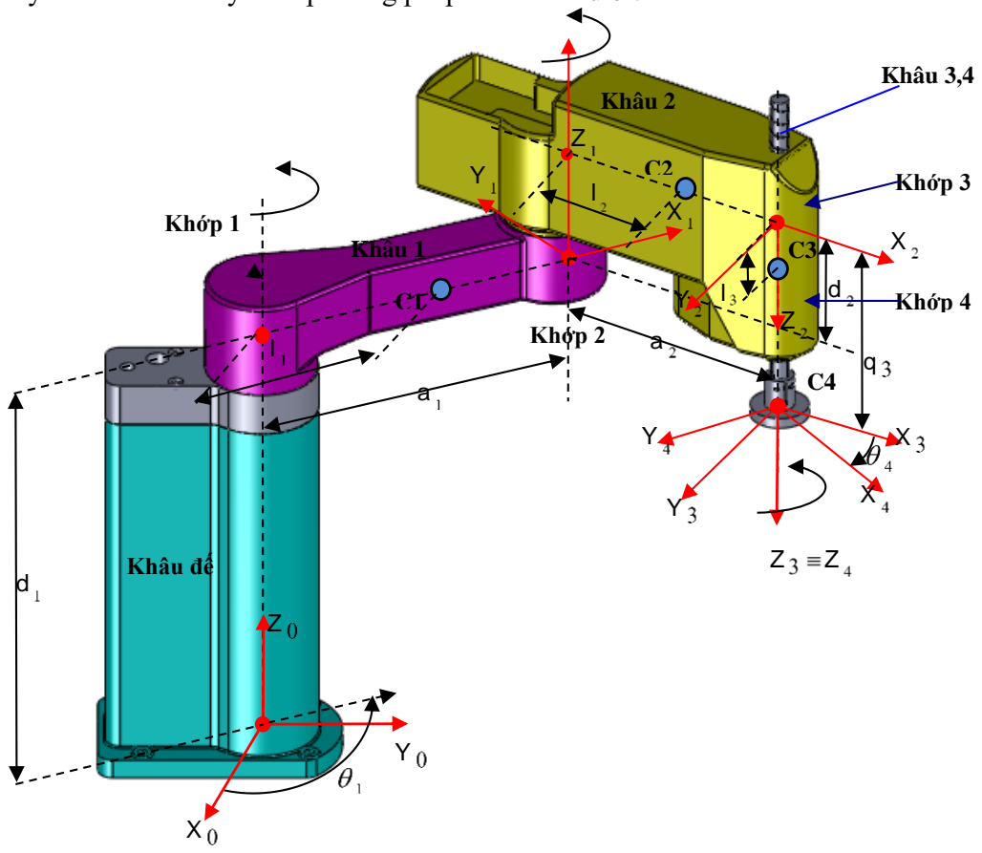
[picture p21: figure]
Khớp 1; Khớp 2; Khâu đế; Khâu 1; Khâu 2; Khâu 3,4; Khớp 3; Khớp 4

Xét mô hình robot scara bốn bậc tự do như hình 1.8

### 3.1.2 Xây dựng phương trình động lực học Newton-Euler cho robot

Với phương pháp Lagrange mô hình động lực học của robot xuất phát từ tổng năng lượng của hệ thống. Phương pháp Newton-Euler xây dựng mô hình động lực học dựa vào sự cân bằng lực của hệ lực tác động nên hệ thống. Từ đó hình thành nên các hệ phương trình động lực học, và sẽ giải bằng phương pháp đệ quy.

Hình 3.1 Mô hình động lực học robot

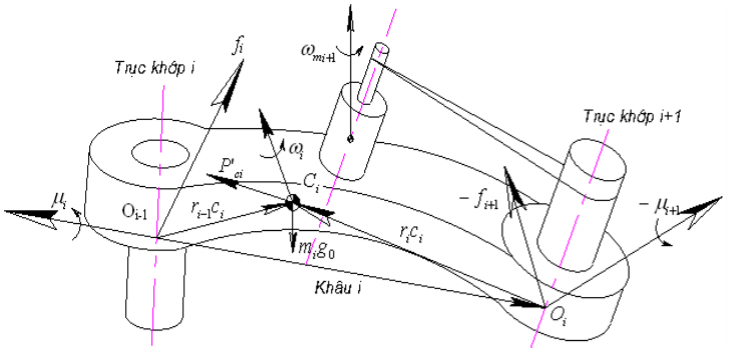
[picture p22: figure]

Giả sử khâu thứ i của robot chịu tác dụng bởi momen do động cơ tại khớp thứ i gây nên chuyển động cho khâu đó. Lực và momen tác đụng nên khâu được phân tích như hình 3.2

Gọi
1

,
i i+

f f

lần lượt là lực của khâu i tác dụng nên khâu i-1 và lực của khâu i+1 tác dụng nên

khâu i.

và
1

,
i i+

τ τ
: lần lượt là momen của khâu I tác dụng nên khâu i-1 và momen của khâu i+1 tác

dụng nên khâu i.
Khi đó ta có phương trình chuyển động của trọng tâm khâu i theo Newton như sau
i | i | Ci i | i
f − f | + m g = m a
+1
Phương trình chuyển động quay được mô tả bởi công thức Euler như sau
τ τ | iω i | ω i | iω
i

i ci i

i | i | i ci r | f | r | f | I | I
~ | ~ | ~

1

− | 1 +
, | − ,
= | +
+

+

Chuyển động của khâu thứ i được mô tả bằng hệ phương trình động lực học theo Newton-Euler như sau

ïî

ï
í

ì

− | + | − | = | +
− | + | =

+

+

+

i | i | i | i | i
i

i ci i

i | i | i ci
i | i | Ci i | i
r | f | r | f | I | I
f | f | m g m a
τ τ | ω ω ω
~ | ~ | ~

1

1 | , | ,

1
(3.1)

Trong đó

+

mi
: là khối lượng của khâu i.

+
i

I

: là tenxo quán tính của khâu I đối với trọng tâm của nó.

+

g
: là vecto gia tôc trọng trường.

+

aCi
: là vecto gia tốc trọng tâm của khâu i.

+
ω

: là vecto gia tốc góc của khâu i.

+

ω : là vecto vận tốc góc của khâu i.

Hinh 3.2 Sơ đồ tính động lực học Newton-Euler [10]

+

i ci r 1,

~
− là vecto định vị vị trí của khớp I đối với trọng tâm của nó viết trong hệ quy chiếu gắn với khâu i

+

i ci r
,

~
là vecto định vị vị trí của khớp i+1 đối với trọng tâm của nó viết trong hệ quy chiếu gắn với khâu i

Để tính lực và momen tại các khớp của robot ta viết phương trình động lực học Newton-Euler cho các khâu của robot và giải ngược từ khâu thao tác cuối đến khâu đầu tiên của robot. Để thuận tiện cho việc tính toán ta viết phương trình Newton-Euler dưới dạng phương trình truy hồi như sau.

ïî

ï
í

ì

= | − | + | + | +
= | + | −
+ | − | +

+

i ci | i | i | i | i | i | i
i
i | i | i | ci
i | Ci i | i
r | f | r | r | I | I
f | f | m | a | g
τ | τ | ω ω ω
~ | ~ | ~
( | )

1

0
,
0 | 0
1,

0
1
0 | 0
0 | 0

1

0 | 0

(3.2)

Trong 3.1 hệ phương trình Newton-Euler được viết trong hệ quy chiếu động Còn hệ phương

trình 3.2 được viết trong hệ quy chiếu cố định. Ta có
i | ci | i ci r | và r
,

0
1,
0 ~ | ~
− | được tính theo công thức sau.
i ci | i | i ci
i | ci | i | i | ci
r | R r
r | R r

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
− | = | −
(3.3)

### 3.2 TÍNH TOÁN LỰC VÀ MOMEN TẠI CÁC KHỚP

Khâu

Vị trí trọng tâm so với | | Momen quán tính từng khâu đối với
gốc tọa độ gắn trên | Khối | trọng tâm mỗi khâu trọng hệ tọa độ
mỗi khớp | | gắn liền với khớp
m ( ) | | 2 kg.m ( )

lượng
(
kg

)

XC

YC | C Z | XX I | YY I | ZZ I | XY I | YZ I | ZX I

1
1 −l
0 | 0
m1 | X

I
1 | Y

I
1 | Z
I1 | XY I
1 | YZ I
1 | ZX I1

2
2 −l
0 | 0
m2 | X

I
2 | Y

I
2 | Z

I

2 | XY I
2 | YZ I 2 | ZX I
| | | | | | | 2
3-4 | 0 | 0
4 −l | m34 | X
I
34 | Y

I
3 | Z
I3 | XY I3 | YZ I
3 | ZX I3
- Lực và momen trên khâu 3 và khâu 4

Ta có do khâu 3 và khâu 4 là một khâu nên coi chuyển động của khâu chung này là chuyển động 2 bậc tự do trên cùng một khâu
[ | ] T
K k

f 0 0 m g
,4

0

= | [ | ] T
k ,4
| 0 0 0

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
+ | + | −
− | − | − | −
=

3

2 12 12 | 1 1 1 | 2 12 12 | 1 1 1
2 12 12 | 1 1 1 | 2 12 12 | 1 1 1

4

0

q

a c | a c | a s | a s
a s | a s | a c | a c
aC
θ | θ | θ | θ
θ | θ | θ | θ

ω 4

=[0 0

θ1

+

θ 2

4

θ

- − ]
T

Bảng 3.1 Bảng thông số động lực rôbốt Scara 4 bậc tự do

45 ω 4

=[0 0

θ1

θ2

θ4

+ − ]
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
xz | yz | z
yx | y | yz
x | xy | xz
I | I | I
I | I | I
I | I | I
I
4 | 4 | 4
4 | 4 | 4
4 | 4 | 4

4

[ | ]
T
C
r | q | l
2, 34 | 3 | 4 = 0 0 | −
[ | ]
T
C
r | l
34, 34 | 4 = 0 0 −

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

4

0
θ θ θ | θ θ θ
θ θ θ | θ θ θ
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
+ | − | − | + | −
+ | − | | + | −
=
3 | 4 | 3
1 | 2 | 4 | 1 | 2 | 4
1 | 2 | 4 | 1 | 2 | 4

2, 34

0
0

0

4

0

0

0 | 0 | 1
sin( | ) | cos( | ) | 0
cos( | ) | sin( | ) | 0
q | l | l | q
r C | θ θ θ | θ θ θ
| θ θ θ | θ θ θ

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
0 | 0 | 0
| 0 | 0
0 | 0
~
3 | 4
3 | 4

2, 34

0
q | l
q | l
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
+ | − | − | + | −
+ | − | | + | −
=

4

1 | 2 | 4 | 1 | 2 | 4
1 | 2 | 4 | 1 | 2 | 4

34, 34

0
0

0

4

0

0

0 | 0 | 1
sin( | ) | cos( | ) | 0
cos( | ) | sin( | ) | 0
l | l
r C | θ θ θ | θ θ θ
| θ θ θ | θ θ θ

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
0 | 0 | 0
| 0 | 0
0 | 0
~

4

4

34, 34

0
l

l
r C

Phương trình động lực học cho khâu 3,4

ïî

ï
í

ì

= | − | + | + | +
= | + | −
34 | 4 | 4 | 34 | 4

0
4, 34

0

34

0
2, 34
0 | 0
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
| | ~ | | ~ | | | ~
( | )
τ | τ | r | f | r | f | I ω | ω I ω
f | f | m | a | g

K

K | C | C

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
m a | g | m g
| m a m a
f
z | K

y

x

( | )
34 | 3 34 3 34 3

34

0

46 Þ
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
+ | + | −
− | + | − | +
=
z | z
xz | z | xz | z | x | x
yz | z | yz | z | y | y

I

I | I | m a q | m a l
I | I | m a | q | m a l
4 | 4
4 | 4 | 34 34 | 3 | 34 34 | 4

2
4 | 4
4 | 4 | 34 34 | 3 | 34 34 | 4

2
4 4

34

0

ω

ω | ω
ω | ω
τ

- Lực và momen trên khâu 2

Ta có

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
m a | g | m g
| m a m a
f
z | K

y

x

( | )
34 | 3 34 3 34 3

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
+ | + | −
− | + | − | +
=
z | z
xz | z | xz | z | x | x
yz | z | yz | z | y | y

I

I | I | m a q | m a l
I | I | m a | q | m a l
4 | 4
4 | 4 | 34 34 | 3 | 34 34 | 4

2
4 | 4
4 | 4 | 34 34 | 3 | 34 34 | 4

2
4 4

34

0

ω

ω | ω
ω | ω
τ

ω 2

=[0 0

θ1

+

θ 2

]

T

ω 2

=[0 0

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
xz | yz | z
yx | y | yz
x | xy | xz
I | I | I
I | I | I
I | I | I
I
2 | 2 | 2
2 | 2 | 2
2 | 2 | 2

2

[ | ] 1, 2 | 2 | 2 | 2
r | a | l | 0 | d C
= | − | −
[ | 0 0] 2, 2 | 2
r | l C = −

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

2

0
θ θ | θ θ
θ θ | θ θ
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
− | +
− | +
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
+ | − | +
+ | | +
=

2

2 | 2 | 1 | 2
2 | 2 | 1 | 2

2

2 | 2
1 | 2 | 1 | 2
1 | 2 | 1 | 2

1, 2

0
( | )sin( | )
( | ) cos( | )
0
0 | 0 | 1
sin( | ) | cos( | ) | 0
cos( | ) | sin( | ) | 0

d

a | l
a | l

d

a | l
r C | θ θ

θ θ
θ θ | θ θ
θ θ | θ θ

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
− | − | + | − | +
− | − | +
− | − | +
=
( | )sin( | ) ( | ) cos( | ) | 0
0 | ( | ) cos( | )
0 | ( | )sin( | )
~
2 | 2 | 1 | 2 | 2 | 2 | 1 | 2
2 | 2 | 2 | 1 | 2
2 | 2 | 2 | 1 | 2

1, 2

0

θ θ | θ θ

θ θ

θ θ

a | l | a | l
d | a | l
d | a | l
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
− | +
− | +
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
+ | − | +
+ | | +
=
0
sin( | )
cos( | )

0

0
0 | 0 | 1
sin( | ) | cos( | ) | 0
cos( | ) | sin( | ) | 0
2 | 1 | 2
2 | 2 | 1 | 2
1 | 2 | 1 | 2
1 | 2 | 1 | 2

2, 2

0
θ θ

θ θ
θ θ | θ θ
θ θ | θ θ
l
l | l
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
+ | − | +

+

− | +
=
sin( | ) | cos( | ) | 0
0 | 0 | cos( | )
0 | 0 | sin( | )
~
2 | 1 | 2 | 2 | 1 | 2
2 | 1 | 2
2 | 1 | 2

2, 2

0

θ θ | θ θ

θ θ

θ θ

l | l

l

l
r C

Phương trình động lực học cho khâu 2

ïî

ï
í

ì

= | − | + | + | +
= | + | −
2 | 2 | 2 | 2 | 2 34

0
2, 2

0

2

0
1, 2

0
34

0
2

0

2

0
2 34

0

2

0
| | ~ | | ~
( | )
τ | τ | r | f | r | f | I ω | ω I ω
f | f | m | a | g
C | C

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
+ | − | + | +

+

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

m

m

34 34 | 2 2 | 2 | 34
34 34 | 2 2
34 34 | 2 2

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
Trong đó

( | )
( | ( | ) | ( | ) | ( | ) | )sin( | )
34 | 4 | 34 34 | 2 | 4 | 3

2
2 | 2 | 34 | 4

2
2 | 2
2 | 2 | 2 | 2 | 2 | 34 | 34 | 2 | 2 | 2 | 2 2 | 1 | 2 | 2 2 2

0

I | I | I | I | m a | d | l | q
l m a | g | a m g a | a m | m g a m a | m d a
yz | z | xz | z | yz | z | xz | z | y
x | z | z | K | z | y
− | + | − | + | + | + −
= | − | + | − | + | + | − | + | +
ω | ω | ω | ω
τ | θ θ
x | xz | z | yz | z | xz | z | yz | z
y | z | z | K | z | x
m a | q | l | d | I | I | I | I
m l g a | m a a | g | m | m a g a m a | m d a
2 | 2

2
34 | 4 | 2 | 2

2
34 34 | 3 | 4 | 2 | 34 | 4
2 | 2 2 | 2 | 34 2 | 34 | 2 | 2 | 2 | 2 2 | 1 | 2 | 2 2 2

0

( | )
( | ( | ) | ( | ) ( | ) | ) cos( | )
ω | ω | ω | ω
τ | θ θ
+ | − − | + | + | + | + |
= | − | + | − | − | + | + | + | −
z | z | z | z
z | x | x | y | y
I | I
m a | l a | m a a | m a | l a | m a a
34 | 34 | 2 | 2
2 | 2 | 2 | 2 | 2 | 34 2 34 | 1 | 2 | 2 | 2 | 2 | 2 | 34 2 34 | 1 | 2

0
( | ( | ) | )sin( | ) ( | ( | ) | ) cos( | )
ω | ω
τ | θ θ | θ θ
+ | | + |
= | − | + | + | − | − | + | +
- Lực và momen trên khâu 1
Ta có

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
+ | − | + | +

+

+
=
a | m a | m | m | m | g
| a | m a
| a | m a
z | z | K
y | y
x | x
m | ( | )

m

m

34 34 | 2 2 | 2 | 34
34 34 | 2 2
34 34 | 2 2

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
48 ω1

=[0 0

θ1

]

T

ω1

=[0 0

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
xz | yz | z
yx | y | yz
x | xy | xz
I | I | I
I | I | I
I | I | I
I
1 | 1 | 1
1 | 1 | 1
1 | 1 | 1

1

[ | ] 0, 1 | 1 | 1 | 1
r C = a − l | 0 d
[ | 0 0] 1, 1 | 1
r | l C = −

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
0 | 0 | 1
sin | cos | 0
cos | sin | 0
1 | 1
1 | 1

2

0
θ | θ
θ | θ
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
1 | 1 | 1
1 | 1 | 1

1

1 | 1
1 | 1
1 | 1

0, 1

0
( | )sin
( | ) cos
0
0 | 0 | 1
sin | cos | 0
cos | sin | 0

d

a | l
a | l

d

a | l
r C | θ

θ
θ | θ
θ | θ

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
− | − | −
− | −
− | −
=
( | )sin | ( | ) cos | 0
0 | ( | ) cos
0 | ( | )sin
~
1 | 1 | 1 | 1 | 1 | 1
1 | 1 | 1 | 1
1 | 1 | 1 | 1

0, 1

0

θ | θ

θ

θ

a | l | a | l
d | a | l
d | a | l
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
0 | 0 | 1
sin | cos | 0
cos | sin | 0
1 | 1
1 | 1 | 1
1 | 1
1 | 1

1, 1

0
θ

θ
θ | θ
θ | θ
l
l | l
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
sin | cos | 0
0 | 0 | cos
0 | 0 | sin
~
1 | 1 | 1 | 1
1 | 1
1 | 1

1, 1

0

θ | θ

θ

θ

l | l

l

l
r C

Phương trình động lực học cho khâu 1

ïî

ï
í

ì

= | − | + | + | +
= | + | −
1 | 1 | 1 1 | 1 2

0
1, 1

0

1

0
0, 1

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
~ | ~
( | )
τ | τ | τ | f | r | f | I ω ω I ω
f | f | m | a | g
C | C

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
+ | + | − | + | + | +
+ | +
+ | +
=
a | m a | m a | m | m | m | m g
a | m a | m a
a | m a | m a
f
z | z | z | K
y | y | y
x | x | x
m | ( | )

m

m

34 34 | 2 2 | 1 1 | 1 | 2 | 34
34 34 | 2 2 | 1 1
34 34 | 2 2 | 1 1

1

0

49 Þ
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
Trong đó

y | y | y
xz | z | yz | z | xz | z | yz | z | xz | z | yz | z
z | z | z | z | K
x | z | z | z | K
m a | l | q | d | d | m a d | d | m d a
I | I | I | I | I | I
m l a | g | m a g | a | m a g | a | m a g | a | m a g
m l a | g | m a g | a | m a g | a | m a g
34 34 | 4 | 3 | 2 | 1 | 2 | 1 | 2 | 1 1 1

2
1 | 1 | 1 | 1

2
2 | 2 | 2 | 2

2
34 | 4 | 34 | 4
1 1 | 1 | 34 1 | 34 | 2 1 | 2 | 1 1 | 1 | 1 | 1
1 | 2 2 | 2 | 34 | 2 | 34 | 2 | 2 | 2 | 2 | 1 | 2

0

( | ) | ( | )
( | ( | ) | ( | ) | ( | ) | ( | ) | )sin( )
( | ( | ) | ( | ) | ( | ) | )sin( | )
+ | − | + | + | + | + | +
+ | − | + | − | + | −
+ | − | + | − | + | − | + | − | +
= | − | + | − | + | − | + | +
ω | ω | ω | ω | ω | ω

θ

τ | θ θ
x | x | x
yz | z | xz | z | yz | z | xz | z | yz | z | xz | z
z | z | z | z | K
y | z | z | z | K
m a | q | l | d | d | m a d | d | m d a
I | I | I | I | I | I
m l g a | m a a | g | m a a | g | m a a | g | m a g
m l g a | m a a | g | m a a | g | m a g
34 34 | 3 | 4 | 2 | 1 | 2 | 1 | 2 | 1 1 1

2
1 | 1 | 1 | 1

2
2 | 2 | 2 | 2

2
34 | 4 | 34 | 4
1 1 | 1 | 34 1 | 34 | 2 1 | 2 | 1 1 | 1 | 1 | 1
1 | 2 2 | 2 | 34 2 | 34 | 2 2 | 2 | 2 | 1 | 2

0

( | ) | ( | )
( | ( | ) | ( | ) | ( | ) | ( | ) | ) cos( )
( | ( | ) | ( | ) | ( | ) | ) cos( | )
+ | − − | − | − | + | +
+ | + | + | + | + | +
+ | − | + | − | + | − | + | − | −
= | − | + | − | + | − | + | +
ω | ω | ω | ω | ω | ω

θ

τ | θ θ
34 1 34 | 2 1 2 | 1 1 1 | 1 1 1 | 1
34 2 34 | 2 2 2 | 2 2 2 | 1 | 2 | 34 1 34 | 2 1 2 | 1 | 1 | 1 | 1 | 1
1 | 34 | 4 | 2 | 2 | 1 | 1 | 34 2 34 | 2 2 2 | 2 2 2 | 1 | 2

0

( | ) cos
( | ) cos( | ) ( | ( | ) | )sin
( | )sin( | )
| | θ
θ θ | θ
τ | ω | ω | ω | θ θ
y | y | y | y
y | y | y | x | x | x
z | z | z | z | z | z | z | x | x | x
m a a | m a a | m a a | m l a
m a a | m l a | m a a | m a a | m a a | m a | l a
I | I | I | m a a | m l a | m a a
− | + | + | +
+ − | + | − | + | + | + | + | −
= | + | + | + | − | + | +

Nhận xét: Để xác định lực và momen động cơ dẫn động các khớp ta chiếu lực
i

f
(đối với khớp

trượt) hoặc momen
i

τ
(đối với khớp quay) lên trục khớp ta được lực động tổng quát của các khớp. Trong đồ án tác giả tính toán chuyển động của robot scara với (khới 1, khớp 2, khớp 4) là khớp quay, khớp 3 là khớp tịnh tiến. Ta có
- Momen động cơ 1
34 1 34 | 2 1 2 | 1 1 1 | 1 1 1 | 1
34 2 34 | 2 2 2 | 2 2 2 | 1 | 2 | 34 1 34 | 2 1 2 | 1 | 1 | 1 | 1 | 1
1 | 34 | 4 | 2 | 2 | 1 | 1 | 34 2 34 | 2 2 2 | 2 2 2 | 1 | 2

0
1
( | ) cos
( | ) cos( | ) ( | ( | ) | )sin
( | )sin( | )
| | θ
θ θ | θ
τ | ω | ω | ω | θ θ
y | y | y | y
y | y | y | x | x | x
dc | z | z | z | z | z | z | z | x | x | x
m a a | m a a | m a a | m l a
m a a | m l a | m a a | m a a | m a a | m a | l a
M | I | I | I | m a a | m l a | m a a
− | + | + | +
+ − | + | − | + | + | + | + | −
= | = | + | + | + | − | + | +
- Momen động cơ 2
z | z | z | z
dc | z | x | x | y | y
I | I
M | m a | l a | m a a | m a | l a | m a a
34 | 34 | 2 | 2
2 | 2 | 2 | 2 | 2 | 34 2 34 | 1 | 2 | 2 | 2 | 2 | 2 | 34 2 34 | 1 | 2

0
2
( | ( | ) | )sin( | ) ( | ( | ) | ) cos( | )
ω | ω
τ | θ θ | θ θ
+ | | + |
= | = | − | + | + | − | − | + | +
- Lực động cơ 3
F | f | m a | g | m g dc =
z

=
z − | − K
( | ) 34 | 34 | 3

0
3
- Momen động cơ 4
dc | z | z | z M | I 4 | 4 | 4

0
4= τ = ω

### 3.3 TÍNH TOÁN CHỌN HỘP GIẢM TỐC TẠI CÁC KHỚP

### 3.3.1 Đặt nhiệm vụ cho robot

Để tính chọn hộp giảm tốc được chính xác ta cần có một giá trị momen (đối với khớp quay) và lực (đối với khớp tịnh tiến) phát động tại các khớp. Với các thông số kĩ thuật cùng với tham khảo tài liệu các hãng chuyên sản xuất robot Scara. Giả sử phương trình chuyển động khâu thao tác của robot có phương trình dạng.

6

0.4 0.2cos ( ), | 0.2sin ( ), | 0.15cos ( ), | π
X K
= | + | ω t YK
= | ω t ZK
= | ω t φ =

Đặt bài toán cho robot thực hiện chuyển động chạy không tải theo quỹ đạo là đường tròn có phương trình (3.5) trong thời gian thực hiện là T ( thời gian thao tác) giây. Kham khảo tài liệu các hãng chuyên sản xuất robot scara với robot hiện nay thời gian thao tác nhanh nhất của robot có thể đạt bằng 0.5 giây. Trong thiết kế em đặt thời gian thao tác nhanh nhất cho robot scara SR8 là 0.6 giây để tính toán lực và momen cần thiết để tính toán và chọn hộp giảm tốc .

Với T=0.6 giây → | 10.4
0.5
2 | 2
= | = | =
π | π
ω
T

(rad/s) : chọn

ω =10
(rad/s)

Thế vào phương trình chuyển động (3.5) như trên ta có phương trình chuyển động theo thời gian của bàn kẹp là.

6

0.4 0.2cos(10 ), | 0.2sin(10 ), | 0.15cos(10 ), | π
X K
= | + | t YK
= | t ZK
= | t φ =

Các giá trị tham số động lực học của robot Scara SR8 được lấy ra từ việc xuất ra khối lượng và trọng tâm trong Solidworks ở chương 2
m1 = 9.5; m2 = 9; m34 = 1.5; mKmax = 6; d1 = 0.45; d2 = 0.1; a1 = 0.4; a2 = 0.35;l1 = 0.200 l2 = 0.175; l3 = 0.225; l4 = 0.225;Fx = 0; Fy = 0; Fz = 0; Mx = 0; My = 0; Mz = 0;
I1z = 0.515;I2z = 0.267;I3z = 0.062;

### 3.3.2 Tính chọn hộp giảm tốc

- Chọn hộp giảm tốc cho khớp 1

Với khớp 1 trong chương 2 em đã lựa chọn bộ truyền động là hộp giảm tốc bánh răng sóng

Theo tài liệu của hãng việc lựa chọn hộp giảm tốc dựa trên momen xoắn trung bình trên trục đầu ra của hộp giảm tốc

Bước 1 Lựa chọn sơ bộ

Áp dụng công thức

3

1 | 1 | 2 | 2
3 | 3
2 | 2 | 2

3
1 | 1 | 1
i | i
i | i | i
n | t | n | t | n | t
n | t | T | n | t | T | n | t | T
Tav
| | | × + | | × + ···· + | ×
× × | + | × × | + ····+ | × ×
=

Ta có

Tav1 = 93 < 113 | (N.m)

Tra bảng 126.1 - trang 126 catalog của hãng LLC ta chọn sơ bộ hộp giảm tốc loại

CSG − 25 − 80 − 2UH − SP

Bước 2 Tính kiểm nghiệm tốc độ đầu vào

Áp dụng công thức

i

i i
t | t | t
n t | n t | n t

### Nav

| + + ···
+ | + ···· +
=
1 | 2
1 1 | 1 2

Ta có

Noav = 1.7 (rad/s) =16.2 (vòng/phút)

→ Niav = Noav × R = 16.2 × 80 = 1296 (vòng/ phút) | (3.9)

NoMAX = 7(rad/s) = 66.8(vòng/pℎút)

→ NiMAX = NoMAX × R = 66.8 × 80 = 5344(vòng/pℎút) | (3.10)

Từ (3.9) và (3.10) ta có
{

Niav = 1296 < 3500(vòng/pℎút)
NiMAX = 5344 < 5600(vòng/pℎút)

→ CSG − 25 − 80 − 2UH − SP thỏa mãn điều kiện

Bước 3 Tính kiểm nghiệm momen

M1MAX = 125 < 178→ CSG − 25 − 80 − 2UH − SP thỏa mãn điều kiện

Bước 4 Tính kiểm nghiệm tuổi thọ làm việc

Áp dụng công thức :
( | ) ( | )
Niav

Nr
Tav

Tr Lh = Ln
× ×

ta có:

Lℎ1 = 7000 × (

82
93)

3
× (

2000
1296) = 7405 > 7000(LB10)

Vậy chọn hộp giảm tốc cho khớp 1 là loại CSG − 25 − 80 − 2UH − SP

- Chọn hộp giảm tôc cho khớp 2

Với khớp 2 trong chương 2 em đã lựa chọn bộ truyền động là hộp giảm tốc bánh răng sóng

Theo tài liệu của hang việc lựa chọn hộp giảm tốc dựa trên momen xoắn trung bình trên trục đầu ra của hộp giảm tốc

Bước 1 Tính chọn sơ bộ

Áp dụng công thức

3

1 | 1 | 2 | 2
3 | 3
2 | 2 | 2

3
1 | 1 | 1
i | i
i | i | i
n | t | n | t | n | t
n | t | T | n | t | T | n | t | T
Tav
| | | × + | | × + ···· + | ×
× × | + | × × | + ····+ | × ×
=

Ta có

Tav2 = 41 < 55 | (N.m)

Tra bảng 127.1 - trang 127 catalog của hãng LLC ta chọn sơ bộ hộp giảm tốc loại

CSF − 25 − 80 − 2UH − SP

Bước 2 Tính kiểm nghiệm tốc độ đầu vào

Áp dụng công thức:

i

i i
t | t | t
n t | n t | n t

### Nav

| + + ···
+ | + ···· +
=
1 | 2
1 1 | 1 2

Ta có

Noav = 3.8
(rad/s) =36.3 (vòng/phút)

→ Niav = Noav × R = 36 × 80 = 2904 (vòng/ phút) | (3.11)

NoMAX
= 6(red /s) = 57.3(vòng / phút)
→ NiMAX = NoMAX × R = 57.3 × 80 = 4584(vòng/pℎút) | (3.12)

Từ (3.11) và (3.12) ta có
{

Niav = 2904 < 3500(vòng/pℎút)
NiMAX = 4584 < 5600(vòng/pℎút)

→ CSF − 25 − 80 − 2UH − SP thỏa mãn điều kiện

Bước 3 Tính kiểm nghiệm momen

M2MAX = 41 < 137 → CSF − 25 − 80 − 2UH − SP thỏa mãn điều kiện

Bước 4 Tính kiểm nghiệm tuổi thọ làm việc

Áp dụng công thức:
( | ) ( | )
Niav

Nr
Tav

Tr Lh = Ln
× ×

ta có:

Lℎ1 = 7000 × (

63
41)

3
× (

2000
2904) = 17490 > 7000(LB10)

Vậy chọn hộp giảm tốc cho khớp 2 là loại CSF − 25 − 80 − 2UH − SP

- Chọn hộp giảm tốc cho khớp 3 và khớp 4
Như chương 2 em đã trình bày. Bộ chuyền động sử dụng cho khớp 3 và khớp 4 là bộ truyền động bánh răng con lăn.
Với việc sử dụng kết cấu khâu 3-4 là trục vít bi có đường kính trục là 15 mm ta chọn bộ truyền động cho khớp 3 và khớp 4 như sau.

Tra catalog của hãng LHK chọn model BNS với đường kính 15 mm chọn size BNS1616

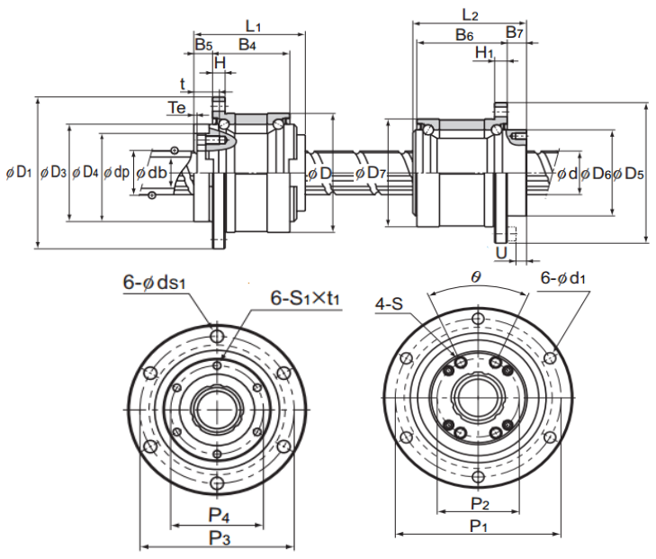
[picture p23: figure]

Hình 3.10 Thông số kích thước hộp giảm tốc con lăn [9] Bảng 3.2 Thông số kích thước ổ vit bi khớp 3

Model No | Screw shaft outer diameter d | Screw shaft inner diameter db | Lead Ph

Ball screw dimensions
Basic load rating | Ball center-to-center diameter dp | Thread minor diameter dc | Outer diameter D | Flange diamet er D1 | Overall length L1 | D3 h7
Ca kN | C0a kN
BNS 1616 | 15 | 11 | 16 | 3.9 | 7.2 | 16.65 | 13.7 | 52 0 -0.007 | 68 | 43.5 | 40

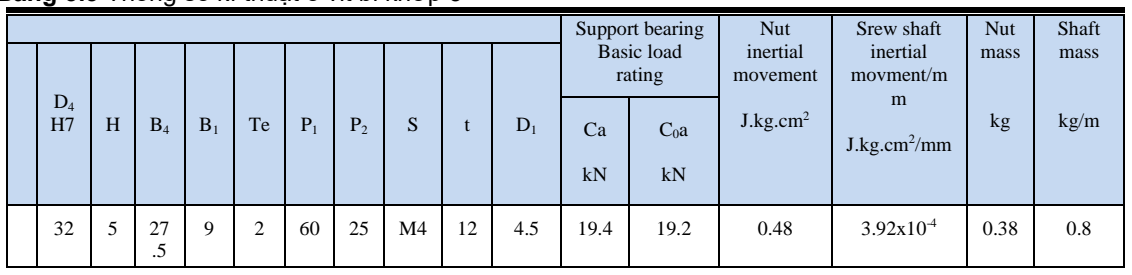
[picture p24: figure]
Support bearing Basic load rating; Nut inertial movement; J.kg.cm²; Srew shaft inertial movment/m m; J.kg.cm² /mm; Nut mass; Shaft mass

Bảng 3.3 Thông số kĩ thuật ổ vit bi khớp 3

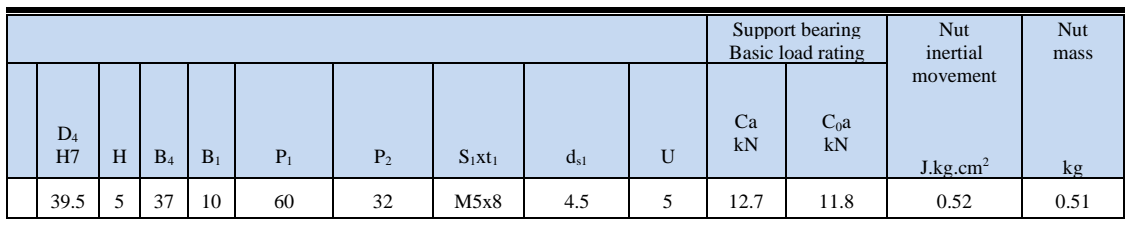
[picture p25: figure]
Support bearing Basic load rating; Nut inertial movement; J.kg.cm²; Nut mass

- Kiểm nghiệm ổ trục vit bi cho khớp 3 và khớp 4

Từ lực tĩnh tác động nên trục lấy từ kế quả bài toán tĩnh học ta có lực dọc trục tác động nên trục là F34=74 (N) ta xác định khả năng tải tĩnh của ổ:

fs =

C0a
Fa

=

7.2
0.074

= 97.3 > fs = 3 Vậy khả nảng tải tĩnh được thỏa mãn

Từ biểu đồ vận tốc trục vít bi ta thấy vận tốc lớn nhất của trục vít là 1,5 (m/s) tra catalog ta có fw=2 ta xác định tuổi thọ của ổ:

L = (

Ca
fW. Fa

)

3
× 10

6 = (

3.9
2 × 0.074)

3
× 10

6 = 1.83 × 10

10(ℎ)

Ball dimension
Basic load rating | Static permissible movement Ma N-m | Basic torque rating | Outer diameter D7 | Flange diameter D5 | Overall length L2
C kN | C0 kN | | CT N-m | Cor N-m
BNS 1616 | 7.1 | 12.6 | 67.6 | 31.4 | 34.3 | 52 0 -0.007 | 68 | 50

Bảng 3.5 Thông số kĩ thuật ổ vit bi khớp 4

## Chương 4

BẢN VẼ THIẾT KẾ

Dưới đây là bản vẽ tổng lắp robot, bản vẽ chi tiết sẽ được trình bày ở phần phụ luc B bản vẽ thiết kế

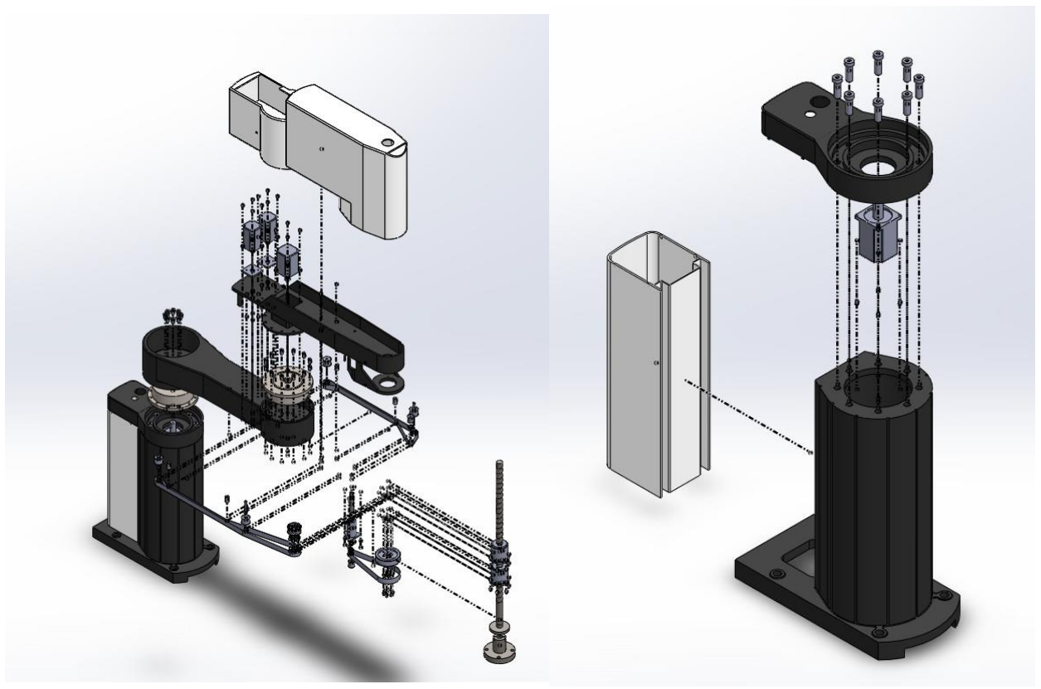
[picture p26: figure]

Hình 4.2 Bản vẽ tách các chi tiết

### KẾT LUẬN

Trong thời gian làm đồ án dưới sự hướng dẫn tận tình của TS. Nguyễn Hồng Thái em đã

hoàn thành đồ án và đạt được những kết quả sau đây:

Các kết quả đạt được

1. Tìm hiểu về cấu trúc robot Scara.
2. Tính toán động học, tĩnh học, động lực học, miền làm việc của robot Scara.
3. Hoàn thiện kỹ năng thiết kế và trình bày bản vẽ trên Solidworks.

### TÀI LIỆU THAM KHẢO

1. Nguyễn Văn Khang, “Động lực học hệ nhiều vật”, Nhà xuất bản Khoa học và Kỹ thuật, Hà nội 2007.
2. GS.TSKH. Nguyễn Văn Khang, TS. Chu Anh Mỳ, “Cơ sở robot công nghiệp”, Nhà xuất bản giáo dục Việt Nam, Hà Nội 2011.
3. Đào Văn Hiệp, “Kỹ thuật robot”, Nhà xuất bản khoa học và kỹ thuật, Hà nội, 2004.
4. Nguyễn Hồng Thái, “Ứng dụng Solidworks trong thiết kế cơ khí”, Nhà xuất bản Khoa học và kỹ thuật, Hà Nội, 2006
5. Karl Mathia, “Robotics for Electronics Manuafacturing”, Cambridge University, 2010.
6. Reza N. Jazar, “Theory of Applied Robotics”, Springer, 2010.
7. Prof. Alessandro De Luca, Lecture “ Dynamic model of robots: Newton-Euler approach”, Università Di Roma.
8. Catalog bánh răng sóng của hãng LLC “Harmonic Drive LLC 800-921-3332”
9. Catalog bánh răng con lăn của hãng THK “ Gerenal catalog THK”
10. Tài liệu của hãng Rexroth “Turboscara SR4/6/8plus Mechanical manual”
11. Matlab tutorial, website: http://www.mathworks.com/help/matlab/code-to-run-the-gui.html
