MynhLoveBunCha/project_1_undergraduate/doan_nhat_minh_bia.pdf

ĐẠI HỌC BÁCH KHOA HÀ NỘI

TRƯỜNG CƠ KHÍ

KHOA CƠ ĐIỆN TỬ

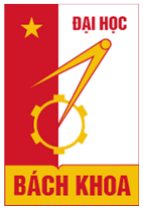
[picture p27: figure]

### ĐỒ ÁN THIẾT KẾ HỆ THỐNG CƠ ĐIỆN TỬ

### Đề tài: Tính toán thiết kế robot SCARA 4 bậc tự do

Mã học phần: ME3066

Ngành Kỹ thuật Cơ điện tử
Giảng viên hướng dẫn: TS. Nguyễn Hồng Thái

Sinh viên thực hiện:

Doãn Nhật Minh | 20195793

HÀ NỘI, 08/2023
