MynhLoveBunCha/project_1_undergraduate/arm.png

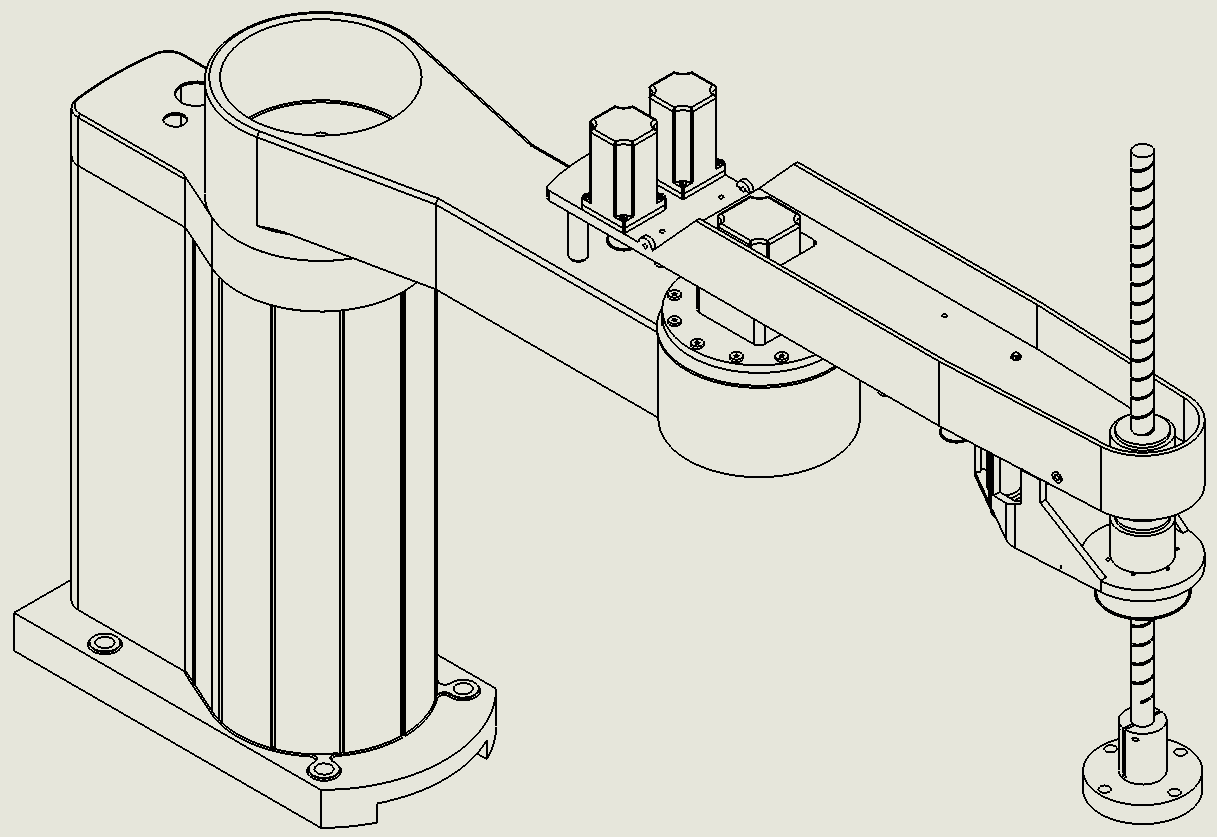
arm.png
