MynhLoveBunCha/project_1_undergraduate/arm_mass.png

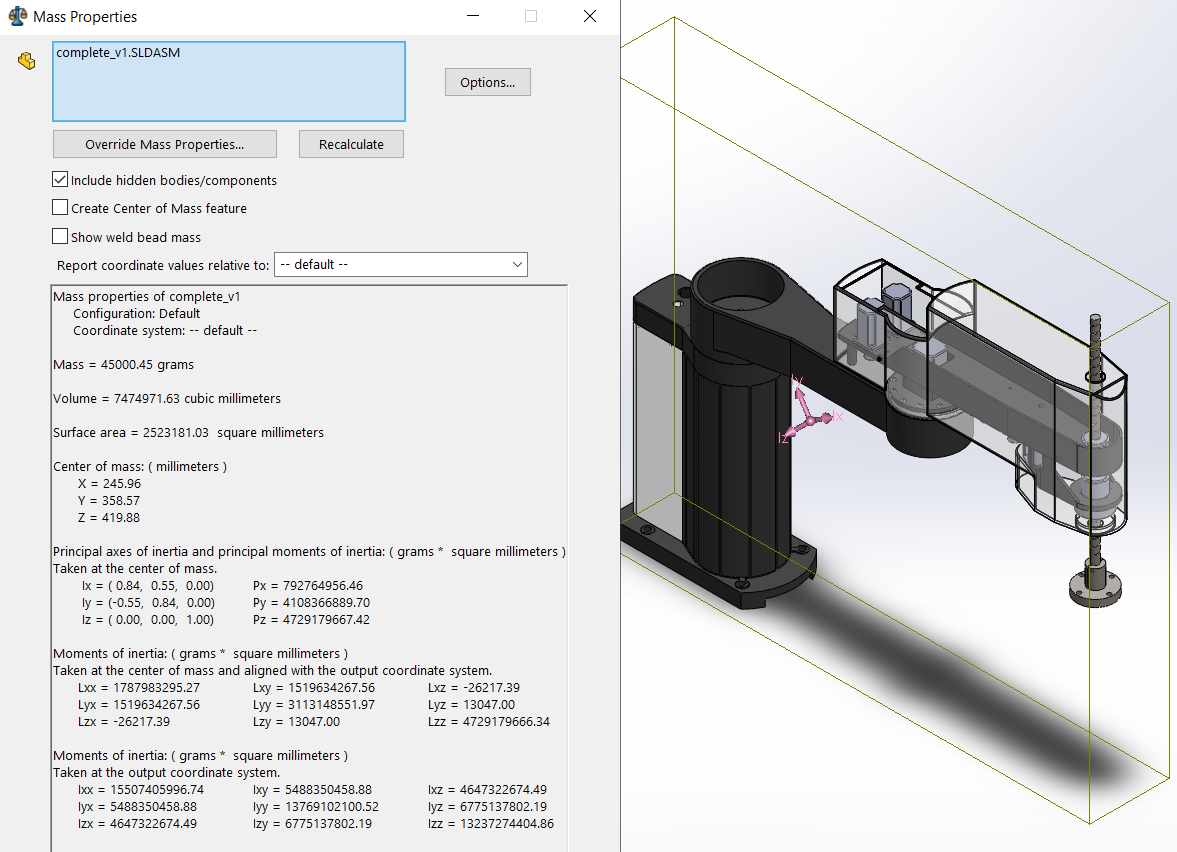
arm_mass.png
