MynhLoveBunCha/project_1_undergraduate/base_mass.png

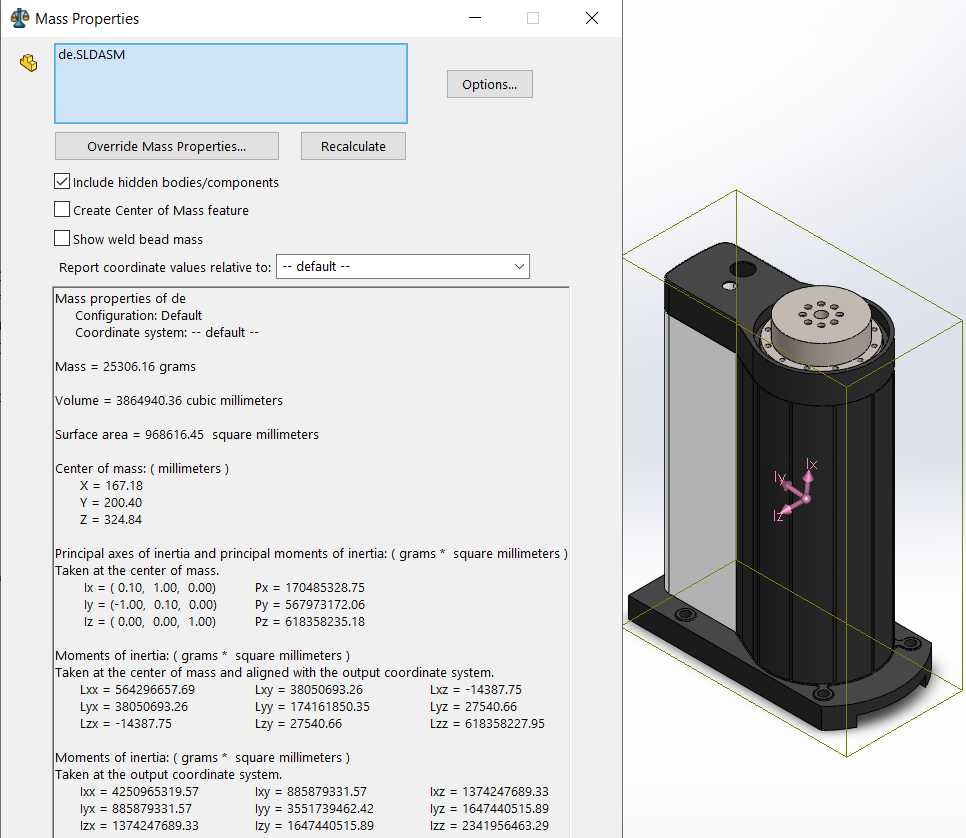
base_mass.png
