MynhLoveBunCha/project_1_undergraduate/khau1.png

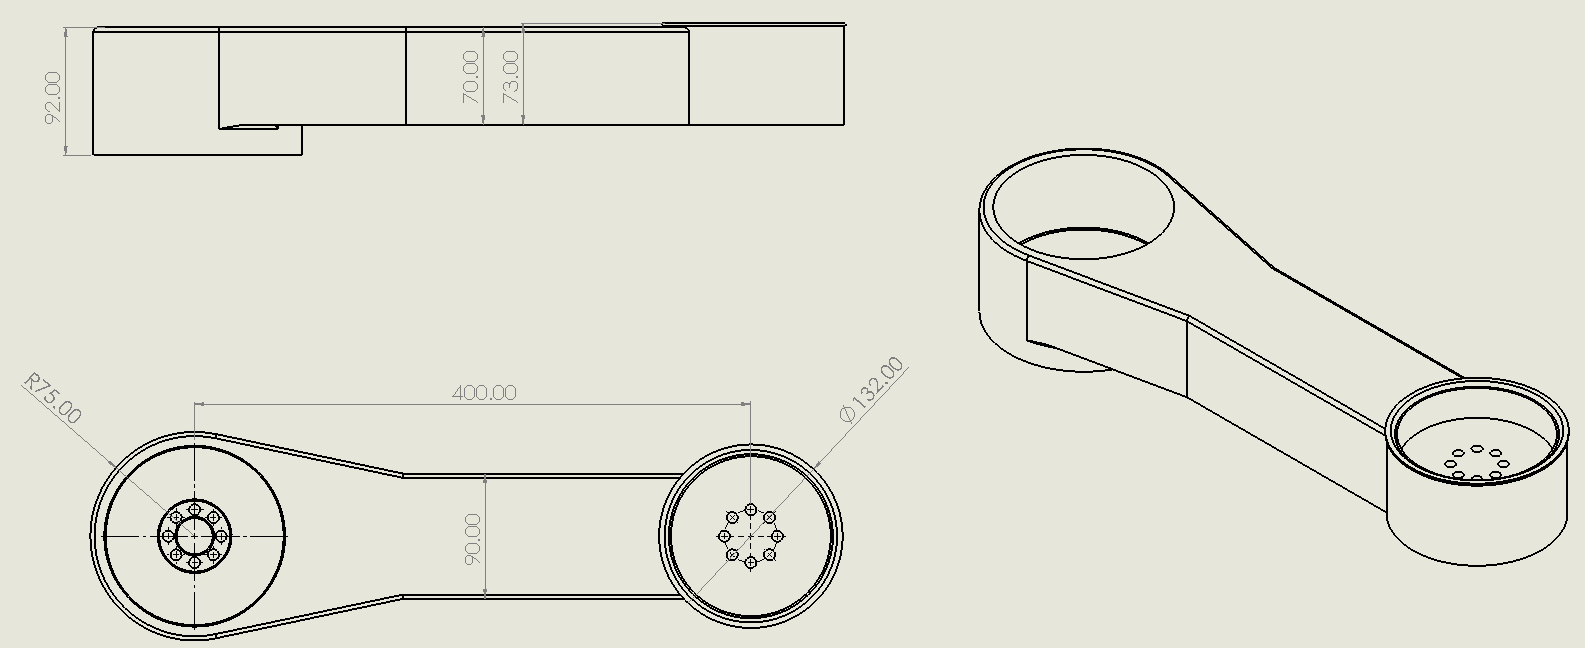
khau1.png
