MynhLoveBunCha/project_1_undergraduate/khau1_mass.png

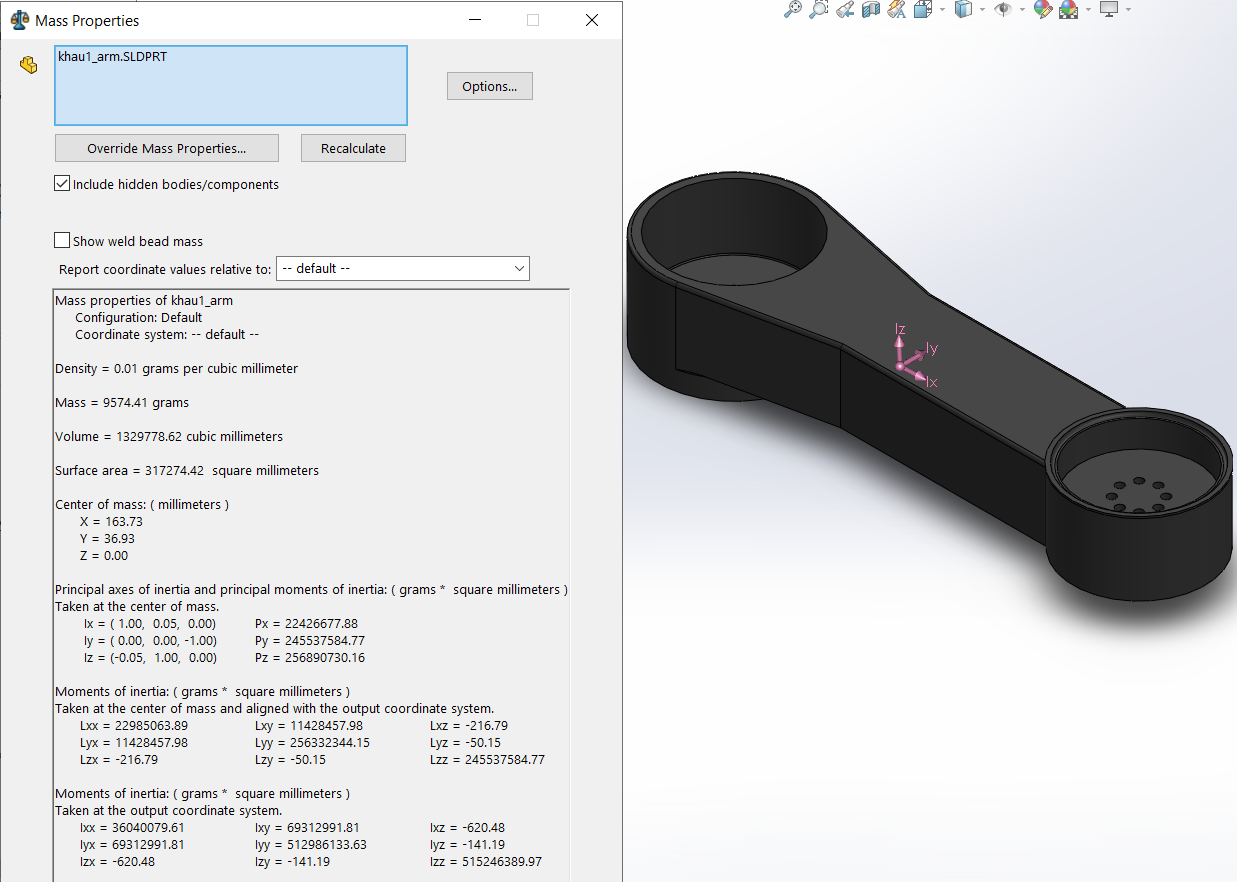
khau1_mass.png
