MynhLoveBunCha/project_1_undergraduate/khau34.png

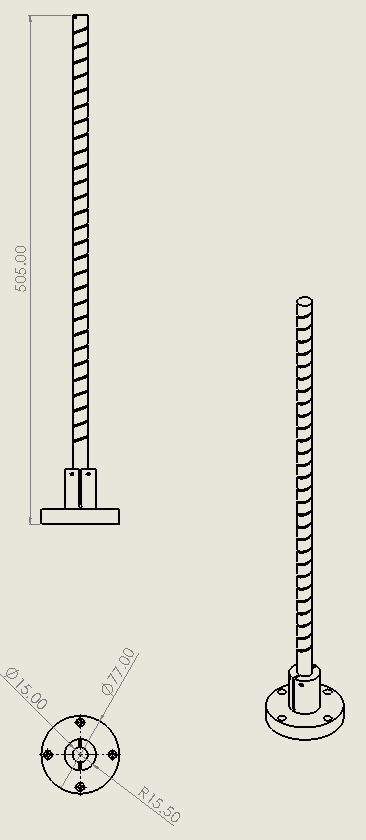
khau34.png
