MynhLoveBunCha/project_1_undergraduate/khau34_mass.png

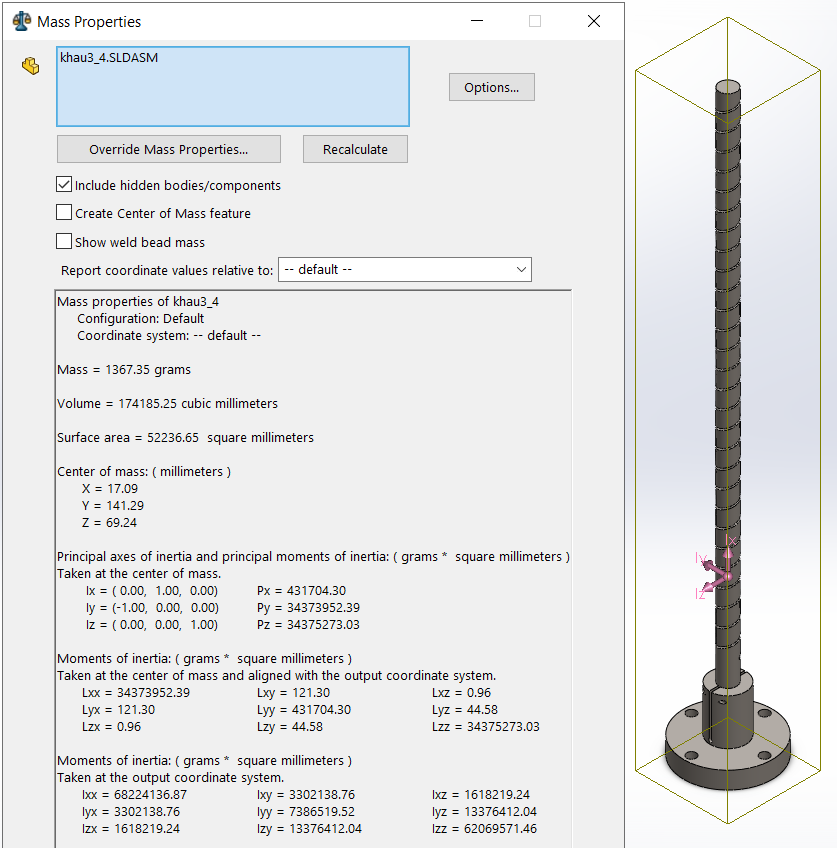
khau34_mass.png
