MynhLoveBunCha/project_1_undergraduate/lua_chon_hop_giam_toc.png

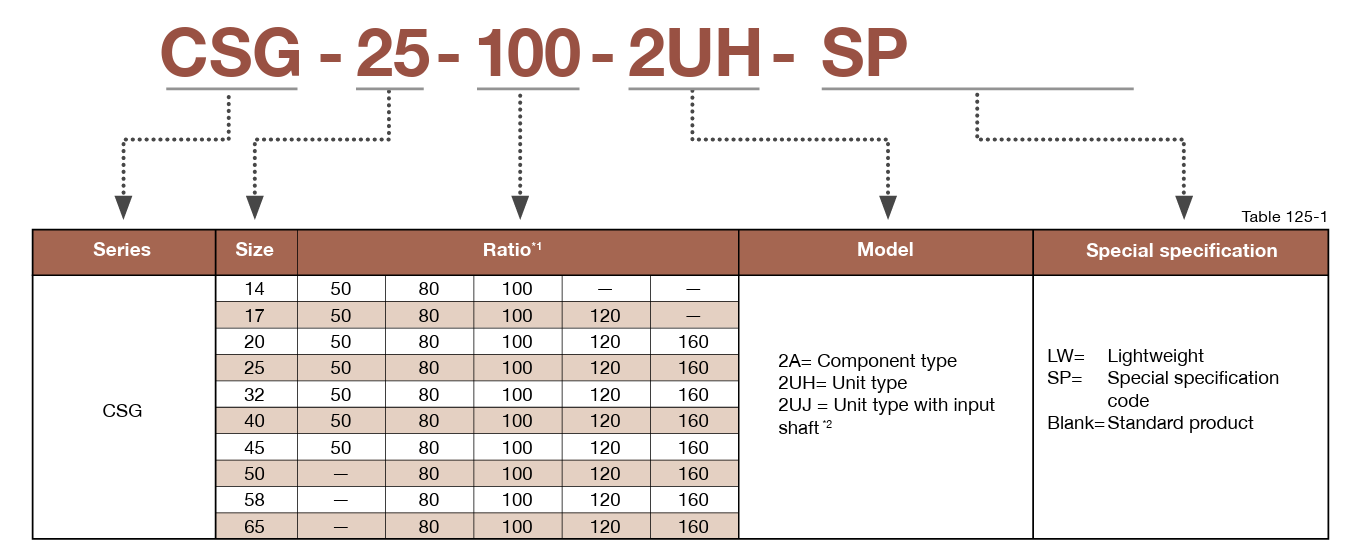
lua_chon_hop_giam_toc.png
