MynhLoveBunCha/project_1_undergraduate/matlab/matlab.png

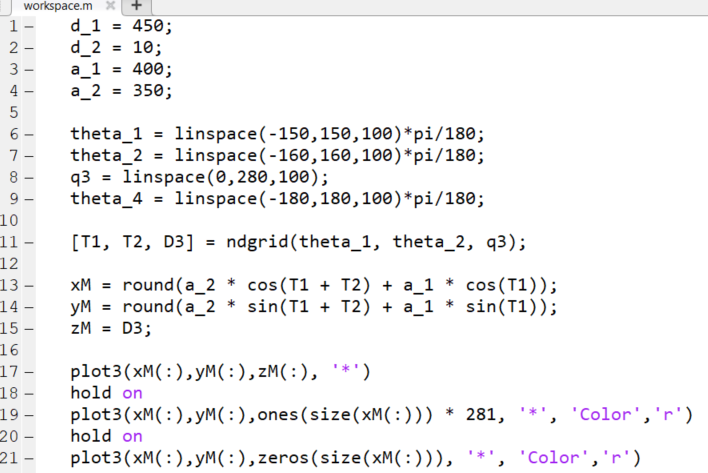
matlab/matlab.png
