MynhLoveBunCha/project_1_undergraduate/references/ĐATKHTCK/bản vẽ khâu 34.SLDASM

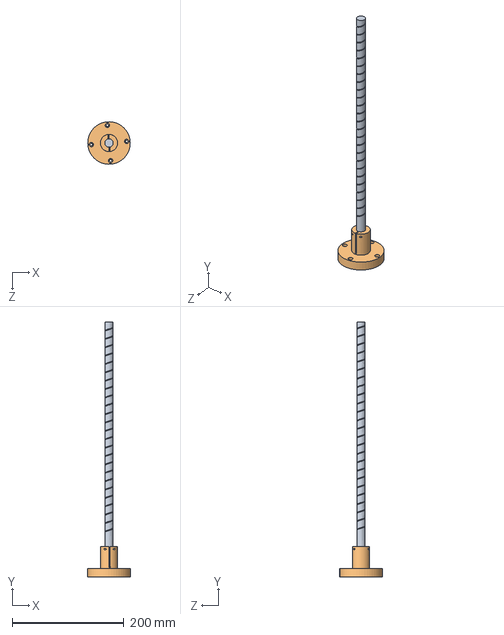
[picture p38: CAD file, 2024-04-25]
references/ĐATKHTCK/bản vẽ khâu 34.SLDASM
76.2 x 457.0 x 76.2 mm
khau 5
khau6c
