MynhLoveBunCha/project_1_undergraduate/CAD/complete_v1.SLDASM

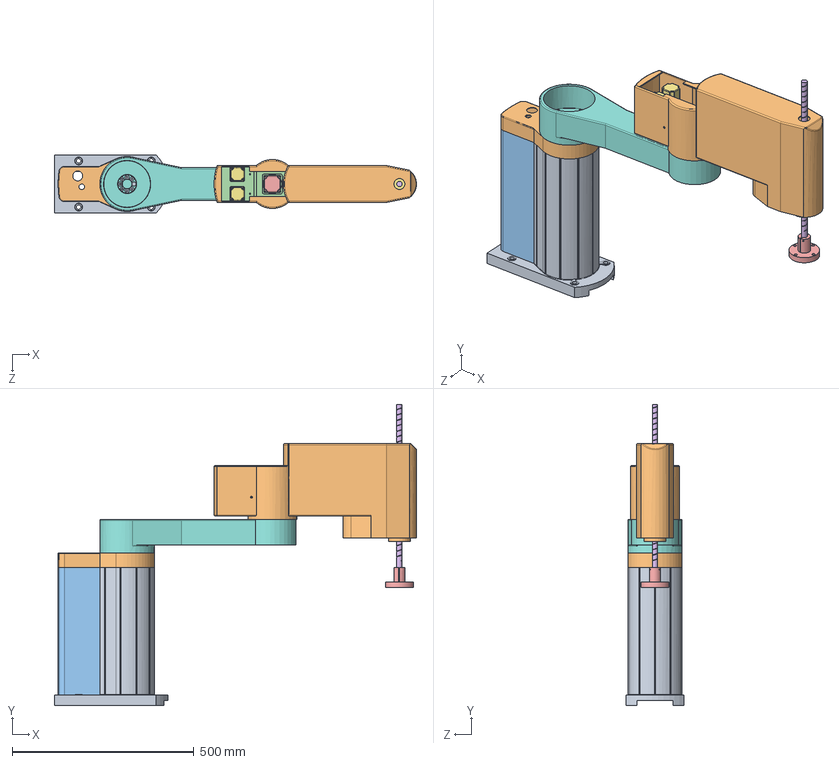
[picture p39: CAD file, 2024-04-25]
CAD/complete_v1.SLDASM
997.0 x 830.1 x 160.0 mm
khau0_base
khau0_base_connector
khau0_base_support
speed_reducer x 2
moto2 x 2
vit3.5 x 24
vit1 x 8
khau1_arm
vitphi4 x 8
vitphi6.2 x 12
vitphi8.2 x 8
khau2_arm
end_effector
lead_screw
khop3 x 2
pulykhop3_11
banhdaikhop4
vitphi2.5l2 x 6
vitphi2.6dai12.5 x 6
vitphi2.5l3 x 6
vitphi2.6 x 6
pulyphu18 x 4
vit3.5chopulyphu x 4
namgiuatruc
pulitructrunggian x 2
tructrunggian
vitphi2 x 5
pulyphu x 2
vitchung x 2
matdemchuan x 2
moto0 x 2
pulykhau2 x 2
vitdut x 2
khau2_cover
vongbi x 2
