MynhLoveBunCha/project_1_undergraduate/references/ĐATKHTCK/ĐAHTKCk.SLDASM

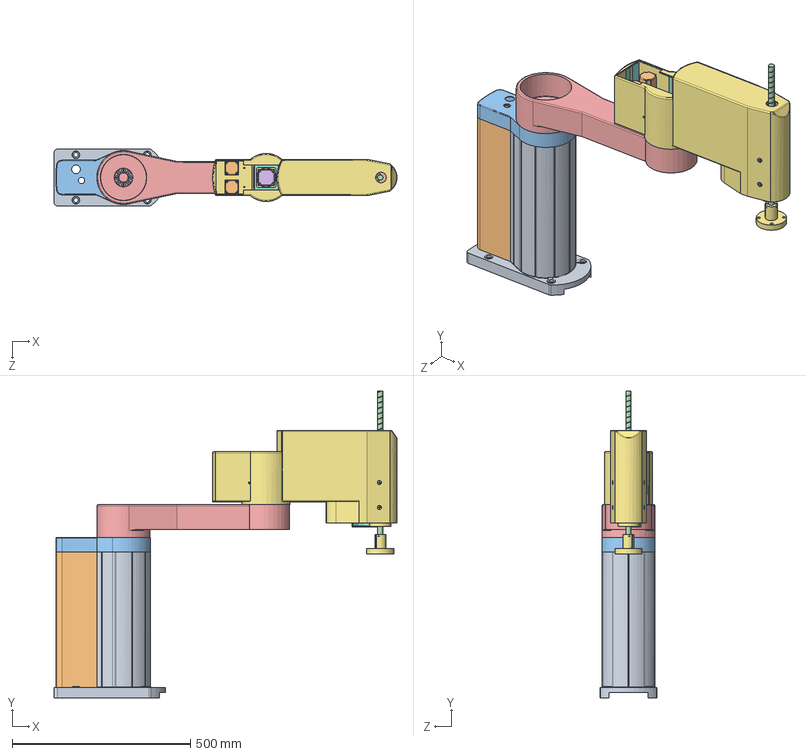
[picture p40: CAD file, 2024-04-25]
references/ĐATKHTCK/ĐAHTKCk.SLDASM
961.9 x 860.8 x 160.0 mm
khau0khaude
ganvoikhaude
khaudeganvoikhau1
utronxoay x 2
khau1
moto2 x 2
khau1c
khau2chuan
tructrunggian
namgiuatruc
banhdaikhop4
pulitructrunggian x 2
khop3 x 2
pulykhop3_11
pulyphu x 2
pulyphu18 x 4
matdemchuan x 2
moto0 x 2
pulykhau2 x 2
khau 5
daikhop34
hahaha
khau6c
vongbi x 2
vit1 x 8
vit3.5 x 20
vitphi4 x 8
vitphi8.2 x 8
vitphi6.2 x 12
vitphi2.6 x 6
vitphi2.5l2 x 12
vitphi2.5l3 x 6
vit3.5chopulyphu x 8
vitconap x 4
vitchung x 2
vitdut x 2
vitphi2 x 3
hihihi
