MynhLoveBunCha/project_1_undergraduate/CAD/de.SLDASM

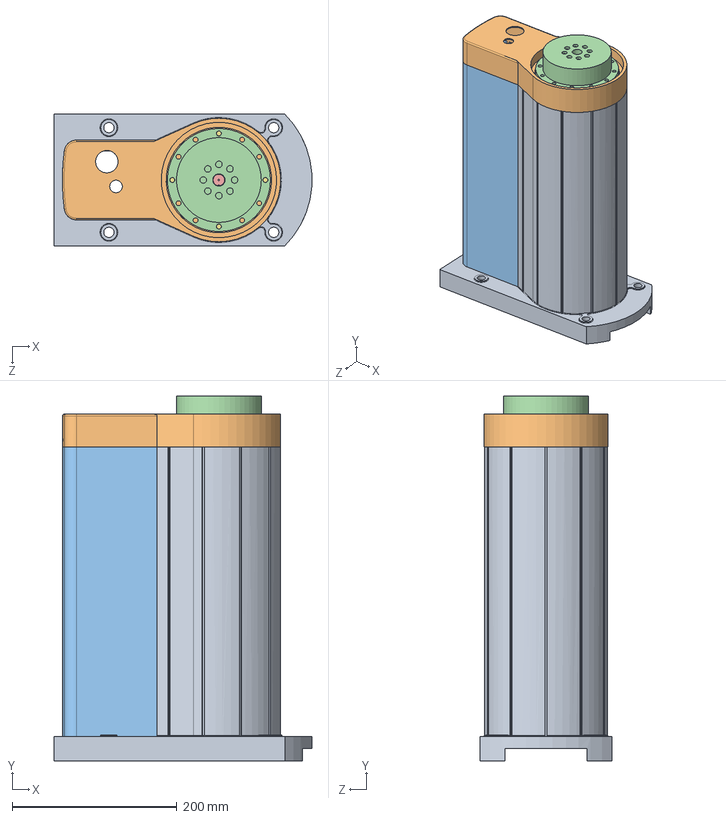
[picture p41: CAD file, 2024-04-25]
CAD/de.SLDASM
312.8 x 443.1 x 160.0 mm
khau0_base
khau0_base_connector
khau0_base_support
speed_reducer
moto2
vit3.5 x 4
vit1 x 8
