MynhLoveBunCha/project_1_undergraduate/references/ĐATKHTCK/Assemtoithu9.SLDASM

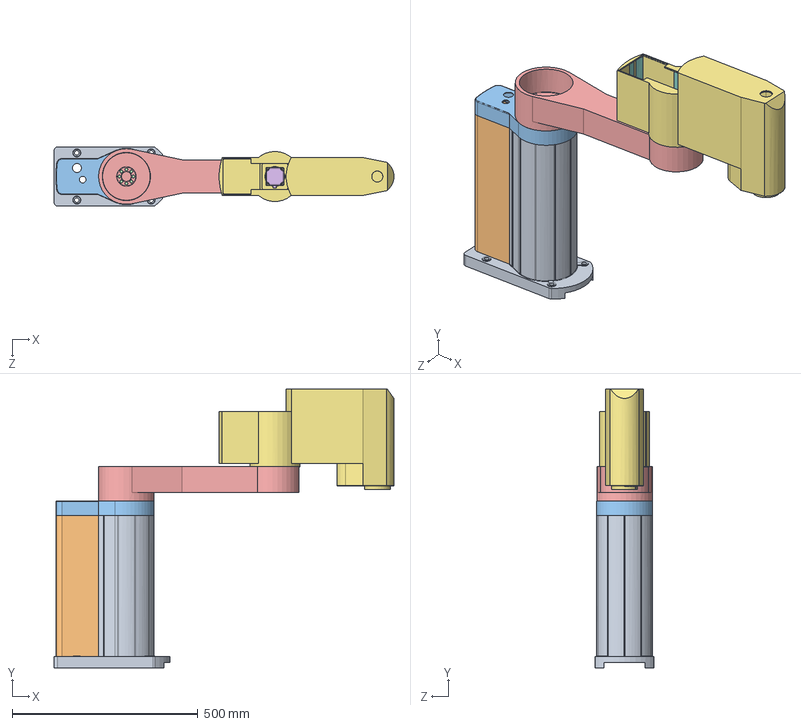
[picture p42: CAD file, 2024-04-25]
references/ĐATKHTCK/Assemtoithu9.SLDASM
915.8 x 750.8 x 160.0 mm
khau0khaude
ganvoikhaude
khaudeganvoikhau1
utronxoay x 2
khau1
moto2 x 2
khau1c
khau2chuan
tructrunggian
namgiuatruc
banhdaikhop4
pulitructrunggian x 2
