MynhLoveBunCha/project_1_undergraduate/CAD/khau3_4.SLDASM

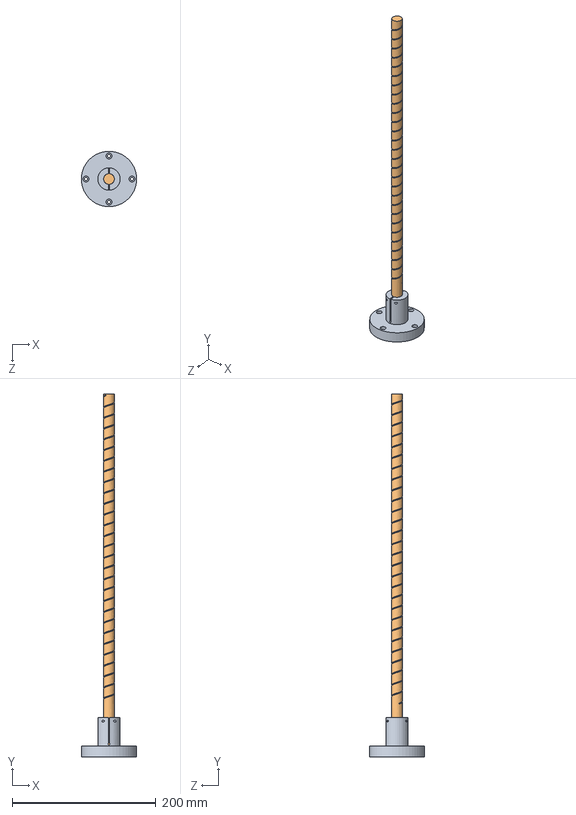
[picture p43: CAD file, 2024-04-25]
CAD/khau3_4.SLDASM
76.8 x 505.0 x 77.0 mm
end_effector
lead_screw
