MynhLoveBunCha/project_1_undergraduate/references/ĐATKHTCK/Assemdan.SLDASM

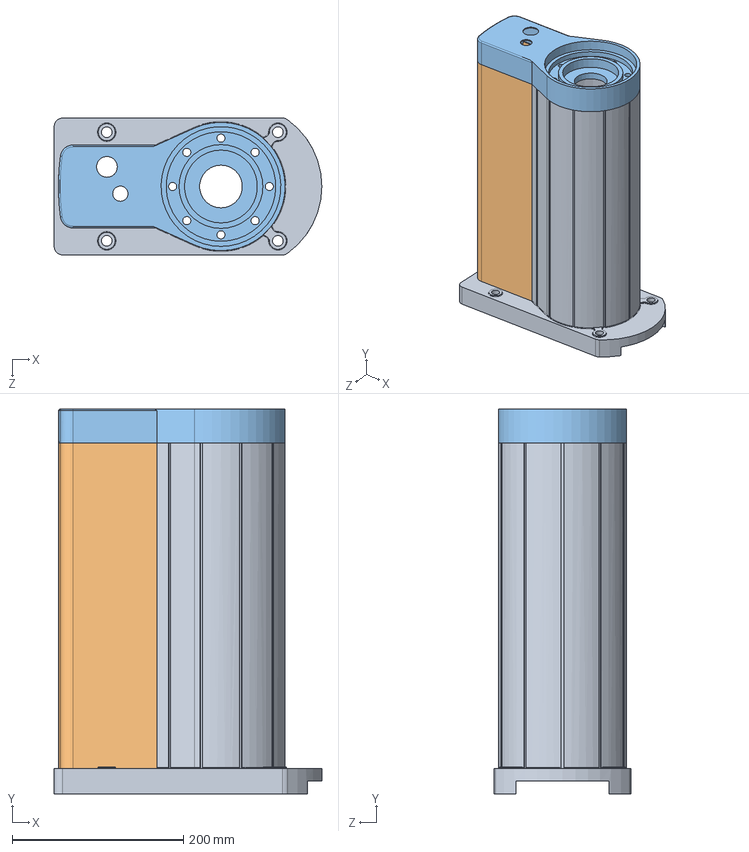
[picture p44: CAD file, 2024-04-25]
references/ĐATKHTCK/Assemdan.SLDASM
312.9 x 450.0 x 160.0 mm
khau0khaude
ganvoikhaude
khaudeganvoikhau1
