MynhLoveBunCha/project_1_undergraduate/references/ĐATKHTCK/Assemtoithu8.SLDASM

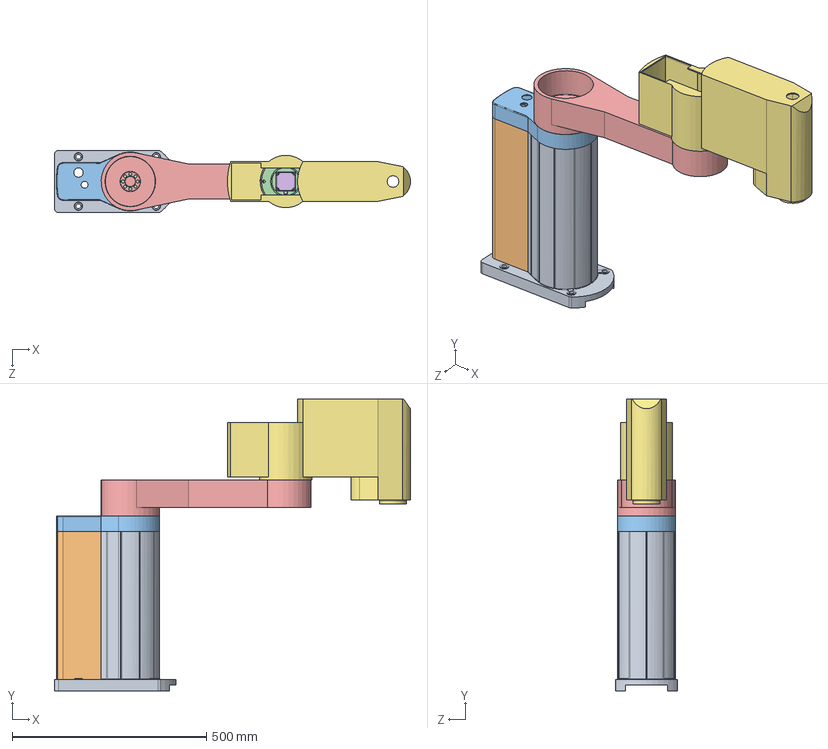
[picture p45: CAD file, 2024-04-25]
references/ĐATKHTCK/Assemtoithu8.SLDASM
915.8 x 751.0 x 160.0 mm
khau0khaude
ganvoikhaude
khaudeganvoikhau1
utronxoay x 2
khau1
moto2 x 2
khau3
