MynhLoveBunCha/project_1_undergraduate/references/ĐATKHTCK/Assemtoithu11.SLDASM

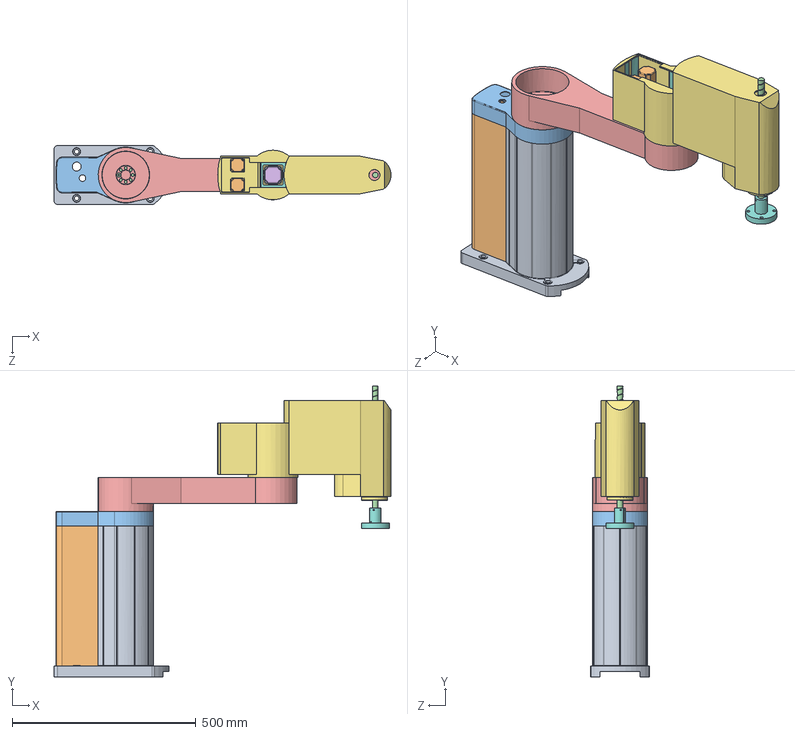
[picture p46: CAD file, 2024-04-25]
references/ĐATKHTCK/Assemtoithu11.SLDASM
915.8 x 790.8 x 160.0 mm
khau0khaude
ganvoikhaude
khaudeganvoikhau1
utronxoay x 2
khau1
moto2 x 2
khau1c
khau2chuan
tructrunggian
namgiuatruc
banhdaikhop4
pulitructrunggian x 2
khop3 x 2
pulykhop3_11
pulyphu x 2
pulyphu18 x 4
matdemchuan x 2
moto0 x 2
pulykhau2 x 2
khau 5
daikhop34
hahaha
hihihi
khau6c
vongbi x 2
vit1
vit3.5 x 4
vitphi4
vitphi8.2
vitphi6.2
vitphi2.6
vitphi2.5l2 x 2
vitphi2.5l3
