MynhLoveBunCha/project_1_undergraduate/references/ĐATKHTCK/asssem4.SLDASM

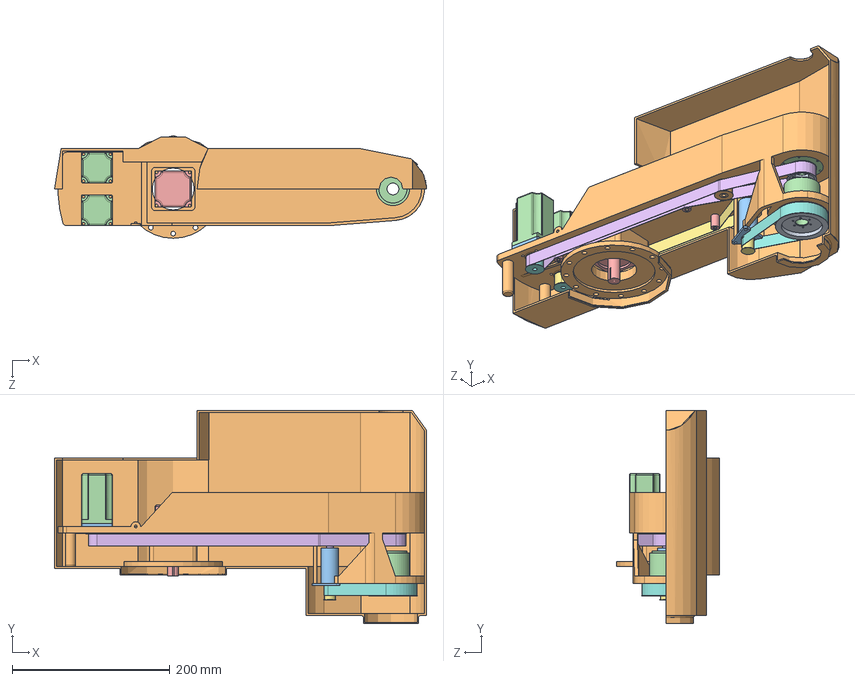
[picture p47: CAD file, 2024-04-25]
references/ĐATKHTCK/asssem4.SLDASM
471.1 x 270.0 x 130.0 mm
banhdaikhop4
khau2chuan
matdemchuan x 2
moto0 x 2
moto2
namgiuatruc
pulitructrunggian x 2
pulykhau2 x 2
pulykhop3_11
pulyphu x 2
tructrunggian
khop3 x 2
pulyphu18 x 4
hahaha
hihihi
daikhop34
