MynhLoveBunCha/project_1_undergraduate/CAD/vitphi2.5l2.SLDPRT

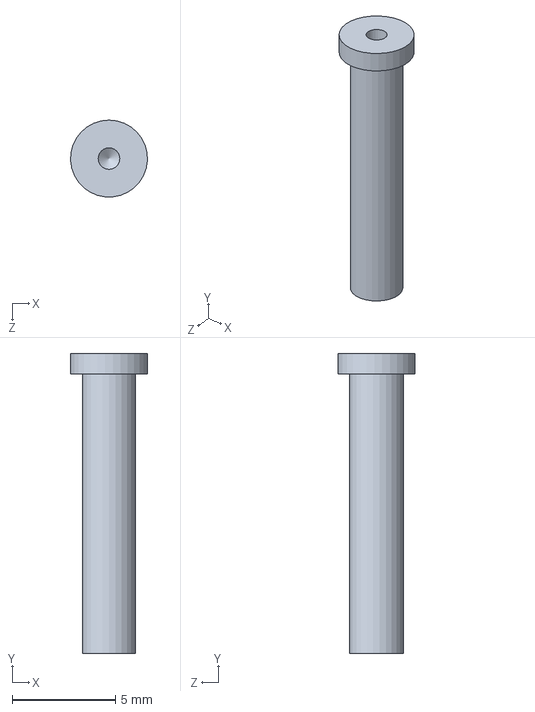
[picture p49: CAD file, 2024-04-25]
CAD/vitphi2.5l2.SLDPRT
3.72 x 14.5 x 3.71 mm
