MynhLoveBunCha/project_1_undergraduate/references/ĐATKHTCK/khau6c.SLDPRT

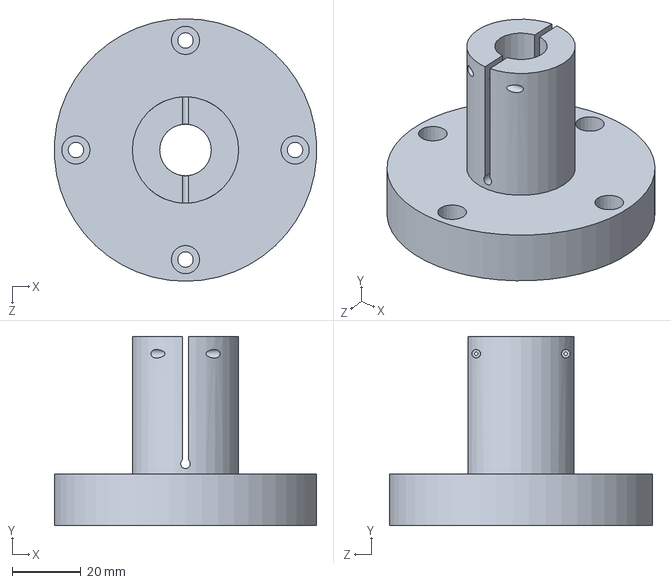
[picture p50: CAD file, 2024-04-25]
references/ĐATKHTCK/khau6c.SLDPRT
76.1 x 55.0 x 76.2 mm
