MynhLoveBunCha/project_1_undergraduate/CAD/khau0_base_connector.SLDPRT

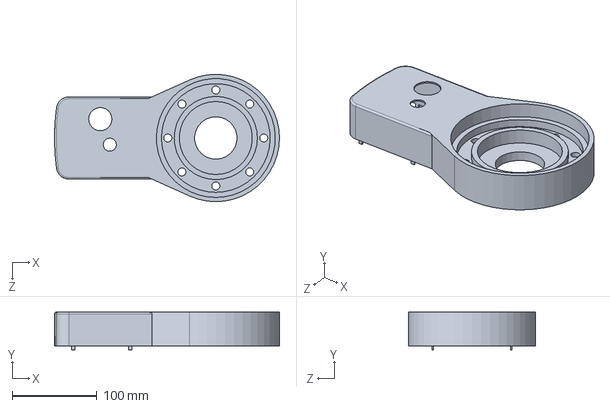
[picture p51: CAD file, 2024-04-25]
CAD/khau0_base_connector.SLDPRT
265.0 x 44.5 x 150.0 mm
