MynhLoveBunCha/project_1_undergraduate/CAD/vit3.5chopulyphu.SLDPRT

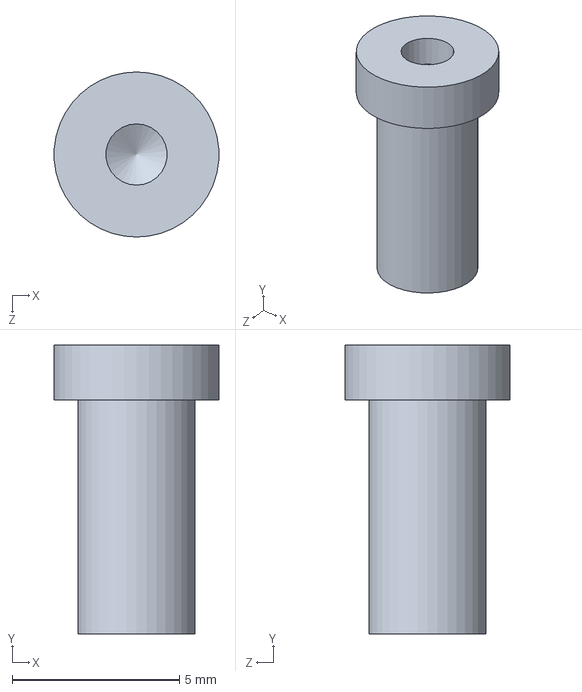
[picture p52: CAD file, 2024-04-25]
CAD/vit3.5chopulyphu.SLDPRT
4.92 x 8.65 x 4.94 mm
