MynhLoveBunCha/project_1_undergraduate/references/ĐATKHTCK/daikhop34.SLDPRT

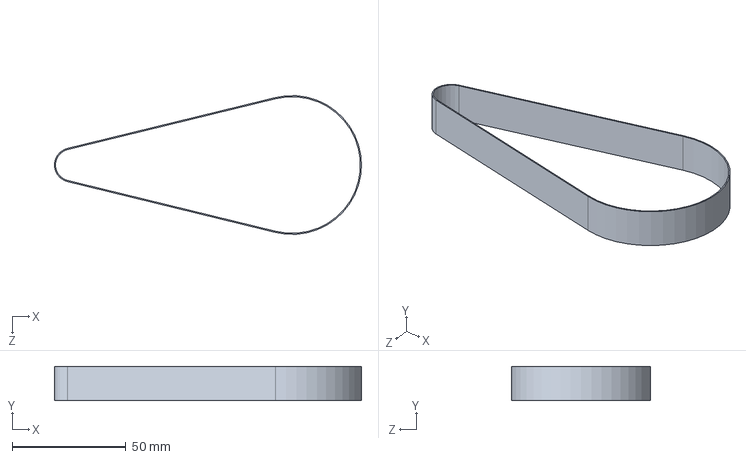
[picture p53: CAD file, 2024-04-25]
references/ĐATKHTCK/daikhop34.SLDPRT
134.8 x 15.0 x 60.9 mm
