MynhLoveBunCha/project_1_undergraduate/CAD/matdemchuan.SLDPRT

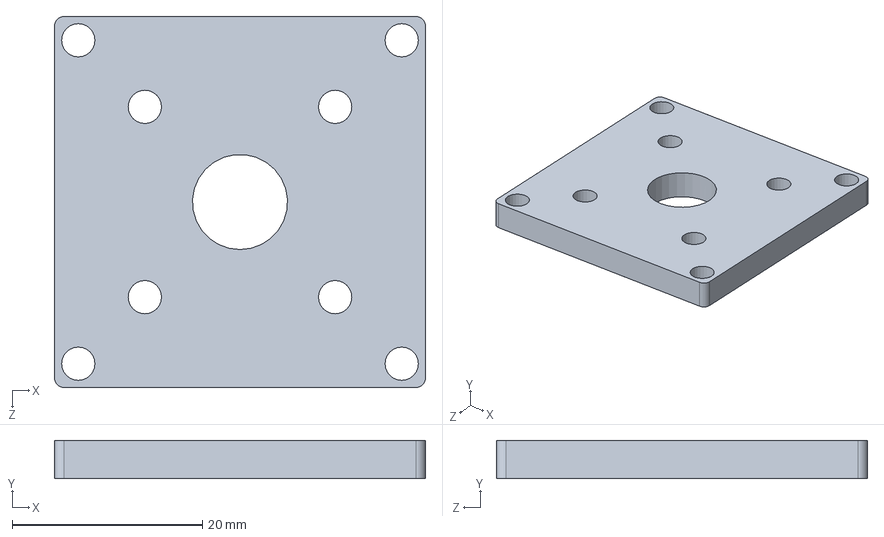
[picture p54: CAD file, 2024-04-25]
CAD/matdemchuan.SLDPRT
39.0 x 4.00 x 39.0 mm
