MynhLoveBunCha/project_1_undergraduate/references/ĐATKHTCK/namgiuatruc.SLDPRT

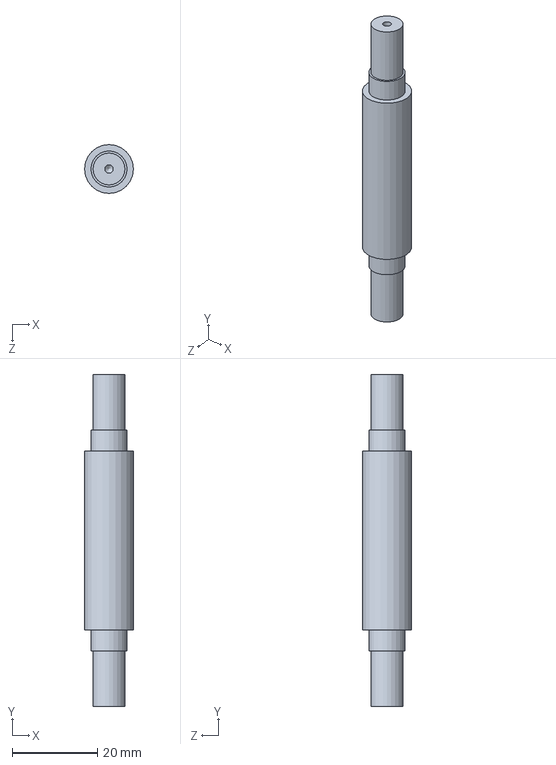
[picture p55: CAD file, 2024-04-25]
references/ĐATKHTCK/namgiuatruc.SLDPRT
11.5 x 78.0 x 11.5 mm
