MynhLoveBunCha/project_1_undergraduate/CAD/tructrunggian.SLDPRT

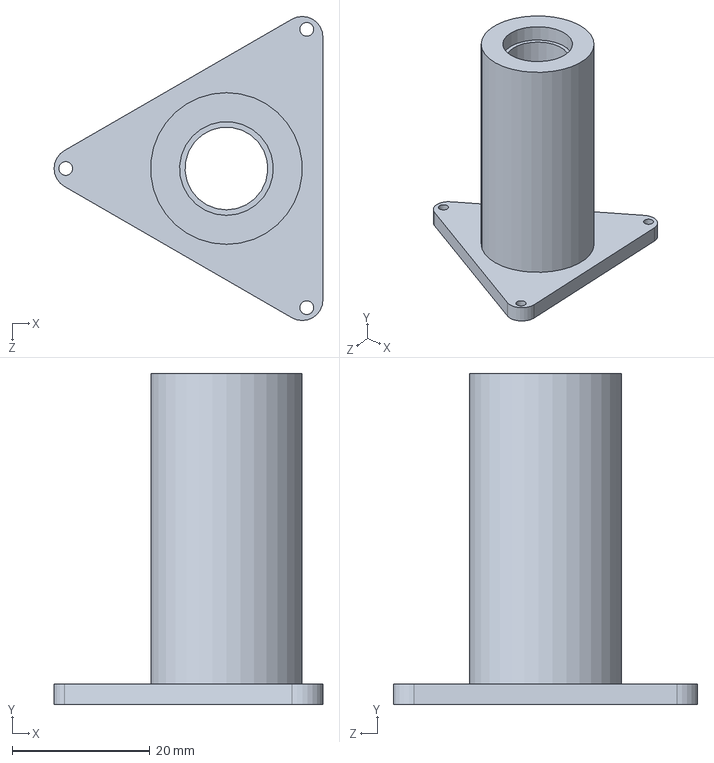
[picture p56: CAD file, 2024-04-25]
CAD/tructrunggian.SLDPRT
39.0 x 48.0 x 44.1 mm
