MynhLoveBunCha/project_1_undergraduate/references/ĐATKHTCK/pulykhau2.SLDPRT

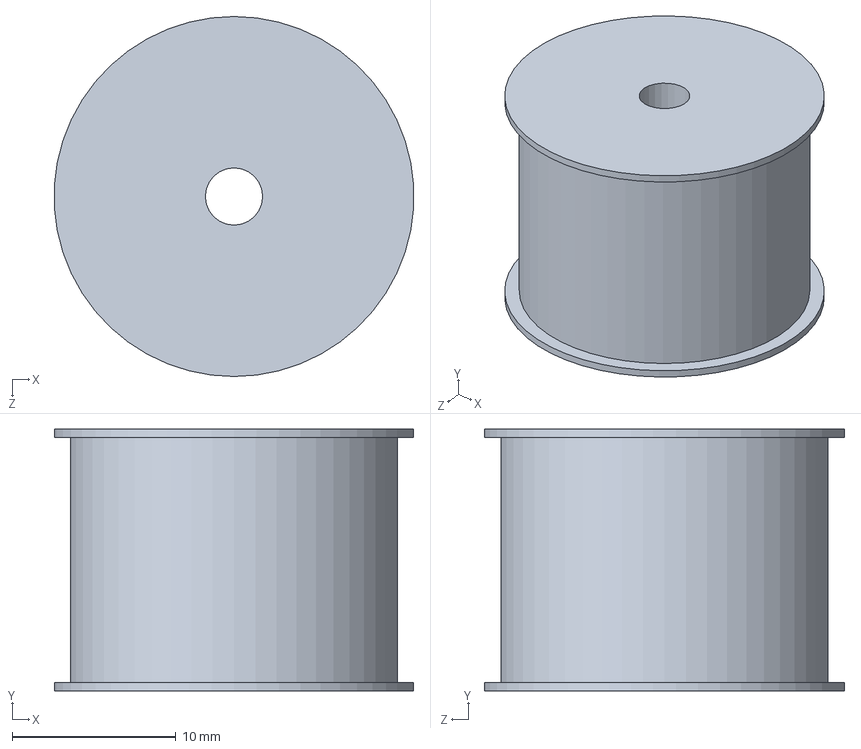
[picture p57: CAD file, 2024-04-25]
references/ĐATKHTCK/pulykhau2.SLDPRT
22.0 x 16.0 x 22.0 mm
