MynhLoveBunCha/project_1_undergraduate/CAD/vitphi2.5l3.SLDPRT

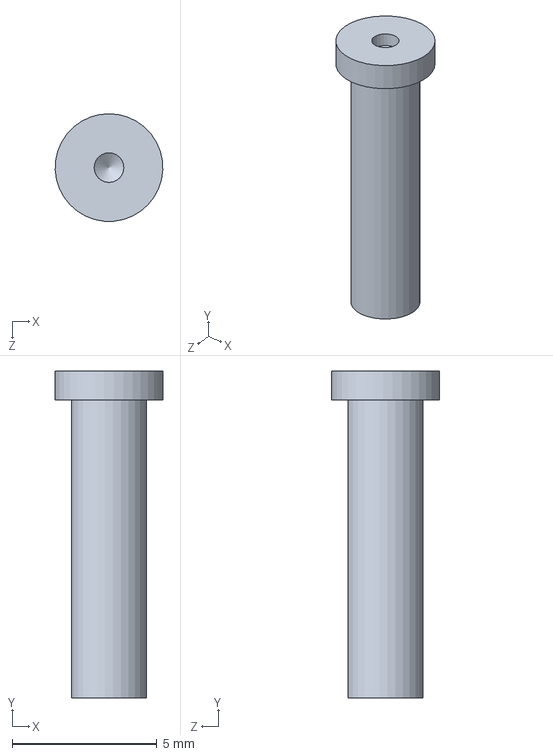
[picture p58: CAD file, 2024-04-25]
CAD/vitphi2.5l3.SLDPRT
3.72 x 11.3 x 3.72 mm
