MynhLoveBunCha/project_1_undergraduate/references/ĐATKHTCK/banhdaikhop4.SLDPRT

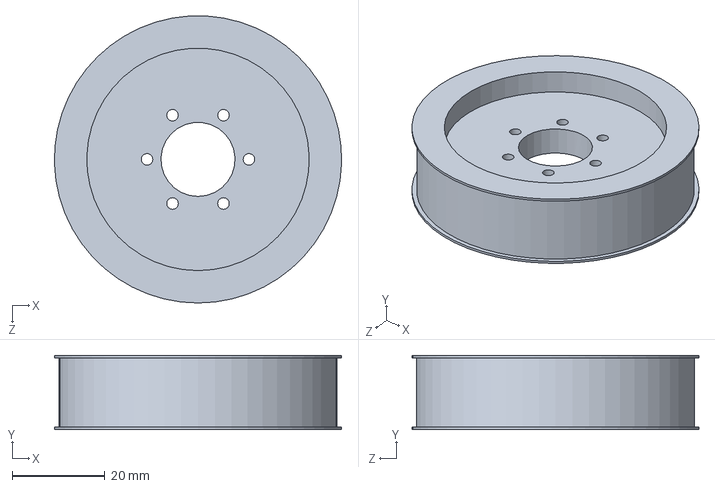
[picture p59: CAD file, 2024-04-25]
references/ĐATKHTCK/banhdaikhop4.SLDPRT
62.0 x 16.0 x 61.9 mm
