MynhLoveBunCha/project_1_undergraduate/CAD/moto0.SLDPRT

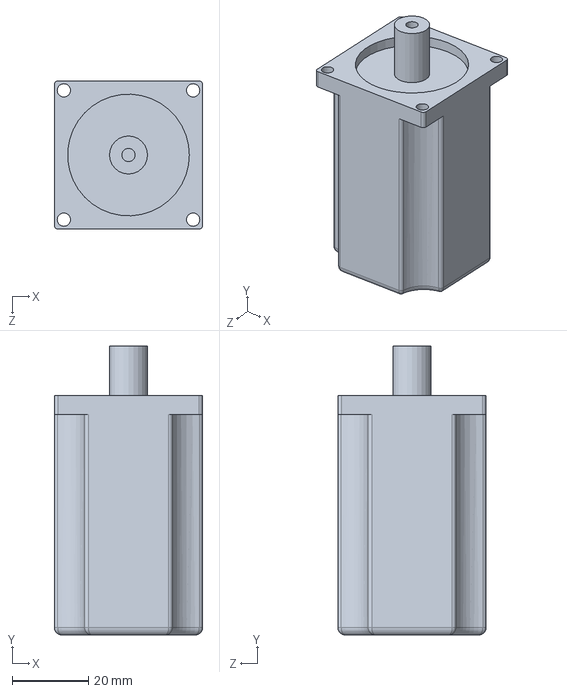
[picture p60: CAD file, 2024-04-25]
CAD/moto0.SLDPRT
39.0 x 76.0 x 39.0 mm
