MynhLoveBunCha/project_1_undergraduate/references/ĐATKHTCK/vitphi2.6.SLDPRT

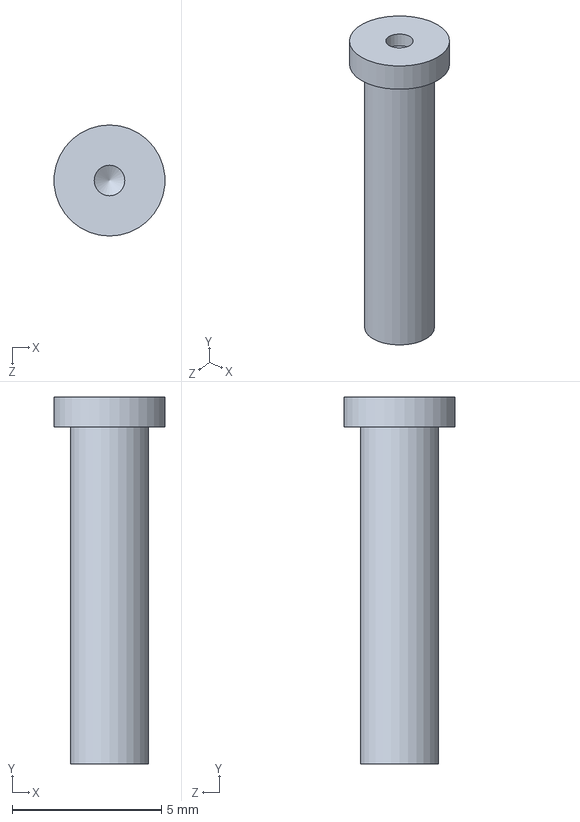
[picture p61: CAD file, 2024-04-25]
references/ĐATKHTCK/vitphi2.6.SLDPRT
3.71 x 12.3 x 3.72 mm
