MynhLoveBunCha/project_1_undergraduate/references/ĐATKHTCK/pulitructrunggian.SLDPRT

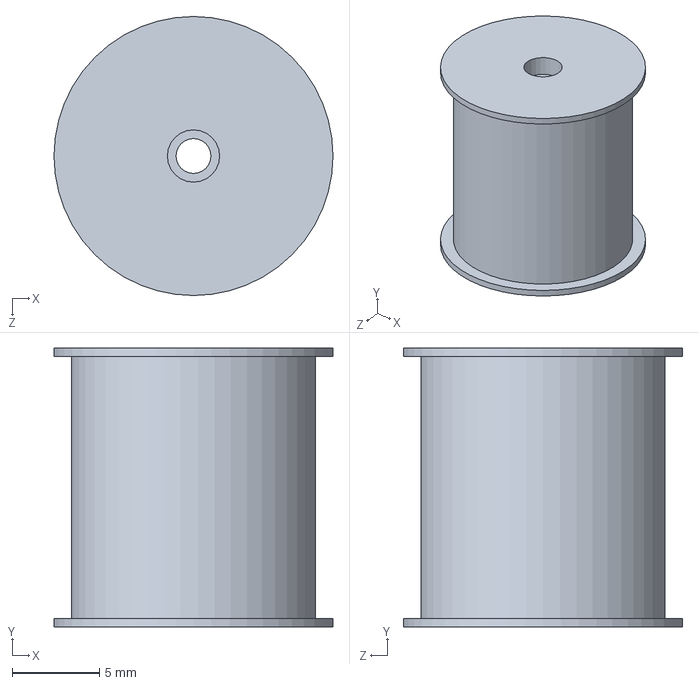
[picture p62: CAD file, 2024-04-25]
references/ĐATKHTCK/pulitructrunggian.SLDPRT
16.0 x 16.0 x 16.0 mm
