MynhLoveBunCha/project_1_undergraduate/CAD/vitphi6.2.SLDPRT

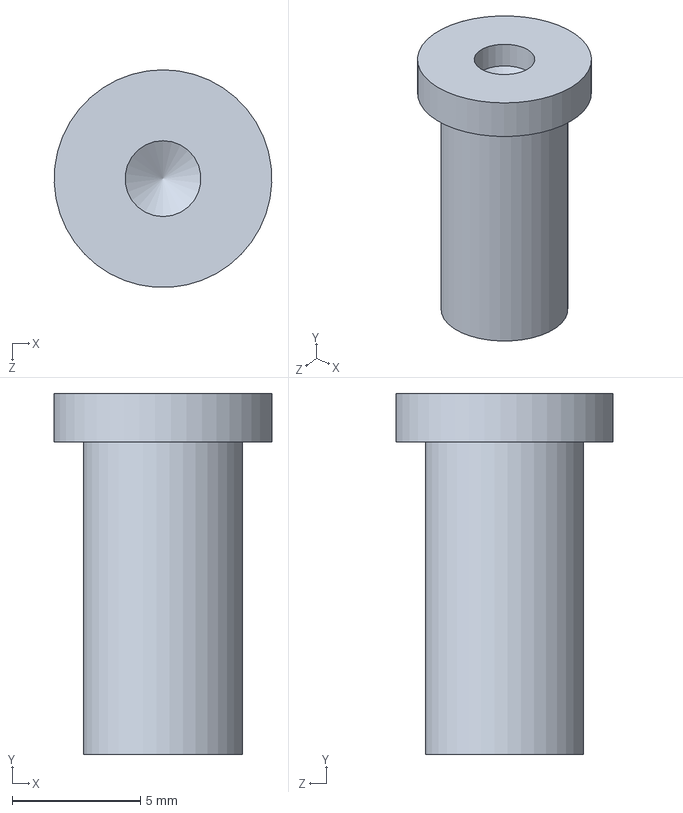
[picture p63: CAD file, 2024-04-25]
CAD/vitphi6.2.SLDPRT
8.50 x 14.1 x 8.49 mm
