MynhLoveBunCha/project_1_undergraduate/CAD/khau2_arm.SLDPRT

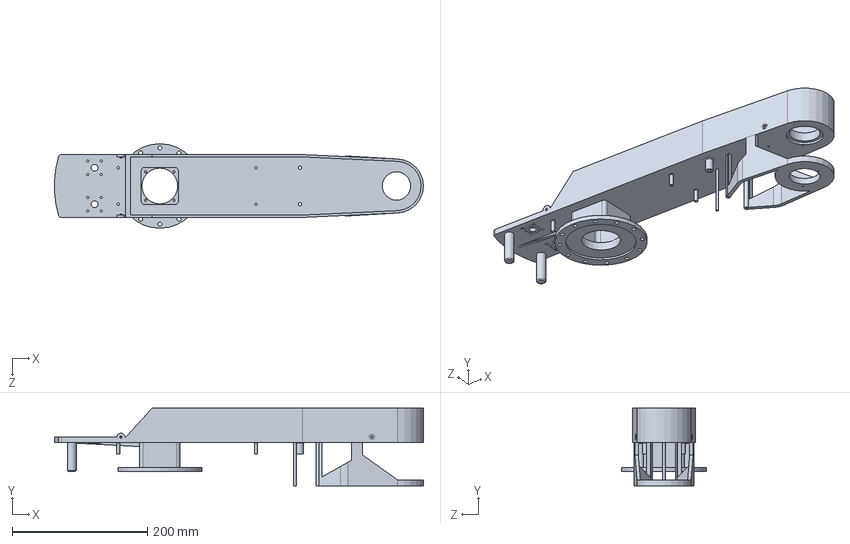
[picture p64: CAD file, 2024-04-25]
CAD/khau2_arm.SLDPRT
545.8 x 115.0 x 125.0 mm
