MynhLoveBunCha/project_1_undergraduate/references/ĐATKHTCK/đai2.SLDPRT

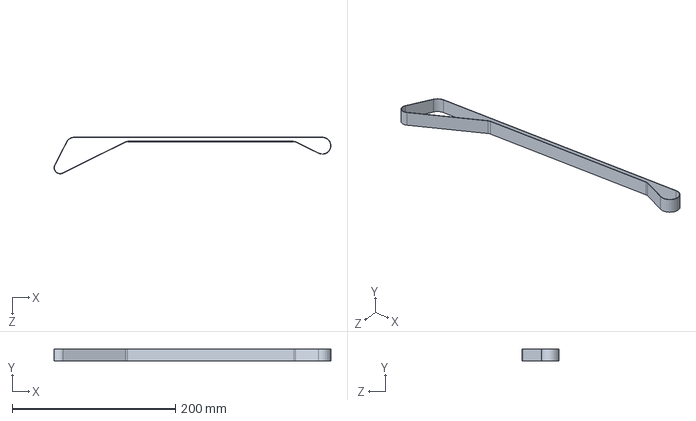
[picture p65: CAD file, 2024-04-25]
references/ĐATKHTCK/đai2.SLDPRT
339.2 x 15.0 x 45.0 mm
