MynhLoveBunCha/project_1_undergraduate/CAD/khau0_base_support.SLDPRT

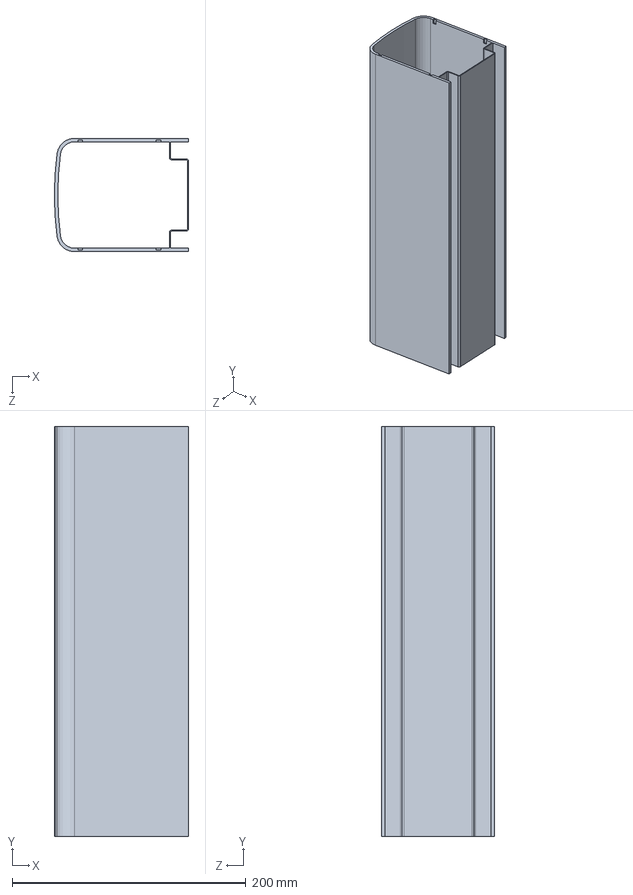
[picture p66: CAD file, 2024-04-25]
CAD/khau0_base_support.SLDPRT
115.0 x 351.1 x 97.0 mm
