MynhLoveBunCha/project_1_undergraduate/references/ĐATKHTCK/matdemchuan.SLDPRT

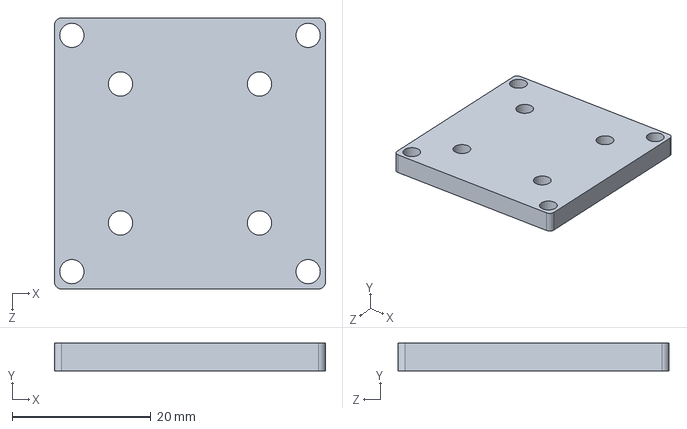
[picture p67: CAD file, 2024-04-25]
references/ĐATKHTCK/matdemchuan.SLDPRT
39.0 x 4.00 x 39.0 mm
