MynhLoveBunCha/project_1_undergraduate/references/ĐATKHTCK/vongbi.SLDPRT

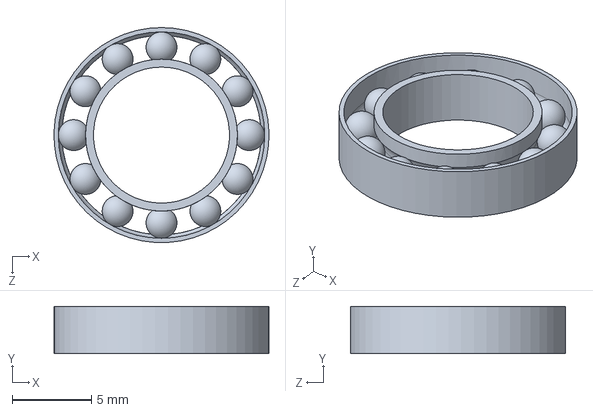
[picture p68: CAD file, 2024-04-25]
references/ĐATKHTCK/vongbi.SLDPRT
13.6 x 3.00 x 13.6 mm
