MynhLoveBunCha/project_1_undergraduate/CAD/pulykhop3_11.SLDPRT

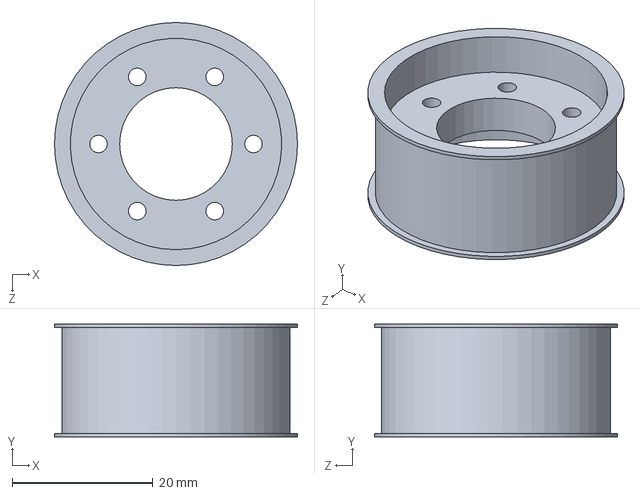
[picture p69: CAD file, 2024-04-25]
CAD/pulykhop3_11.SLDPRT
34.5 x 16.0 x 34.5 mm
