MynhLoveBunCha/project_1_undergraduate/references/ĐATKHTCK/pulyphu18.SLDPRT

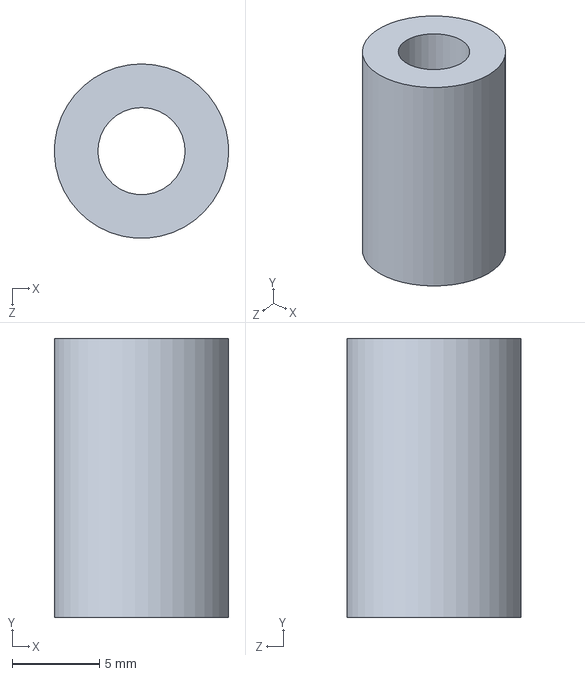
[picture p70: CAD file, 2024-04-25]
references/ĐATKHTCK/pulyphu18.SLDPRT
9.99 x 16.0 x 9.99 mm
