MynhLoveBunCha/project_1_undergraduate/CAD/vit3.5.SLDPRT

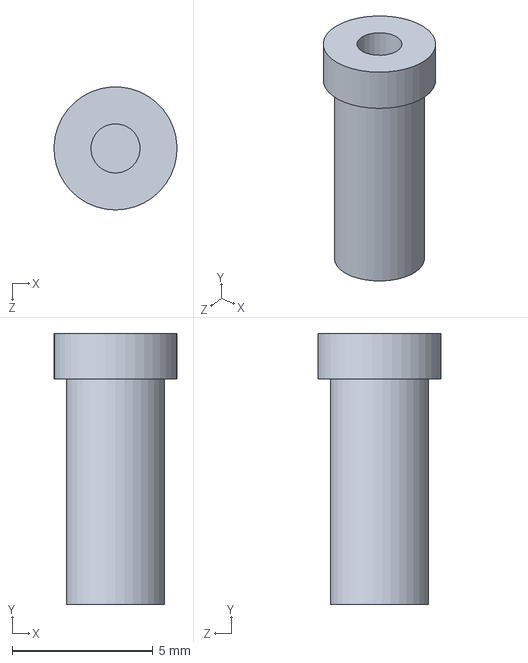
[picture p71: CAD file, 2024-04-25]
CAD/vit3.5.SLDPRT
4.37 x 9.62 x 4.36 mm
