MynhLoveBunCha/project_1_undergraduate/references/ĐATKHTCK/khau0khaude.SLDPRT

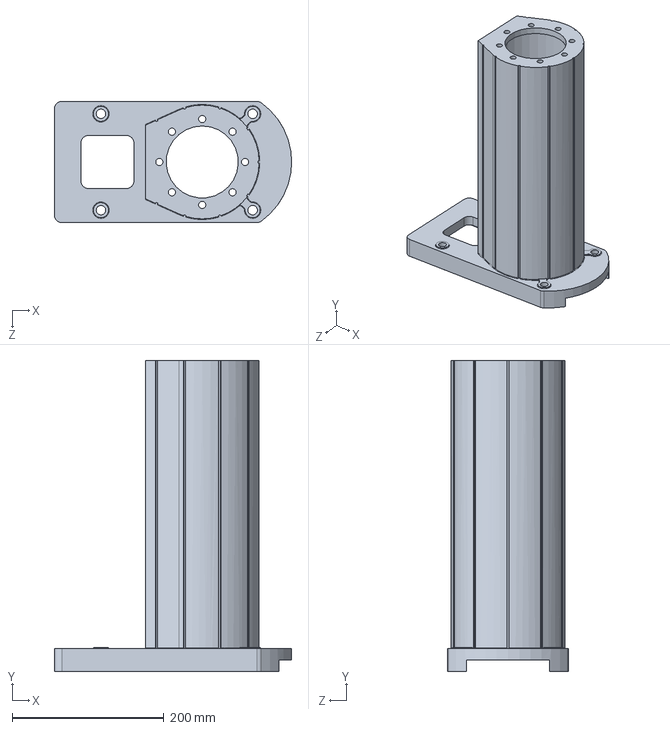
[picture p72: CAD file, 2024-04-25]
references/ĐATKHTCK/khau0khaude.SLDPRT
312.9 x 410.0 x 160.0 mm
