MynhLoveBunCha/project_1_undergraduate/CAD/vitphi2.6dai12.5.SLDPRT

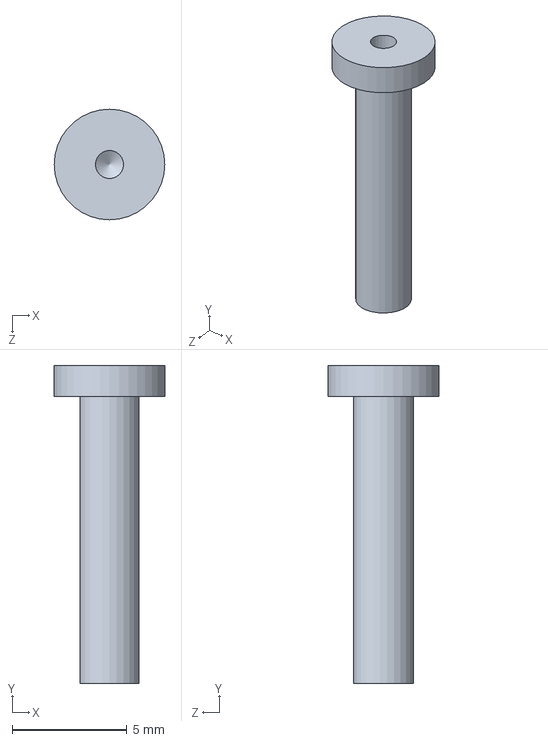
[picture p73: CAD file, 2024-04-25]
CAD/vitphi2.6dai12.5.SLDPRT
4.82 x 13.9 x 4.82 mm
