MynhLoveBunCha/project_1_undergraduate/references/ĐATKHTCK/khop3.SLDPRT

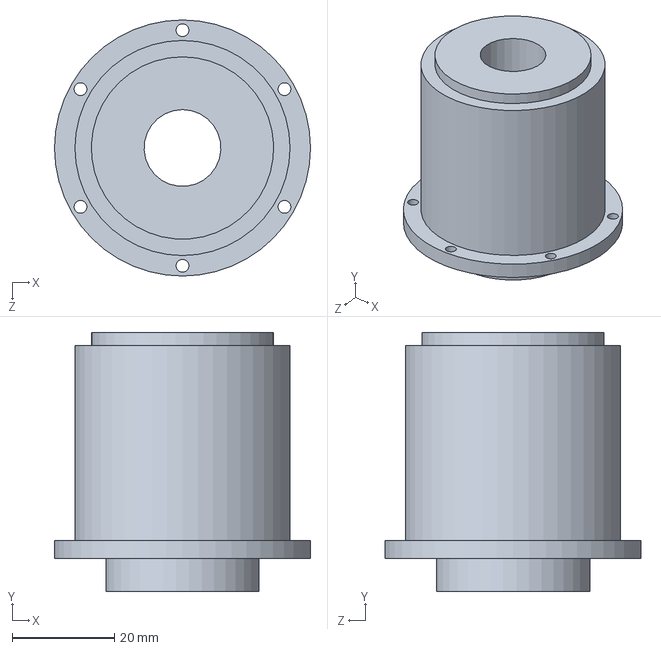
[picture p74: CAD file, 2024-04-25]
references/ĐATKHTCK/khop3.SLDPRT
50.0 x 50.6 x 50.0 mm
