MynhLoveBunCha/project_1_undergraduate/references/ĐATKHTCK/ganvoikhaude.SLDPRT

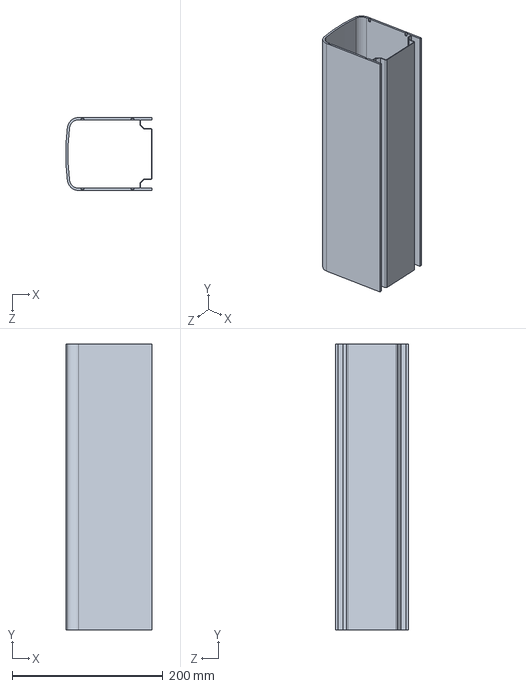
[picture p75: CAD file, 2024-04-25]
references/ĐATKHTCK/ganvoikhaude.SLDPRT
114.7 x 380.0 x 97.0 mm
