MynhLoveBunCha/project_1_undergraduate/CAD/khau0_base.SLDPRT

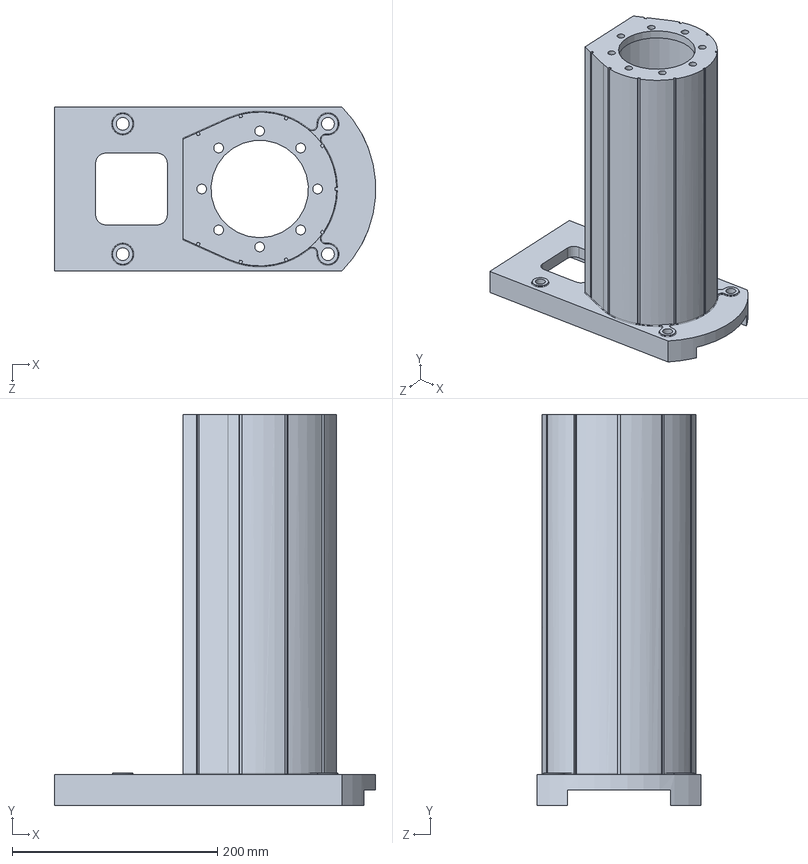
[picture p76: CAD file, 2024-04-25]
CAD/khau0_base.SLDPRT
312.8 x 381.1 x 160.0 mm
