MynhLoveBunCha/project_1_undergraduate/references/ĐATKHTCK/vit1.SLDPRT

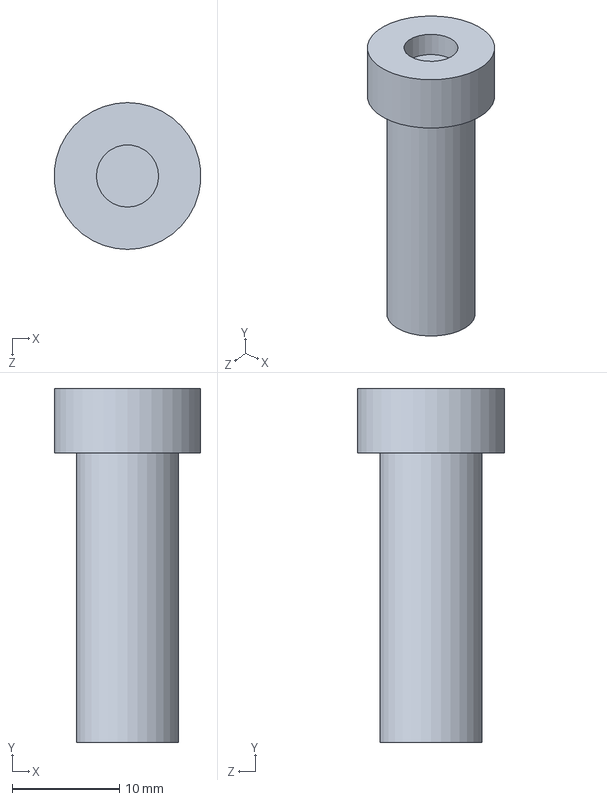
[picture p77: CAD file, 2024-04-25]
references/ĐATKHTCK/vit1.SLDPRT
13.6 x 33.0 x 13.7 mm
