MynhLoveBunCha/project_1_undergraduate/CAD/speed_reducer.SLDPRT

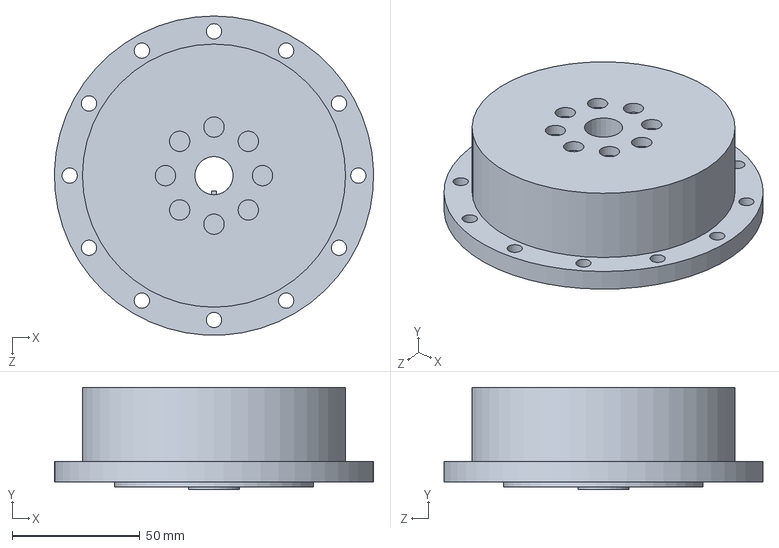
[picture p78: CAD file, 2024-04-25]
CAD/speed_reducer.SLDPRT
124.9 x 40.0 x 124.9 mm
