MynhLoveBunCha/project_1_undergraduate/references/ĐATKHTCK/vỏ khâu 2.SLDPRT

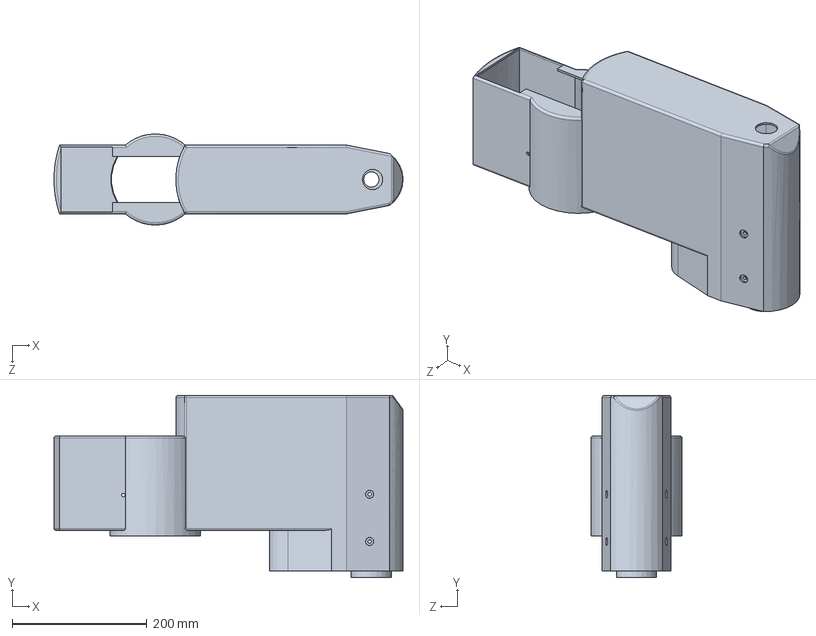
[picture p79: CAD file, 2024-04-25]
references/ĐATKHTCK/vỏ khâu 2.SLDPRT
517.1 x 270.0 x 135.0 mm
