MynhLoveBunCha/project_1_undergraduate/CAD/vitphi8.2.SLDPRT

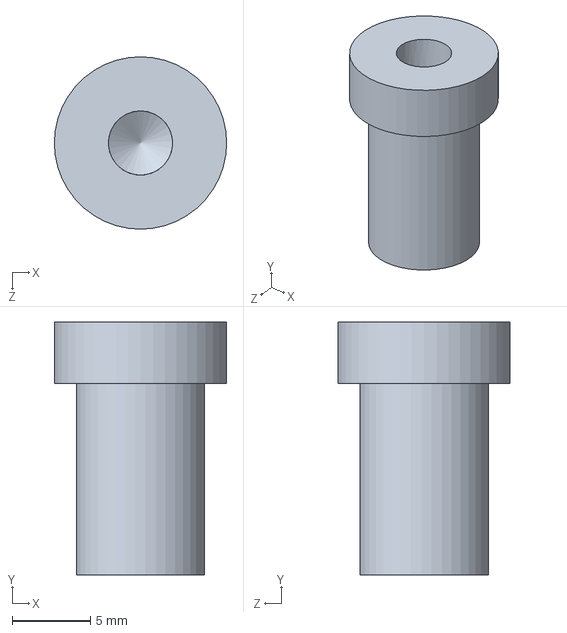
[picture p80: CAD file, 2024-04-25]
CAD/vitphi8.2.SLDPRT
11.0 x 16.1 x 11.0 mm
