MynhLoveBunCha/project_1_undergraduate/references/ĐATKHTCK/vitphi2.SLDPRT

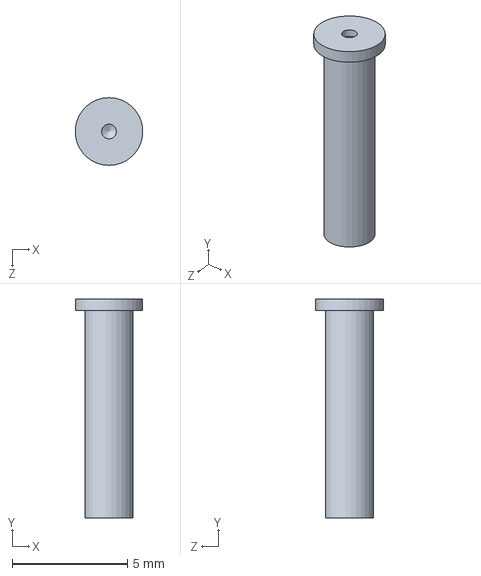
[picture p81: CAD file, 2024-04-25]
references/ĐATKHTCK/vitphi2.SLDPRT
2.92 x 9.50 x 2.94 mm
