MynhLoveBunCha/project_1_undergraduate/CAD/khau2_cover.SLDPRT

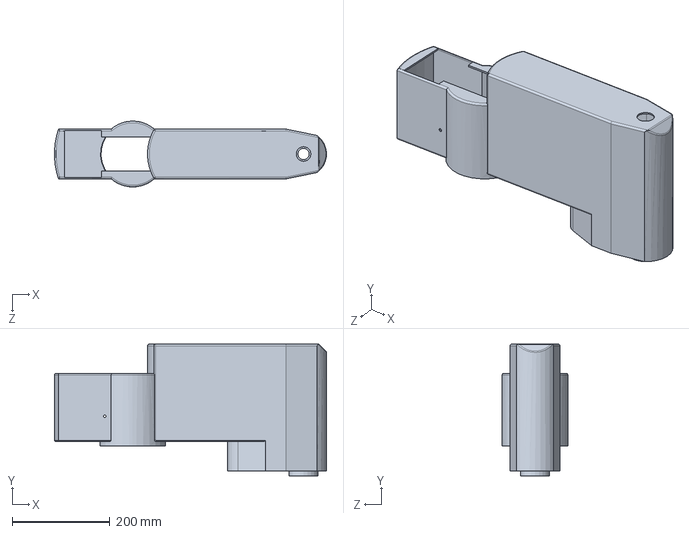
[picture p82: CAD file, 2024-04-25]
CAD/khau2_cover.SLDPRT
557.3 x 270.0 x 135.0 mm
