MynhLoveBunCha/project_1_undergraduate/CAD/vitphi4.SLDPRT

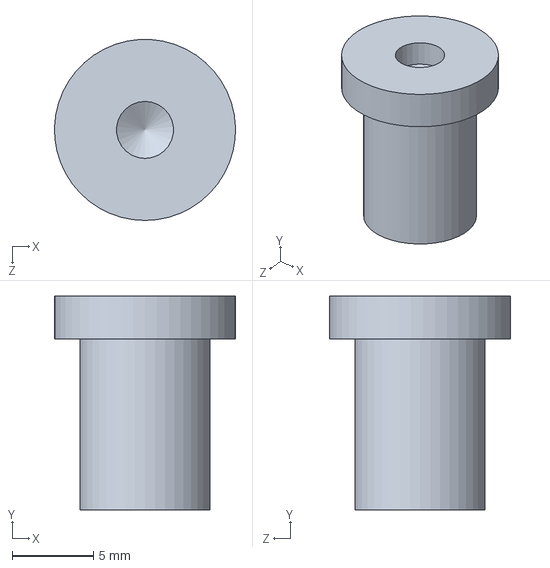
[picture p83: CAD file, 2024-04-25]
CAD/vitphi4.SLDPRT
11.1 x 13.1 x 11.1 mm
