MynhLoveBunCha/project_1_undergraduate/CAD/pulyphu.SLDPRT

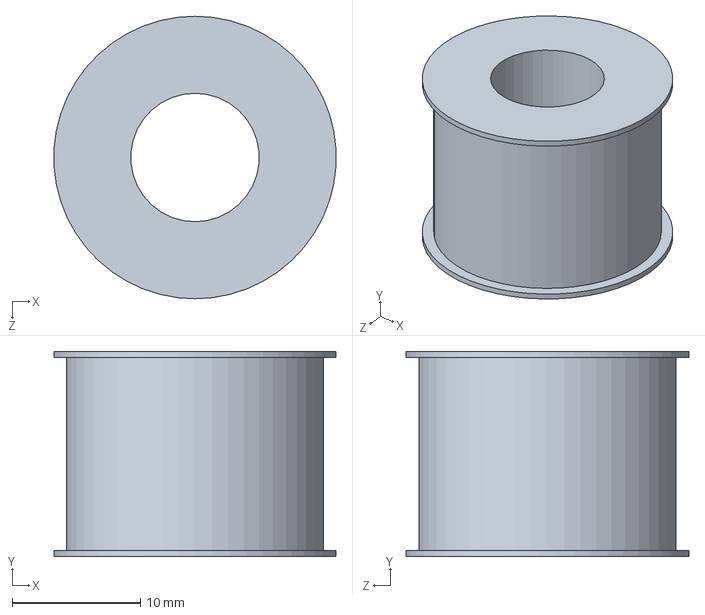
[picture p84: CAD file, 2024-04-25]
CAD/pulyphu.SLDPRT
22.0 x 16.0 x 22.0 mm
