MynhLoveBunCha/project_1_undergraduate/references/ĐATKHTCK/khau3.SLDPRT

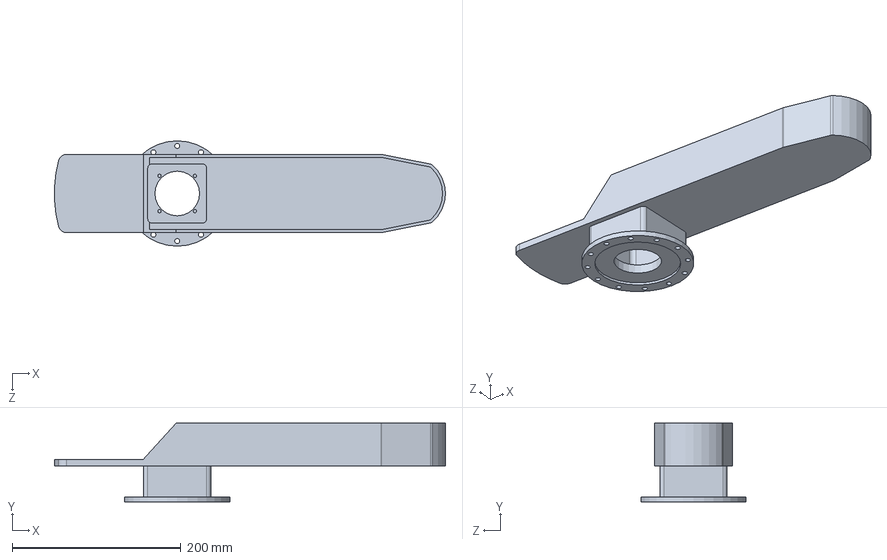
[picture p85: CAD file, 2024-04-25]
references/ĐATKHTCK/khau3.SLDPRT
463.9 x 93.5 x 125.0 mm
