MynhLoveBunCha/project_1_undergraduate/references/ĐATKHTCK/vitdut.SLDPRT

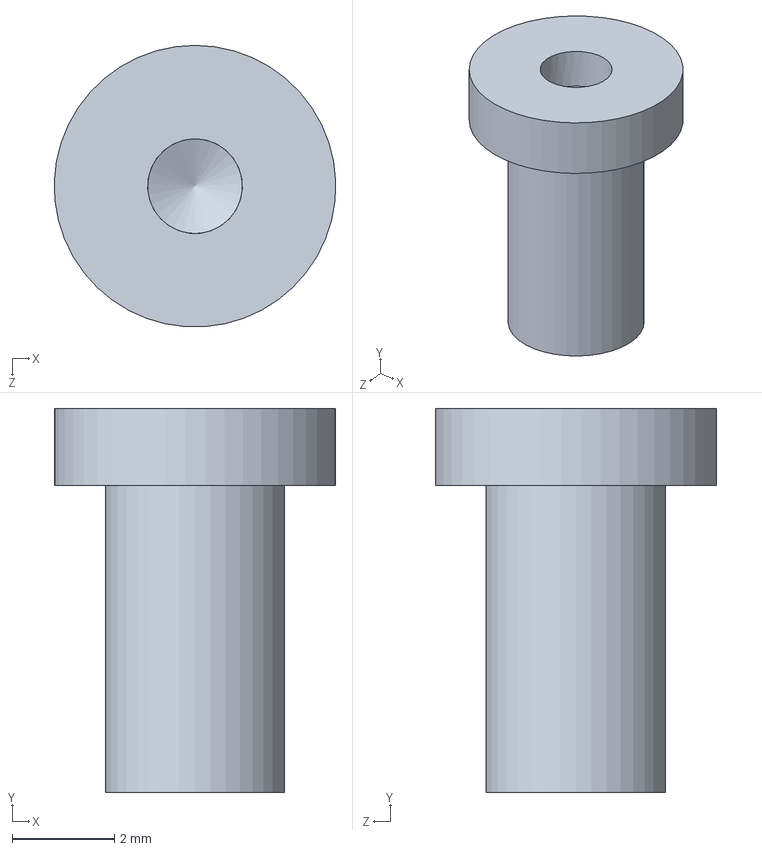
[picture p86: CAD file, 2024-04-25]
references/ĐATKHTCK/vitdut.SLDPRT
5.50 x 7.50 x 5.49 mm
