MynhLoveBunCha/project_1_undergraduate/CAD/vitchung.SLDPRT

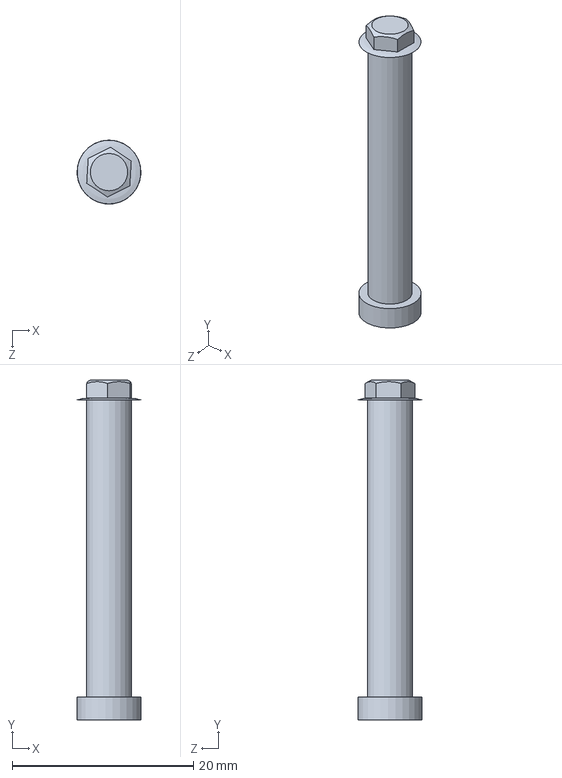
[picture p87: CAD file, 2024-04-25]
CAD/vitchung.SLDPRT
7.06 x 37.5 x 7.05 mm
