MynhLoveBunCha/project_1_undergraduate/CAD/moto2.SLDPRT

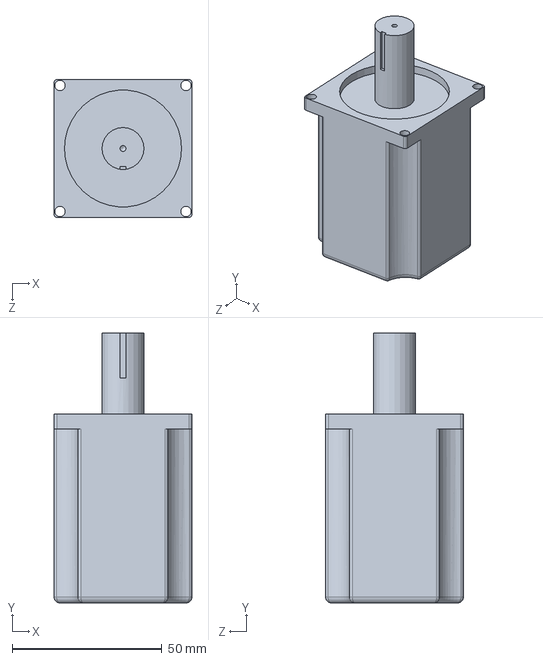
[picture p88: CAD file, 2024-04-25]
CAD/moto2.SLDPRT
46.0 x 90.0 x 46.0 mm
