MynhLoveBunCha/project_1_undergraduate/references/ĐATKHTCK/Khau2.SLDPRT

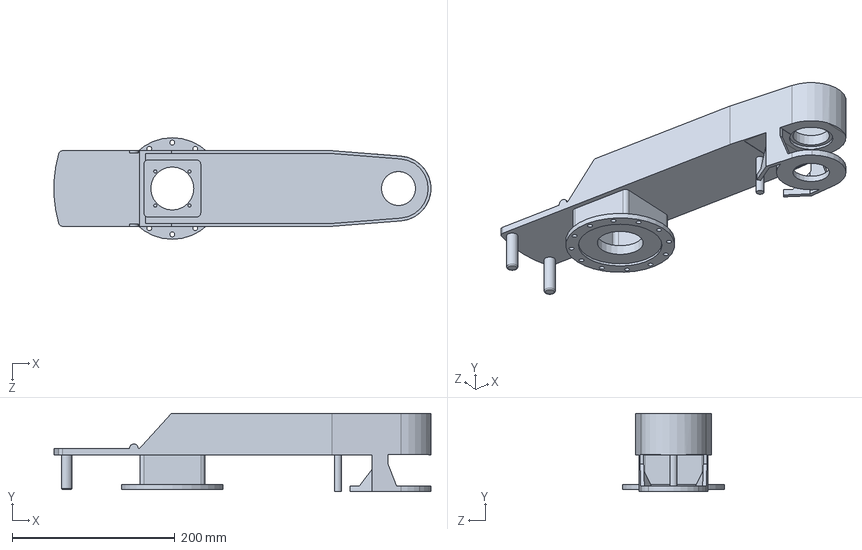
[picture p89: CAD file, 2024-04-25]
references/ĐATKHTCK/Khau2.SLDPRT
463.9 x 96.0 x 125.0 mm
