MynhLoveBunCha/project_1_undergraduate/CAD/end_effector.SLDPRT

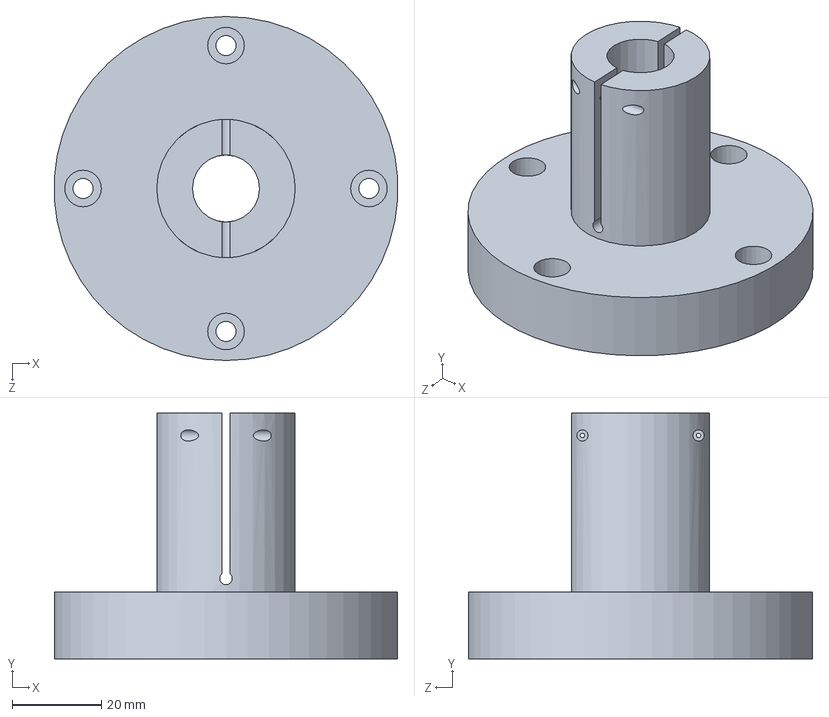
[picture p90: CAD file, 2024-04-25]
CAD/end_effector.SLDPRT
76.8 x 55.0 x 77.0 mm
