MynhLoveBunCha/project_1_undergraduate/CAD/đai1.SLDPRT

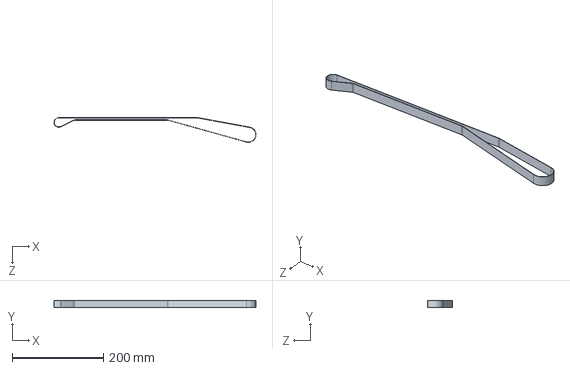
[picture p91: CAD file, 2024-04-25]
CAD/đai1.SLDPRT
443.7 x 15.0 x 54.2 mm
