MynhLoveBunCha/project_1_undergraduate/references/ĐATKHTCK/khau 5.SLDPRT

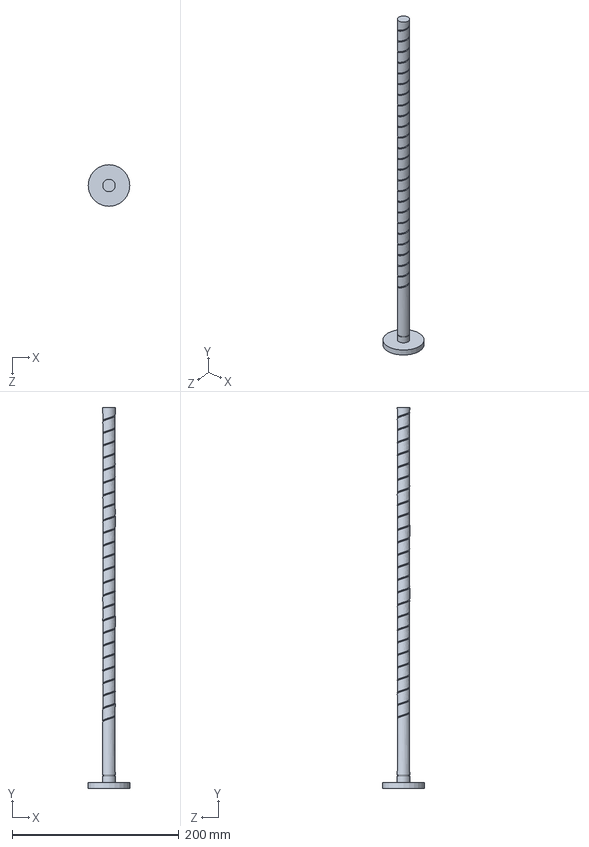
[picture p92: CAD file, 2024-04-25]
references/ĐATKHTCK/khau 5.SLDPRT
50.0 x 457.0 x 50.0 mm
