MynhLoveBunCha/project_1_undergraduate/CAD/khau1_arm.SLDPRT

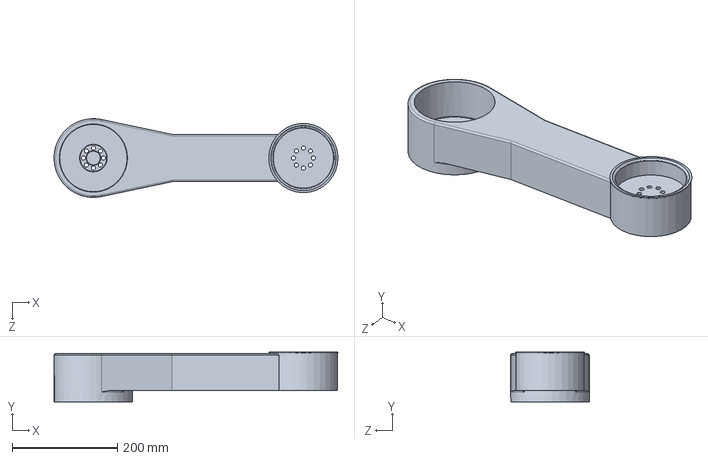
[picture p93: CAD file, 2024-04-25]
CAD/khau1_arm.SLDPRT
540.9 x 95.0 x 149.8 mm
