MynhLoveBunCha/project_1_undergraduate/references/ĐATKHTCK/vitconap.SLDPRT

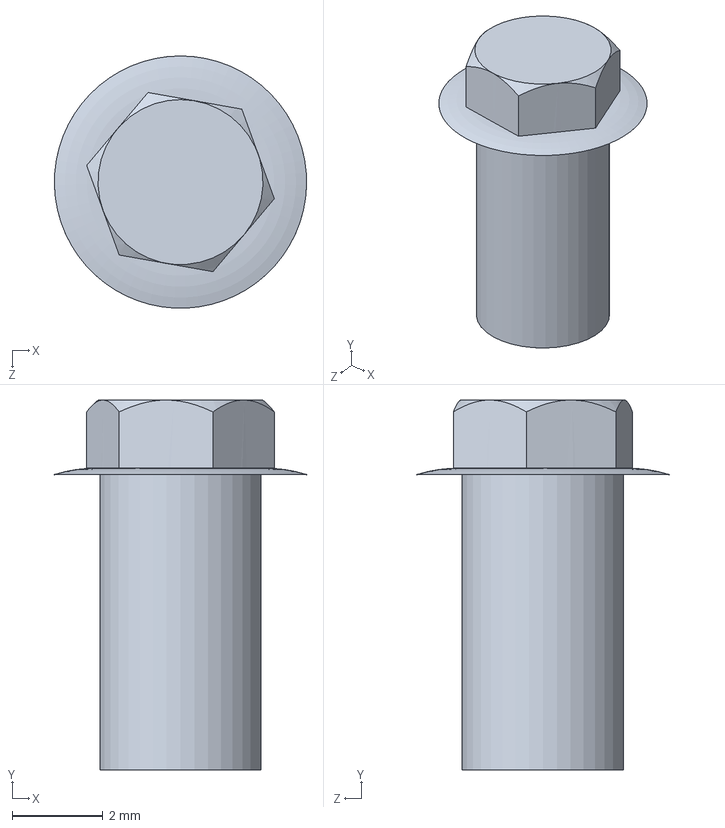
[picture p94: CAD file, 2024-04-25]
references/ĐATKHTCK/vitconap.SLDPRT
5.55 x 8.14 x 5.55 mm
