MynhLoveBunCha/project_1_undergraduate/references/ĐATKHTCK/khau2chuan.SLDPRT

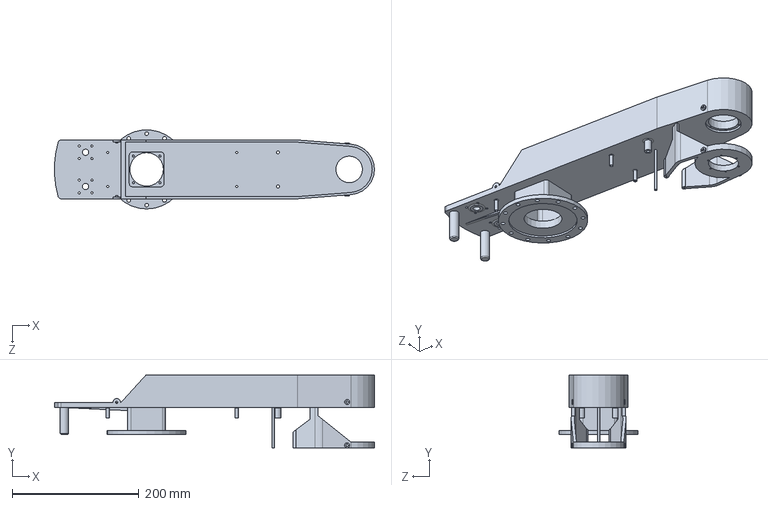
[picture p95: CAD file, 2024-04-25]
references/ĐATKHTCK/khau2chuan.SLDPRT
505.6 x 115.0 x 124.7 mm
