MynhLoveBunCha/project_1_undergraduate/(list of files, cad)

Other CAD files:
references/ĐATKHTCK/Assemtoithu10.SLDASM
references/ĐATKHTCK/ĐAHTKCk1.SLDASM
references/ĐATKHTCK/Total.SLDASM
references/ĐATKHTCK/khaudeganvoikhau1.SLDPRT
references/ĐATKHTCK/moto0.SLDPRT
references/ĐATKHTCK/khau1.SLDPRT
references/ĐATKHTCK/ụ tròn xoay.SLDPRT
CAD/complete_v1.SLDDRW
CAD/lead_screw.SLDPRT
NX_test/lmao.prt
NX_test/test_nx.prt
references/ĐATKHTCK/banvelaptongthe.SLDDRW
references/ĐATKHTCK/banvelaptongthe2.SLDDRW
references/ĐATKHTCK/bản vẽ cắt end.SLDDRW
references/ĐATKHTCK/khau1.SLDDRW
references/ĐATKHTCK/khau2chuan.SLDDRW
