MynhLoveBunCha/project_1_undergraduate/all_drawing.pdf

A | 0.01
A | 0.02

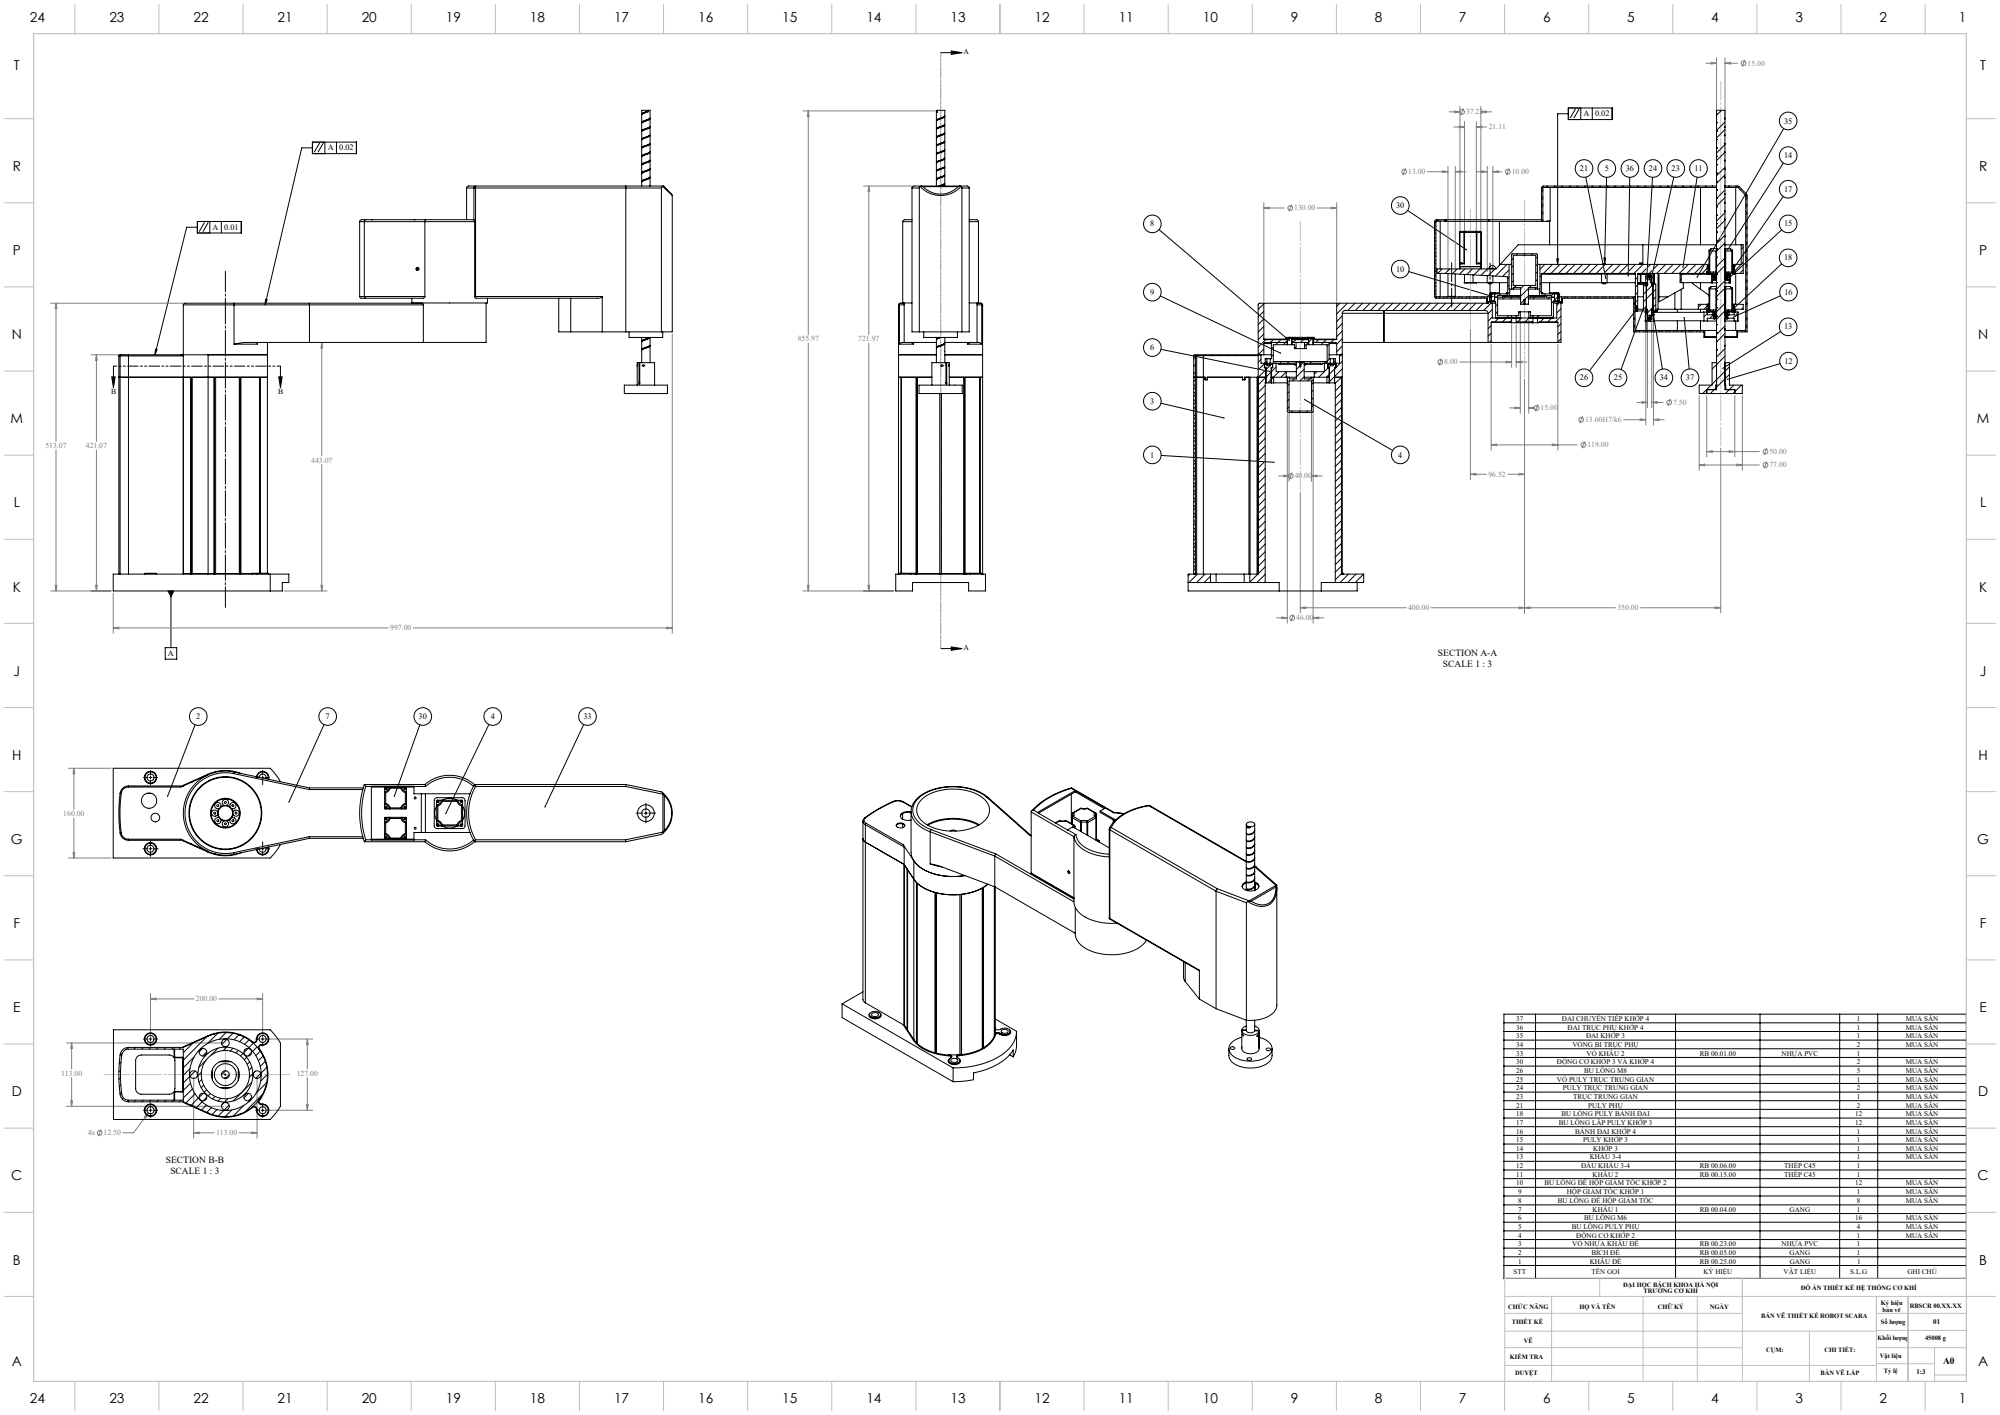
[picture p96: page 1]
SECTION A-A SCALE 1 : 3; SECTION B-B SCALE 1 : 3; ĐAI CHUYỂN TIẾP KHỚP 4; MUA SẴN; ĐAI TRỤC PHỤ KHỚP 4; ĐAI KHỚP 3; VÒNG BI TRỤC PHỤ; VỎ KHÂU 2; NHỰA PVC; ĐỘNG CƠ KHỚP 3 VÀ KHỚP 4; BU LÔNG M8; VỎ PULY TRỤC TRUNG GIAN; PULY TRỤC TRUNG GIAN; TRỤC TRUNG GIAN; PULY PHỤ; BU LÔNG PULY BÁNH ĐAI; BU LÔNG LẮP PULY KHỚP 3; BÁNH ĐAI KHỚP 4; PULY KHỚP 3; KHỚP 3; KHÂU 3-4; ĐẦU KHÂU 3-4; THÉP C45; KHÂU 2; BU LÔNG ĐẾ HỘP GIẢM TỐC KHỚP 2; HỘP GIẢM TỐC KHỚP 1; BU LÔNG ĐẾ HỘP GIẢM TỐC; KHÂU 1; GANG; BU LÔNG M6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

ĐẠI HỌC BÁCH KHOA HÀ NỘI
TRƯỜNG CƠ KHÍ

ĐỒ ÁN THIẾT KẾ HỆ THỐNG CƠ KHÍ

BẢN VẼ THIẾT KẾ ROBOT SCARA

BẢN VẼ LẮP

419.07

262.69 | 150.00

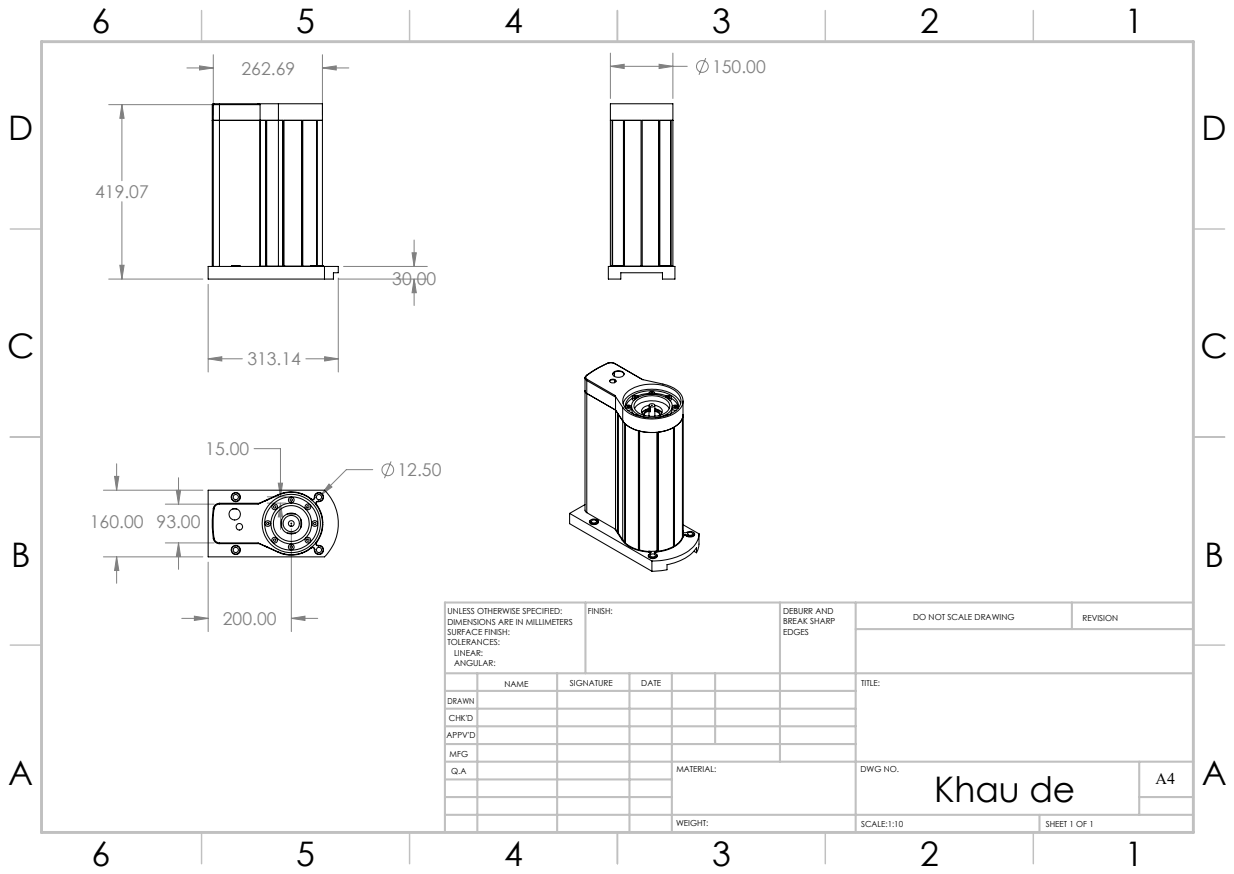
[picture p97: page 2]
FINISH:; DEBURR AND; BREAK SHARP EDGES; DO NOT SCALE DRAWING; REVISION; SCALE:1:10; SHEET 1 OF 1; WEIGHT:

UNLESS OTHERWISE SPECIFIED:
DIMENSIONS ARE IN MILLIMETERS
SURFACE FINISH:
TOLERANCES:
LINEAR:
ANGULAR:

NAME | SIGNATURE | DATE | | | | TITLE:

DRAWN
CHK'D
APPV'D
MFG
Q.A | | | | MATERIAL: | DWG NO. Khau de | A4

73.00 92.00 | 70.00

132.00

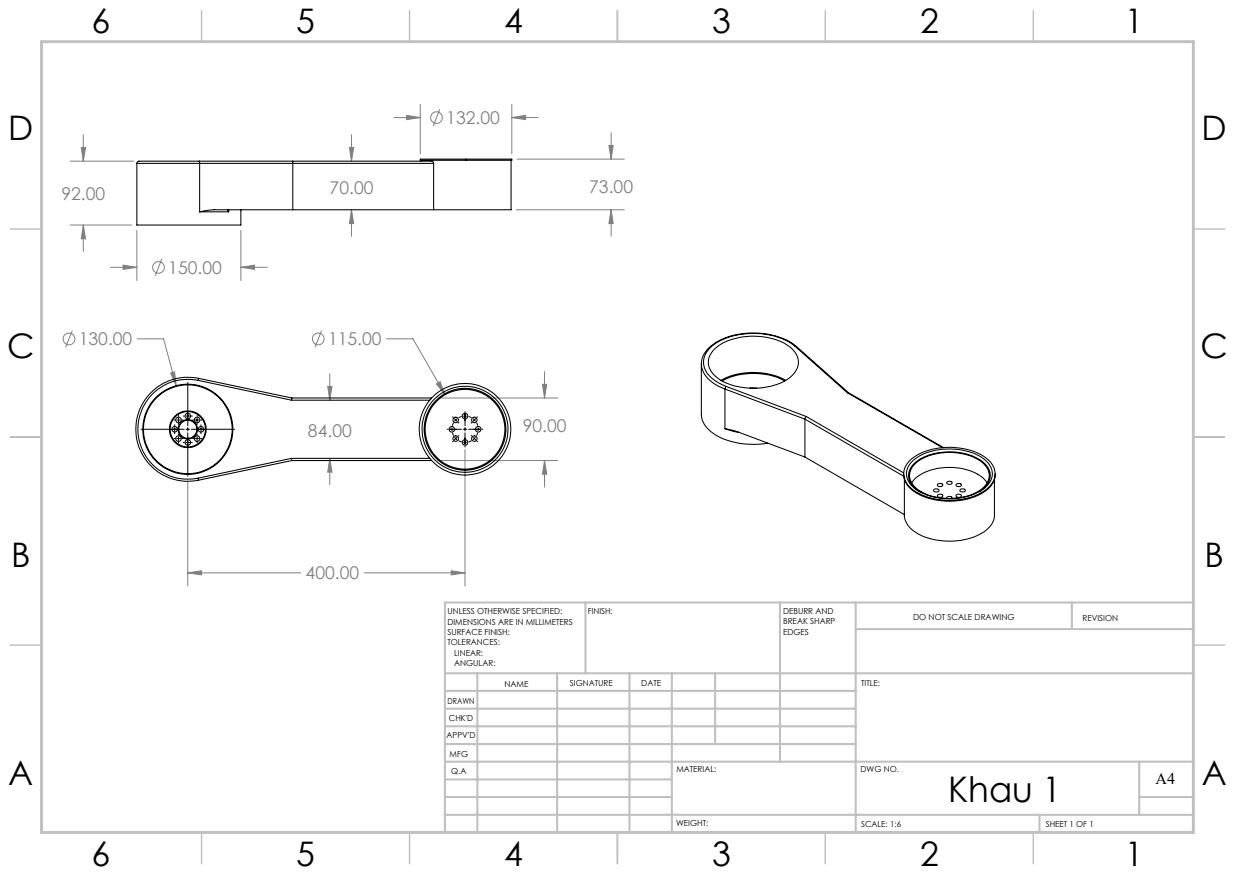
[picture p98: page 3]
FINISH:; DEBURR AND; BREAK SHARP EDGES; DO NOT SCALE DRAWING; REVISION; SCALE: 1:6; SHEET 1 OF 1

UNLESS OTHERWISE SPECIFIED:
DIMENSIONS ARE IN MILLIMETERS
SURFACE FINISH:
TOLERANCES:
LINEAR:
ANGULAR:

NAME | SIGNATURE | DATE | | | | TITLE:

DRAWN
CHK'D
APPV'D
MFG
Q.A | | | | MATERIAL: | DWG NO. Khau 1 | A4

115.00

51.00

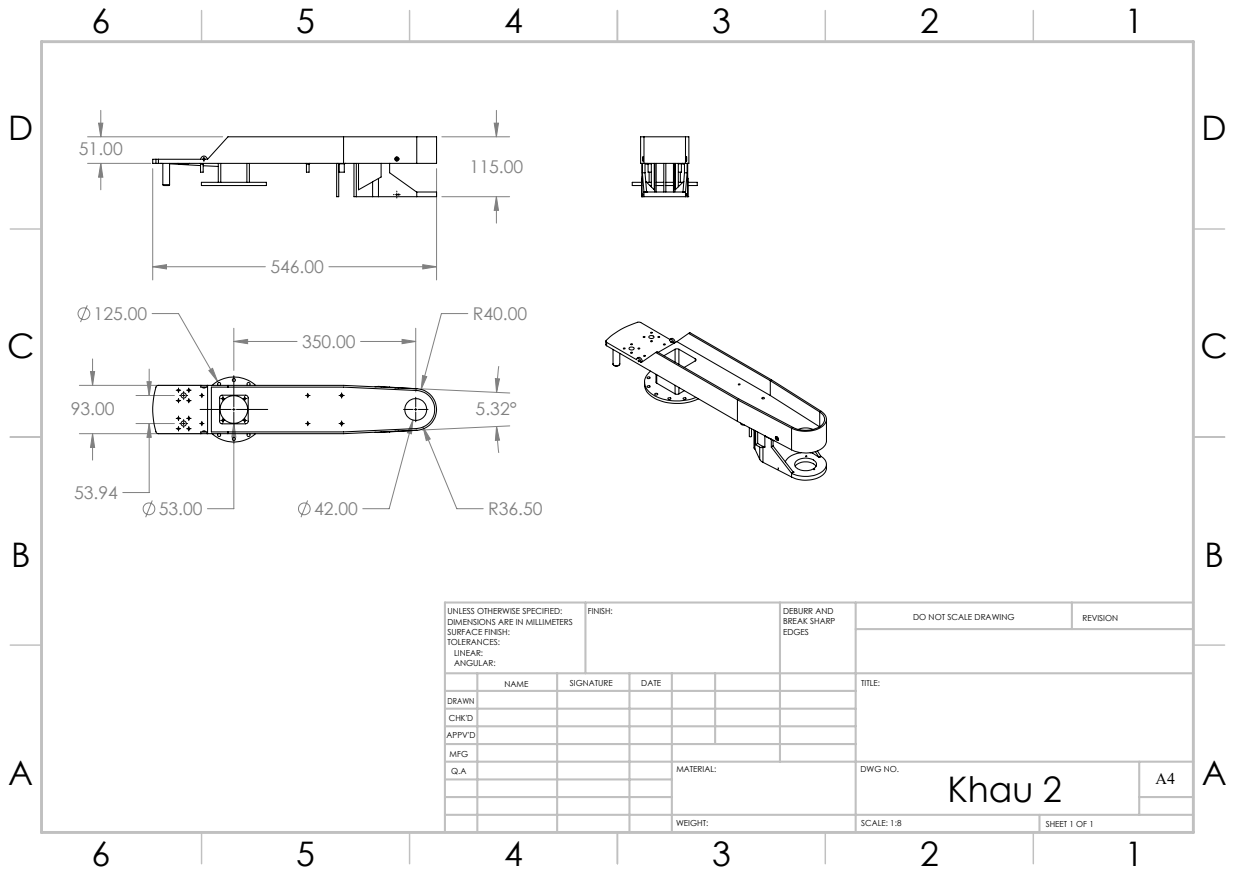
[picture p99: page 4]
FINISH:; DEBURR AND; BREAK SHARP EDGES; DO NOT SCALE DRAWING; REVISION; SCALE: 1:8; SHEET 1 OF 1

UNLESS OTHERWISE SPECIFIED:
DIMENSIONS ARE IN MILLIMETERS
SURFACE FINISH:
TOLERANCES:
LINEAR:
ANGULAR:

NAME | SIGNATURE | DATE | | | | TITLE:

DRAWN
CHK'D
APPV'D
MFG
Q.A | | | | MATERIAL: | DWG NO. Khau 2 | A4

15.00
D | D

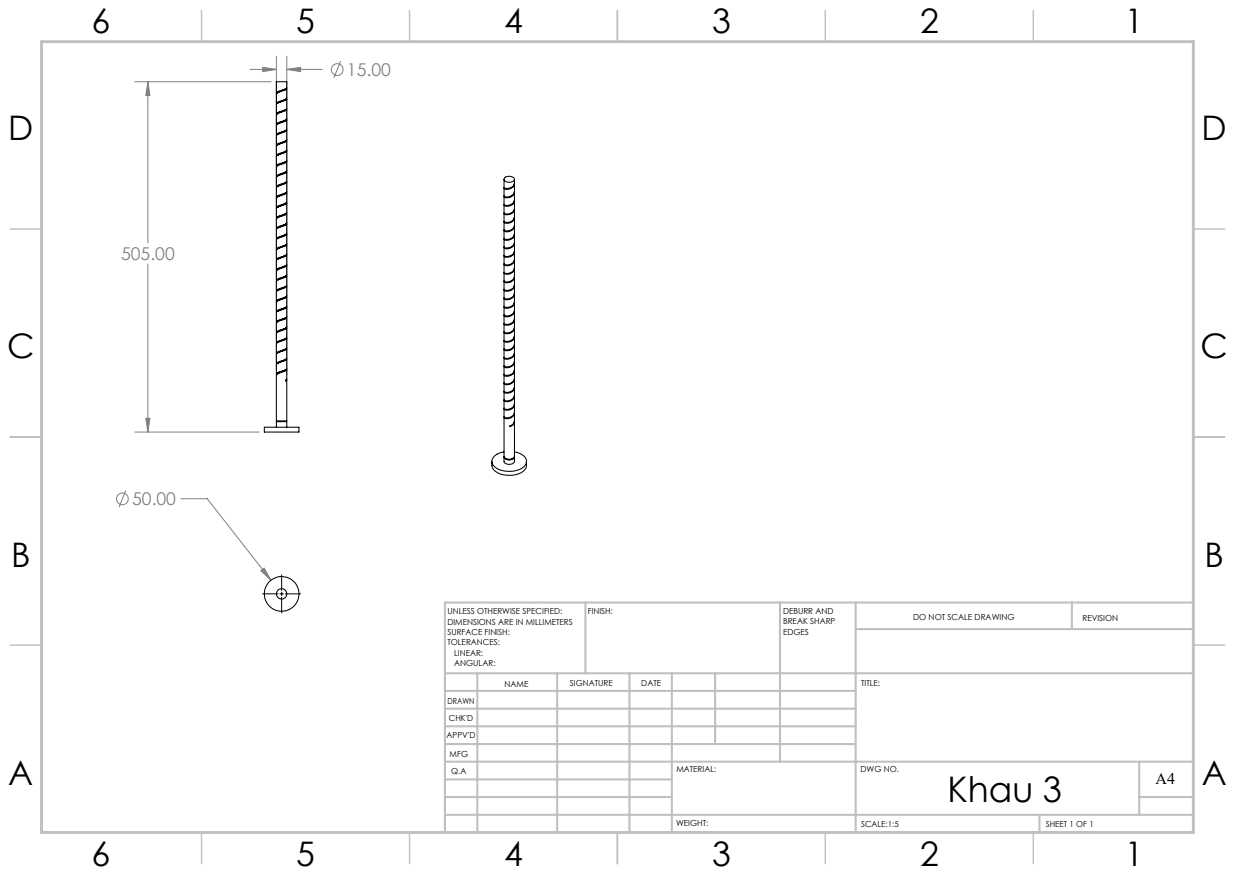
[picture p100: page 5]
FINISH:; DEBURR AND; BREAK SHARP EDGES; DO NOT SCALE DRAWING; REVISION; SCALE:1:5; SHEET 1 OF 1

UNLESS OTHERWISE SPECIFIED:
DIMENSIONS ARE IN MILLIMETERS
SURFACE FINISH:
TOLERANCES:
LINEAR:
ANGULAR:

NAME | SIGNATURE | DATE | | | | TITLE:

DRAWN
CHK'D
APPV'D
MFG
Q.A | | | | MATERIAL: | DWG NO. Khau 3 | A4

31.00
1.80

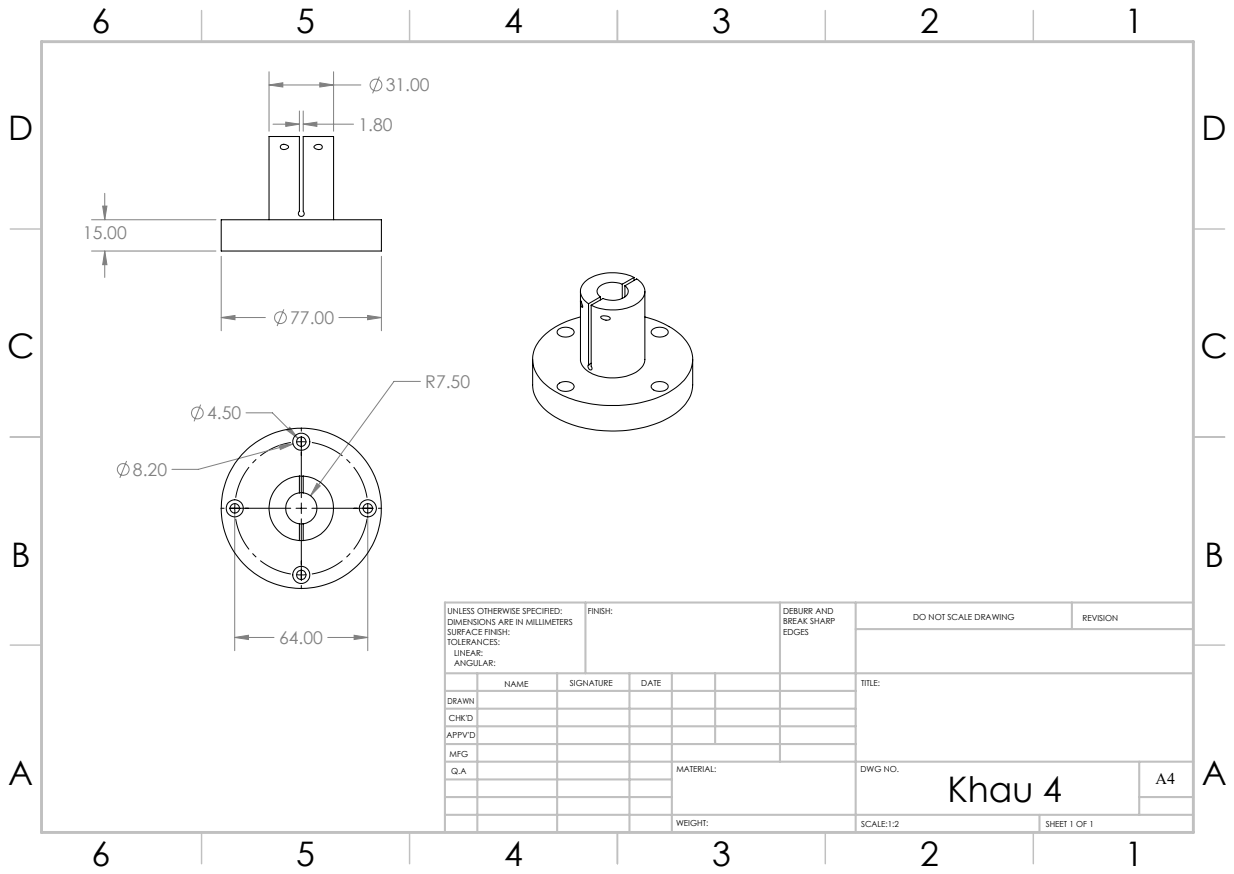
[picture p101: page 6]
FINISH:; DEBURR AND; BREAK SHARP EDGES; DO NOT SCALE DRAWING; REVISION; SCALE:1:2; SHEET 1 OF 1

UNLESS OTHERWISE SPECIFIED:
DIMENSIONS ARE IN MILLIMETERS
SURFACE FINISH:
TOLERANCES:
LINEAR:
ANGULAR:

NAME | SIGNATURE | DATE | | | | TITLE:

DRAWN
CHK'D
APPV'D
MFG
Q.A | | | | MATERIAL: | DWG NO. Khau 4 | A4
